NovaPrime18/CompressorController/Hardware/audit/board.png

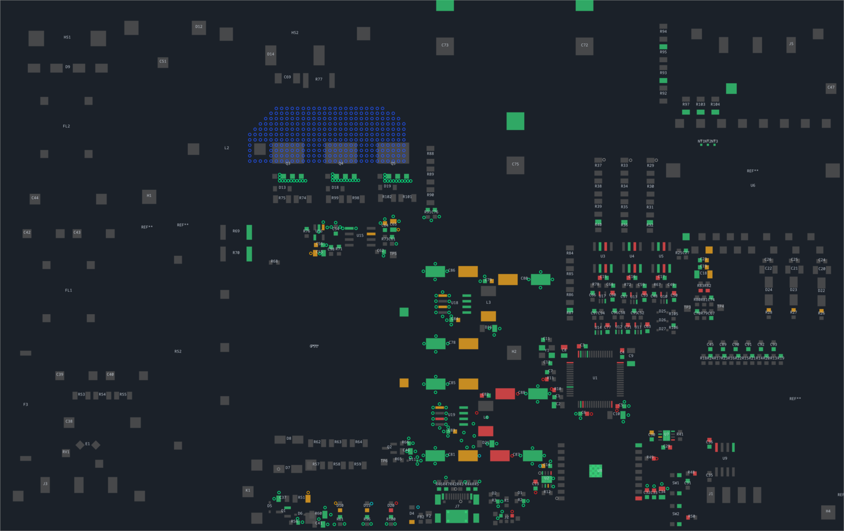
Hardware/audit/board.png
