NovaPrime18/CompressorController/Hardware/audit/can.png

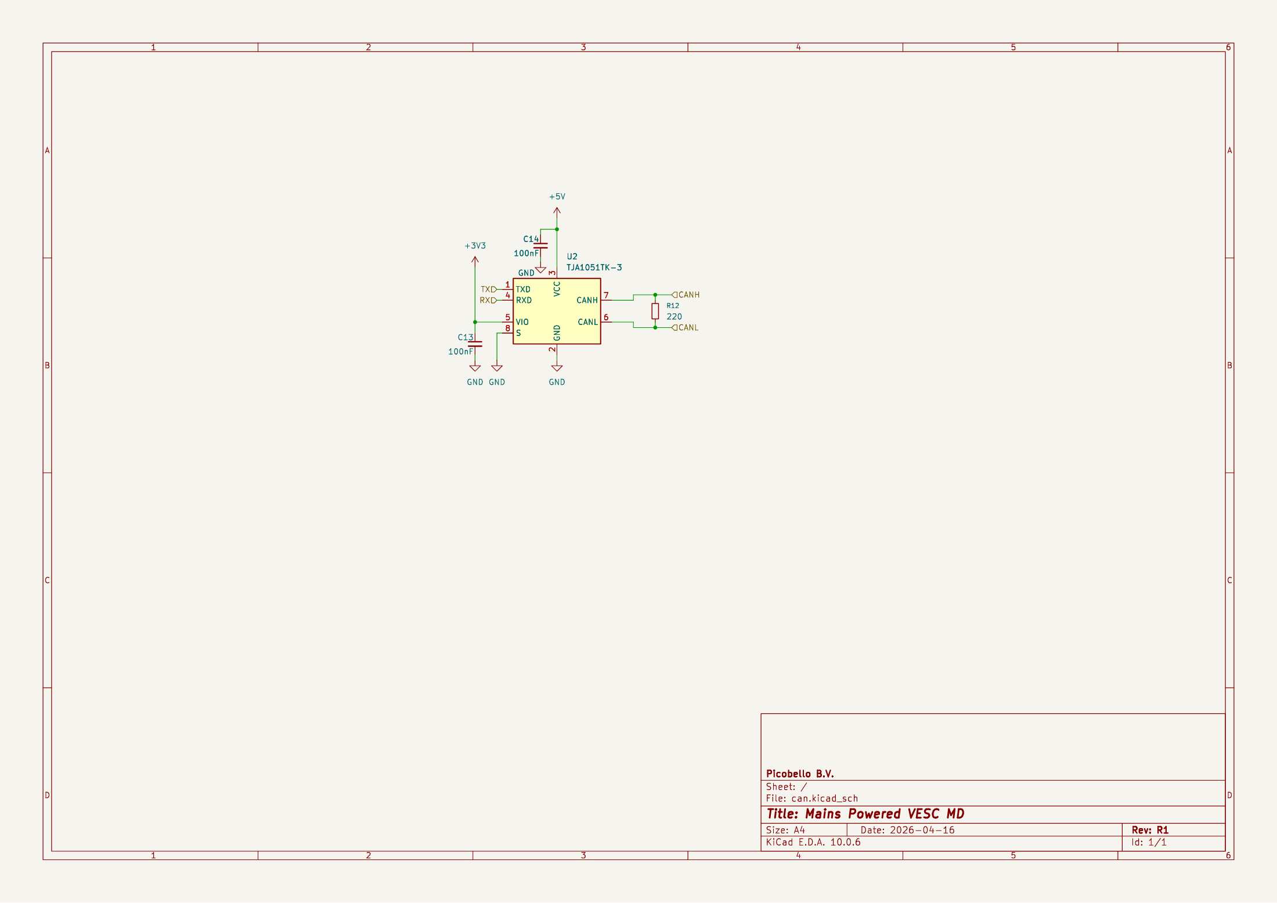
Hardware/audit/can.png
