NovaPrime18/CompressorController/Hardware/audit/crop_mask.png

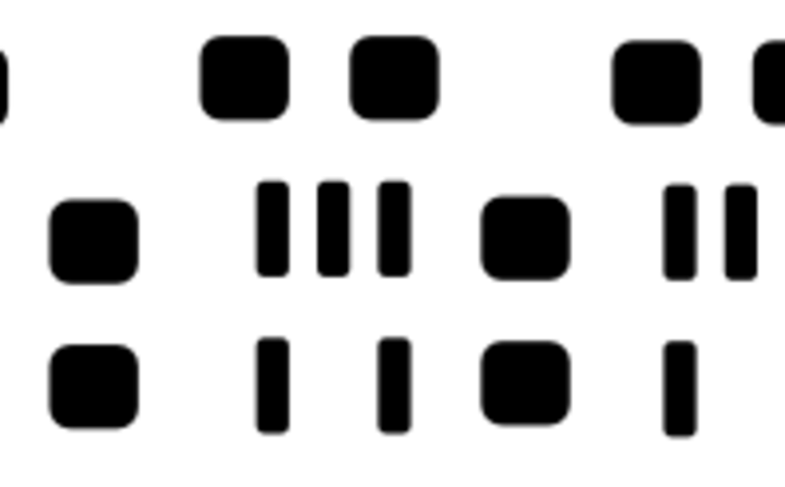
Hardware/audit/crop_mask.png
