NovaPrime18/CompressorController/Hardware/audit/crop_u12.png

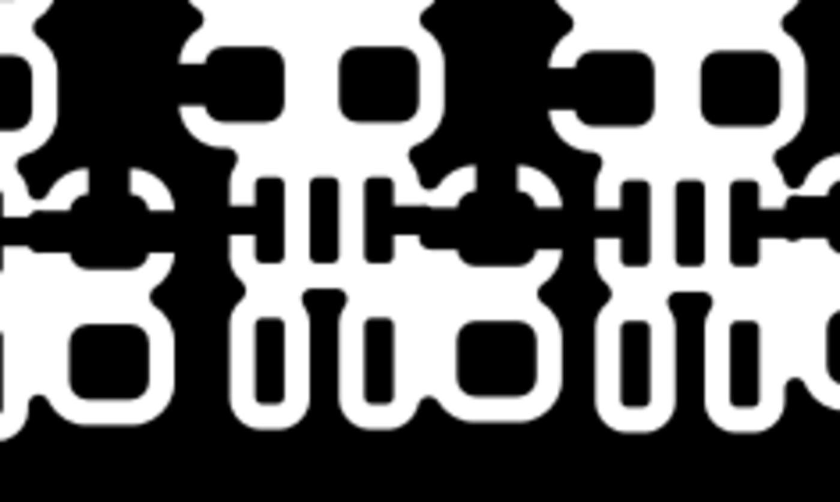
Hardware/audit/crop_u12.png
