NovaPrime18/CompressorController/Hardware/audit/express.png

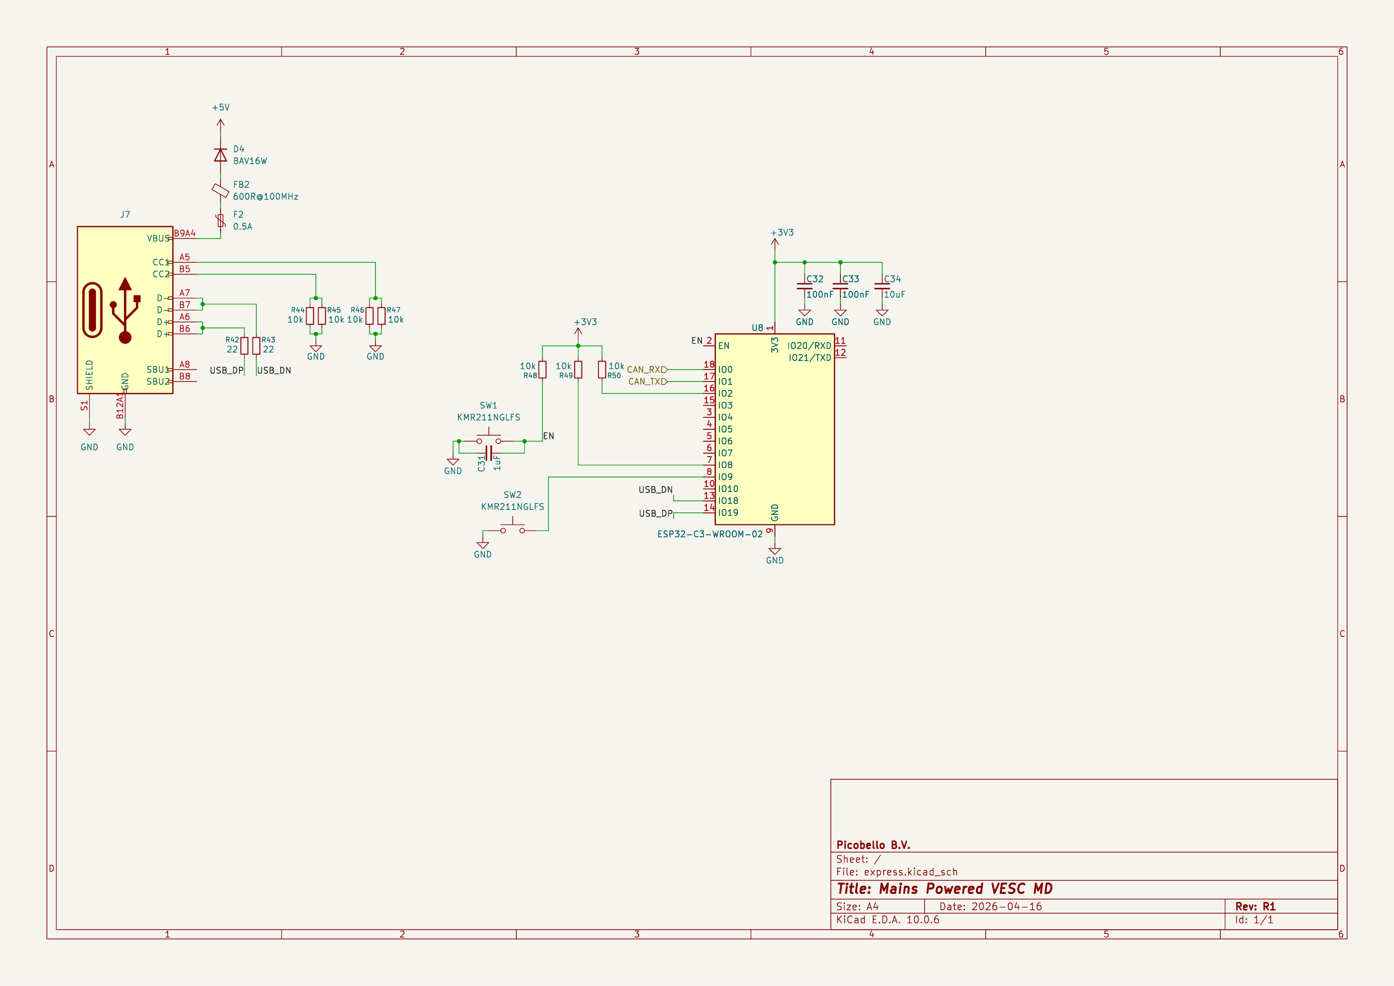
Hardware/audit/express.png
