NovaPrime18/CompressorController/Hardware/audit/f_all.png

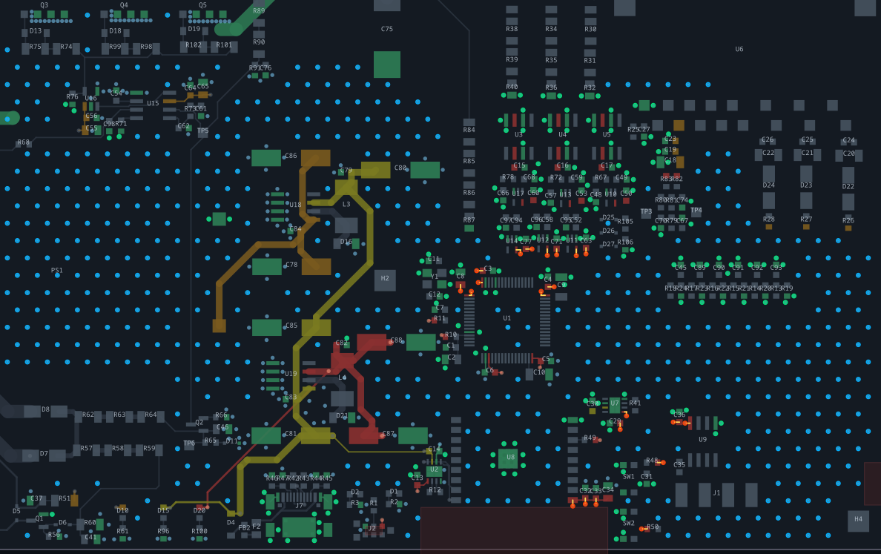
Hardware/audit/f_all.png
