NovaPrime18/CompressorController/Hardware/audit/f_lvc.png

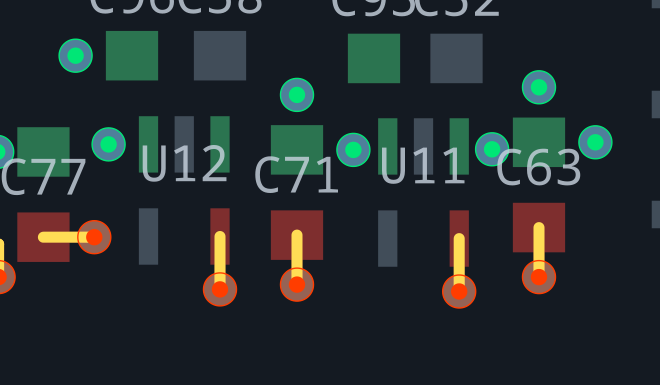
Hardware/audit/f_lvc.png
