NovaPrime18/CompressorController/Hardware/audit/f_u2.png

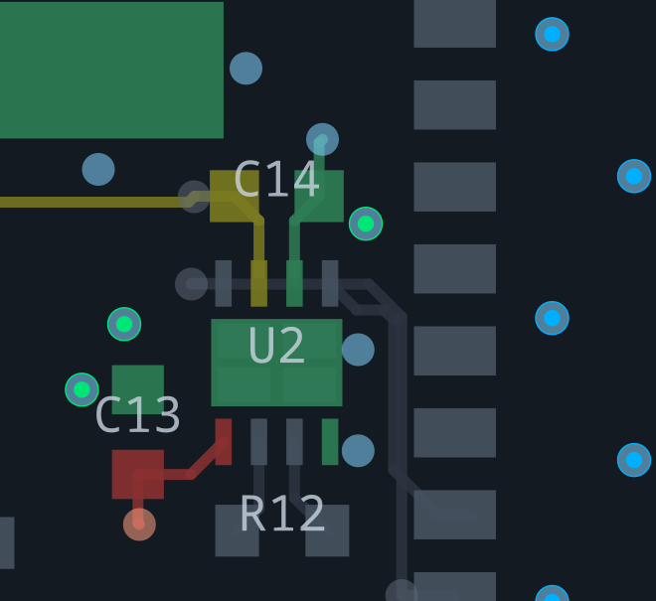
Hardware/audit/f_u2.png
