NovaPrime18/CompressorController/Hardware/audit/filters.png

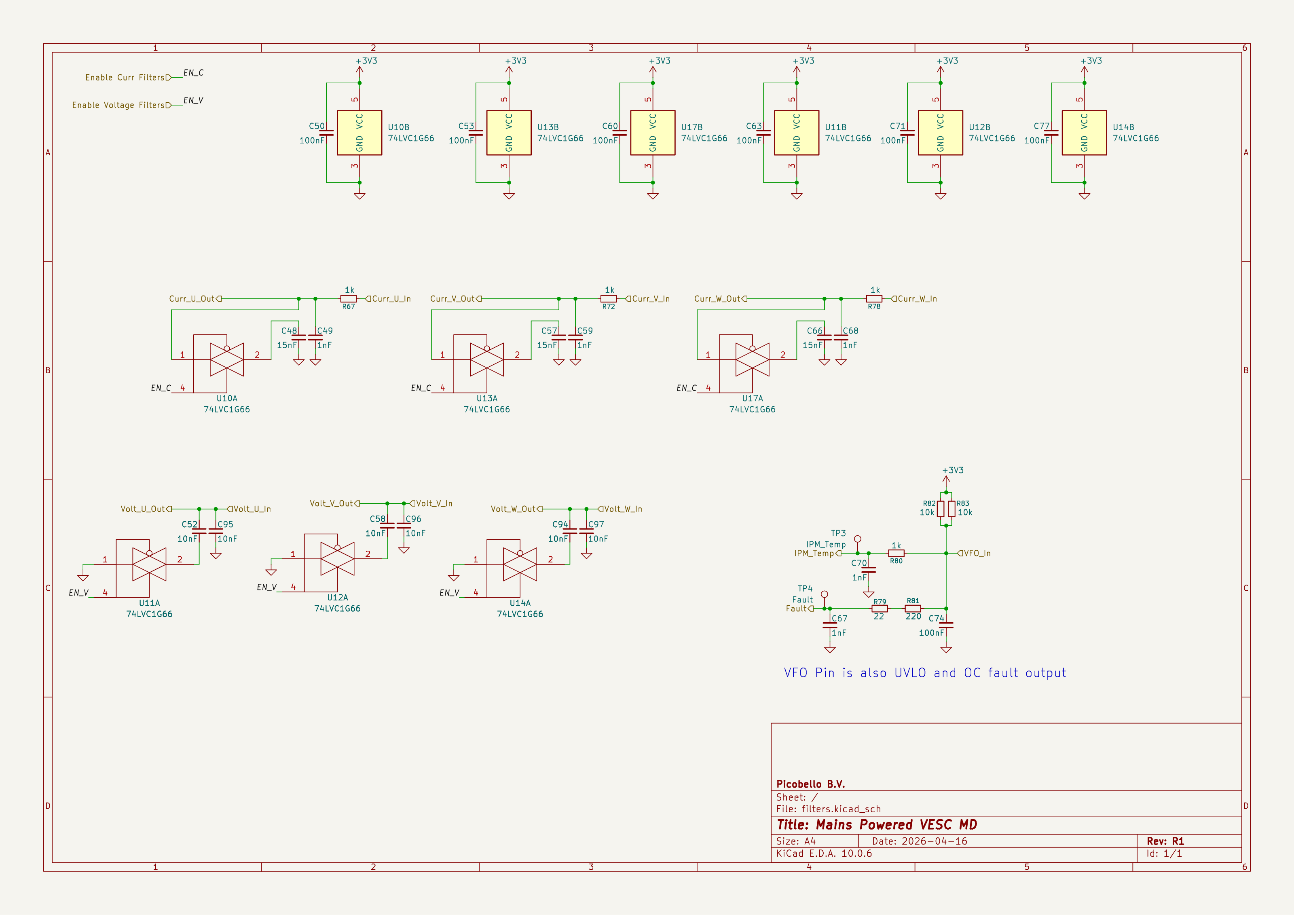
Hardware/audit/filters.png
