NovaPrime18/CompressorController/Hardware/audit/final_thin.png

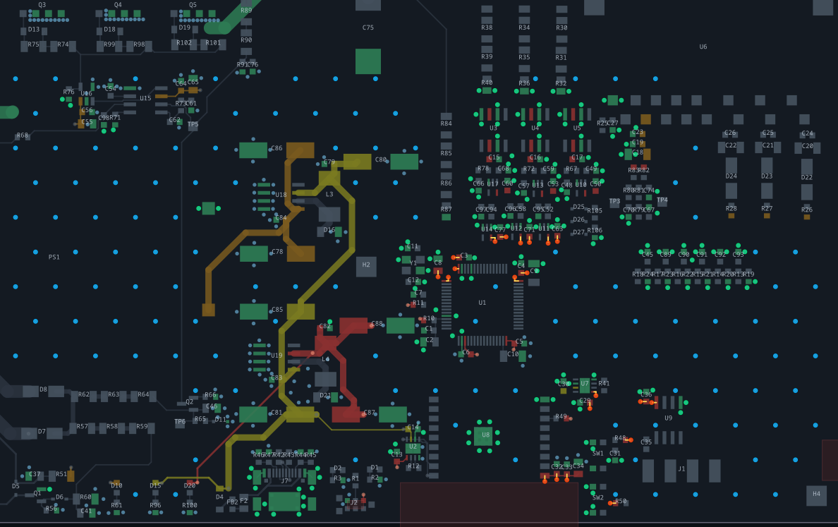
Hardware/audit/final_thin.png
