NovaPrime18/CompressorController/Hardware/audit/ikcm_crop.png

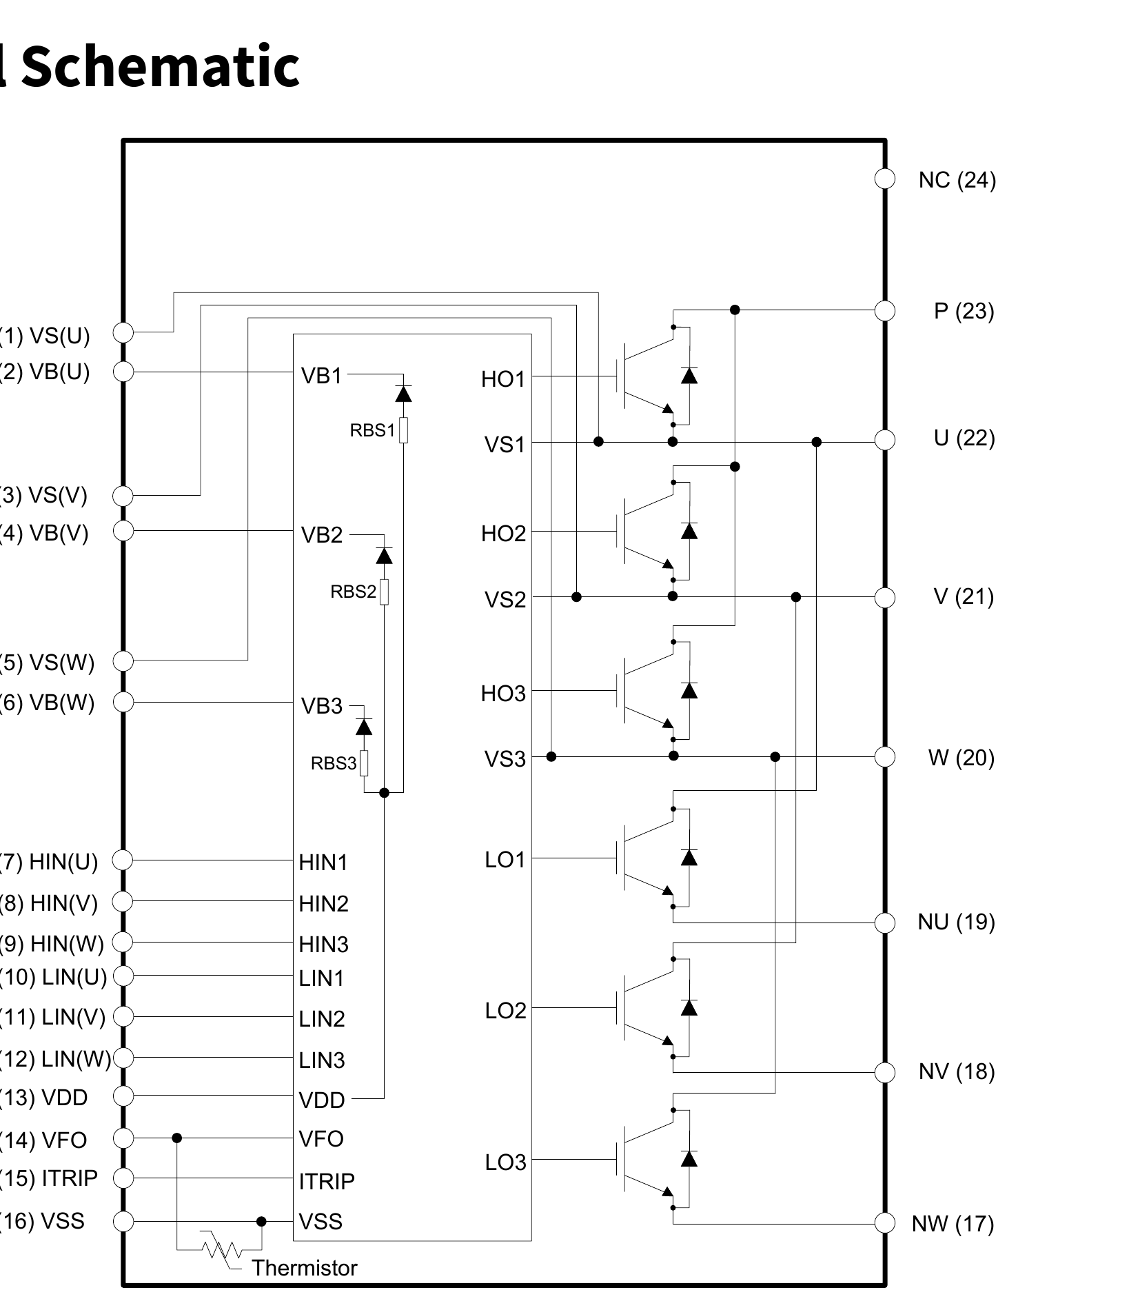
Hardware/audit/ikcm_crop.png
