NovaPrime18/CompressorController/Hardware/audit/isolator.png

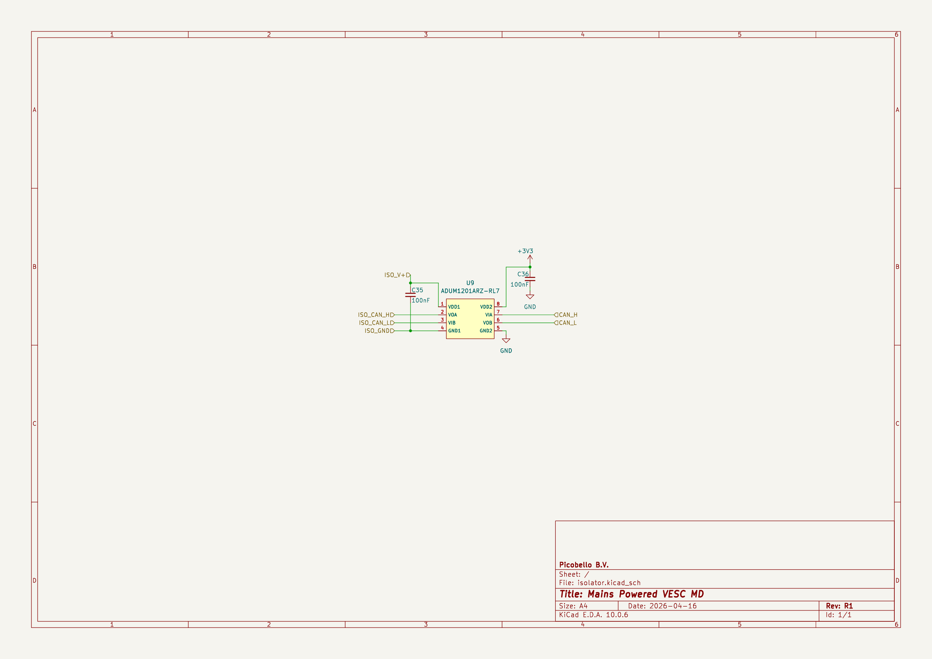
Hardware/audit/isolator.png
