NovaPrime18/CompressorController/Hardware/audit/itr_final_zoom.png

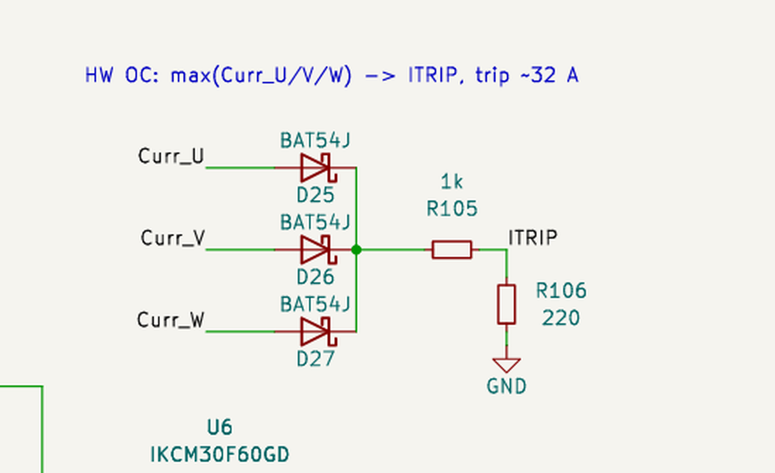
Hardware/audit/itr_final_zoom.png
