NovaPrime18/CompressorController/Hardware/audit/itr_zoom2.png

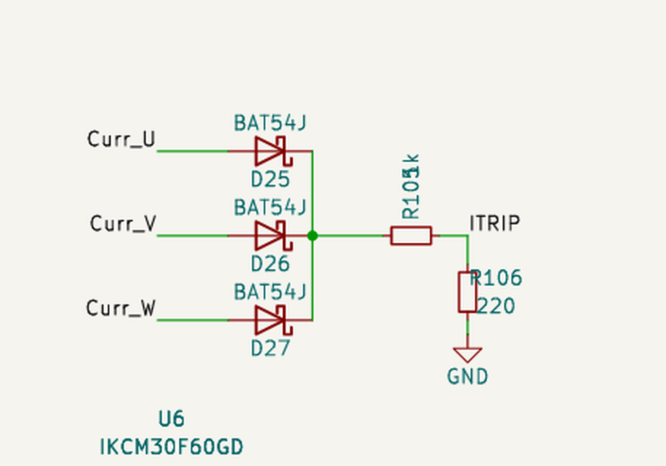
Hardware/audit/itr_zoom2.png
