NovaPrime18/CompressorController/Hardware/audit/itr_zoom4.png

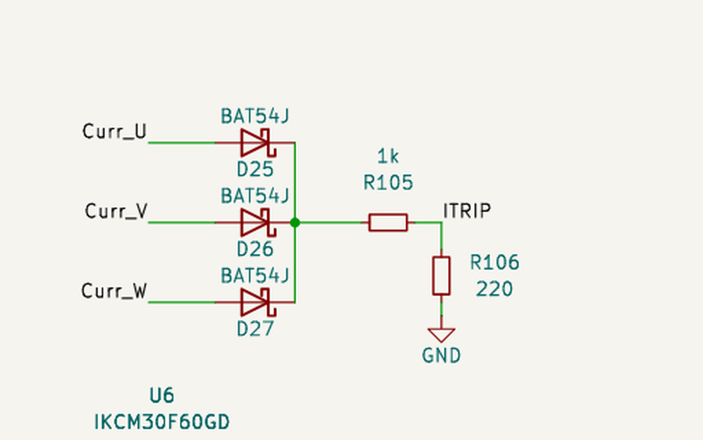
Hardware/audit/itr_zoom4.png
