NovaPrime18/CompressorController/Hardware/audit/itr_zoom.png

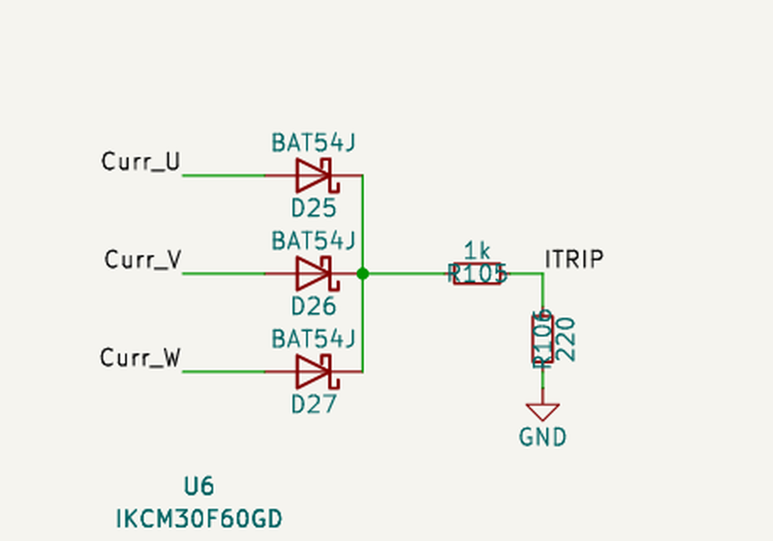
Hardware/audit/itr_zoom.png
