NovaPrime18/CompressorController/Hardware/audit/lvpower.png

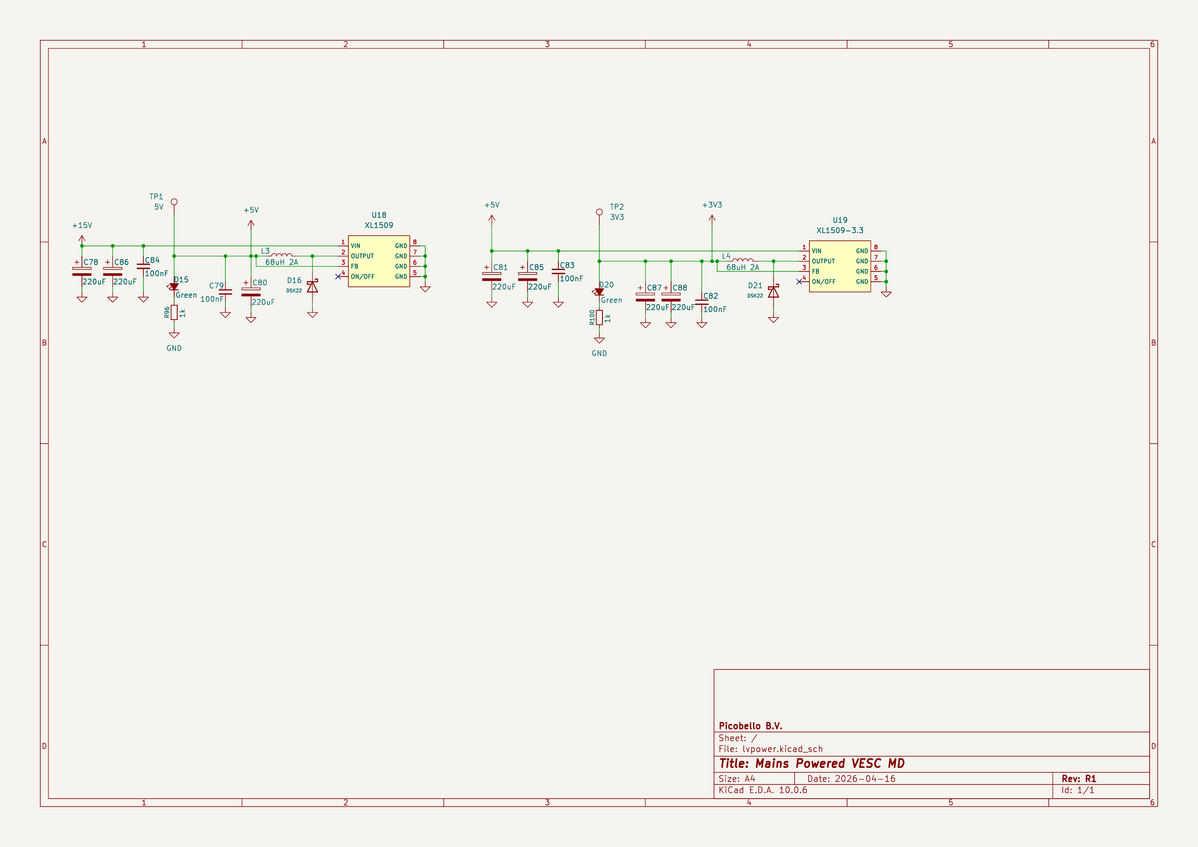
Hardware/audit/lvpower.png
