NovaPrime18/CompressorController/Hardware/audit/mcu.png

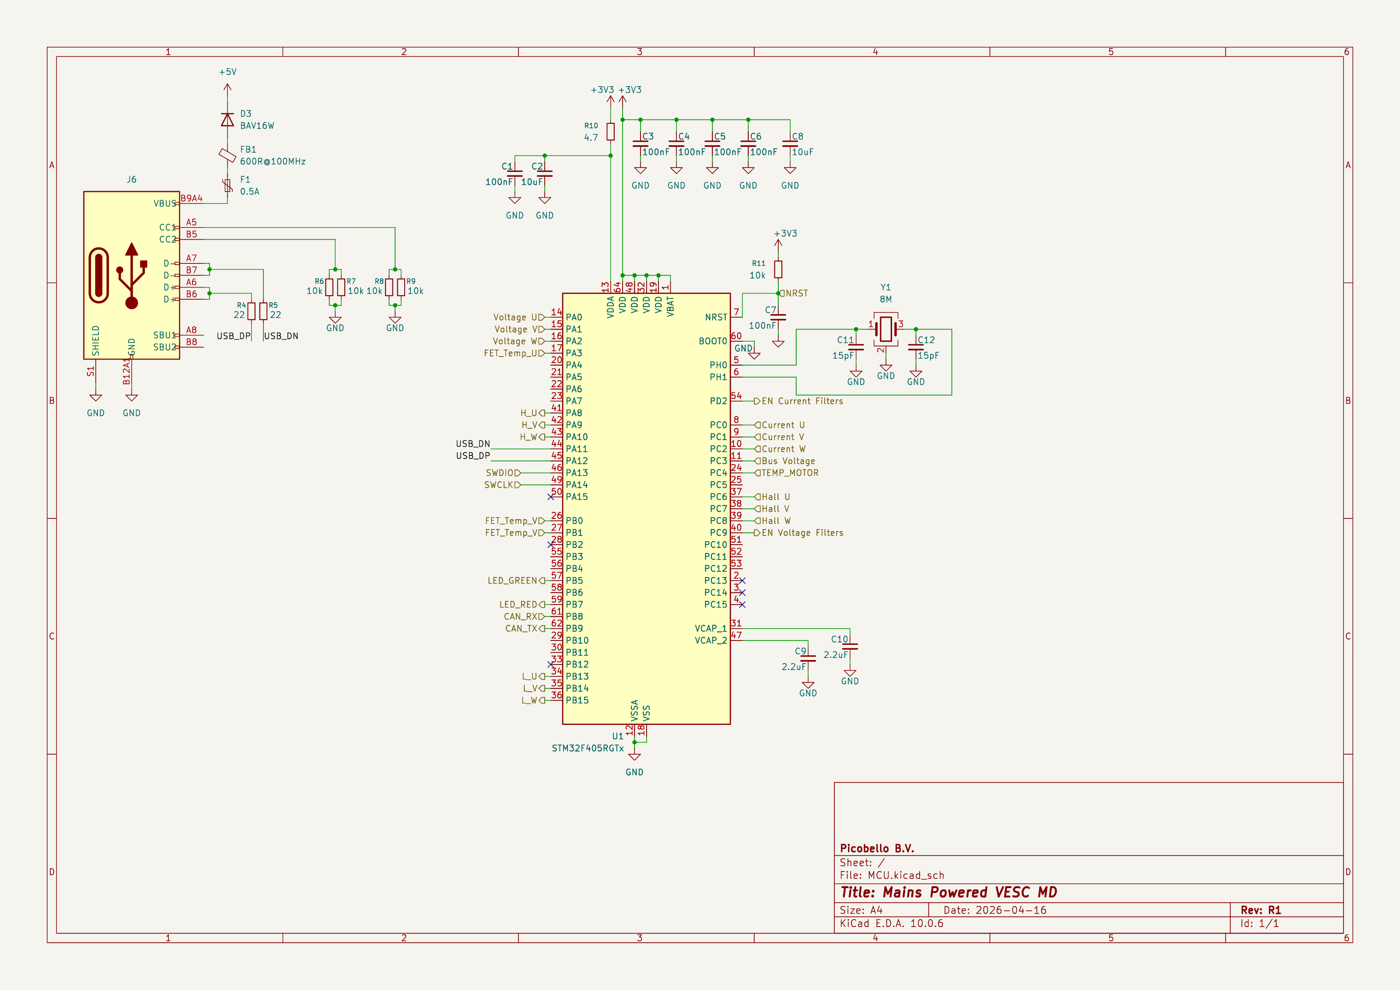
Hardware/audit/mcu.png
