NovaPrime18/CompressorController/Hardware/audit/p4-04.png

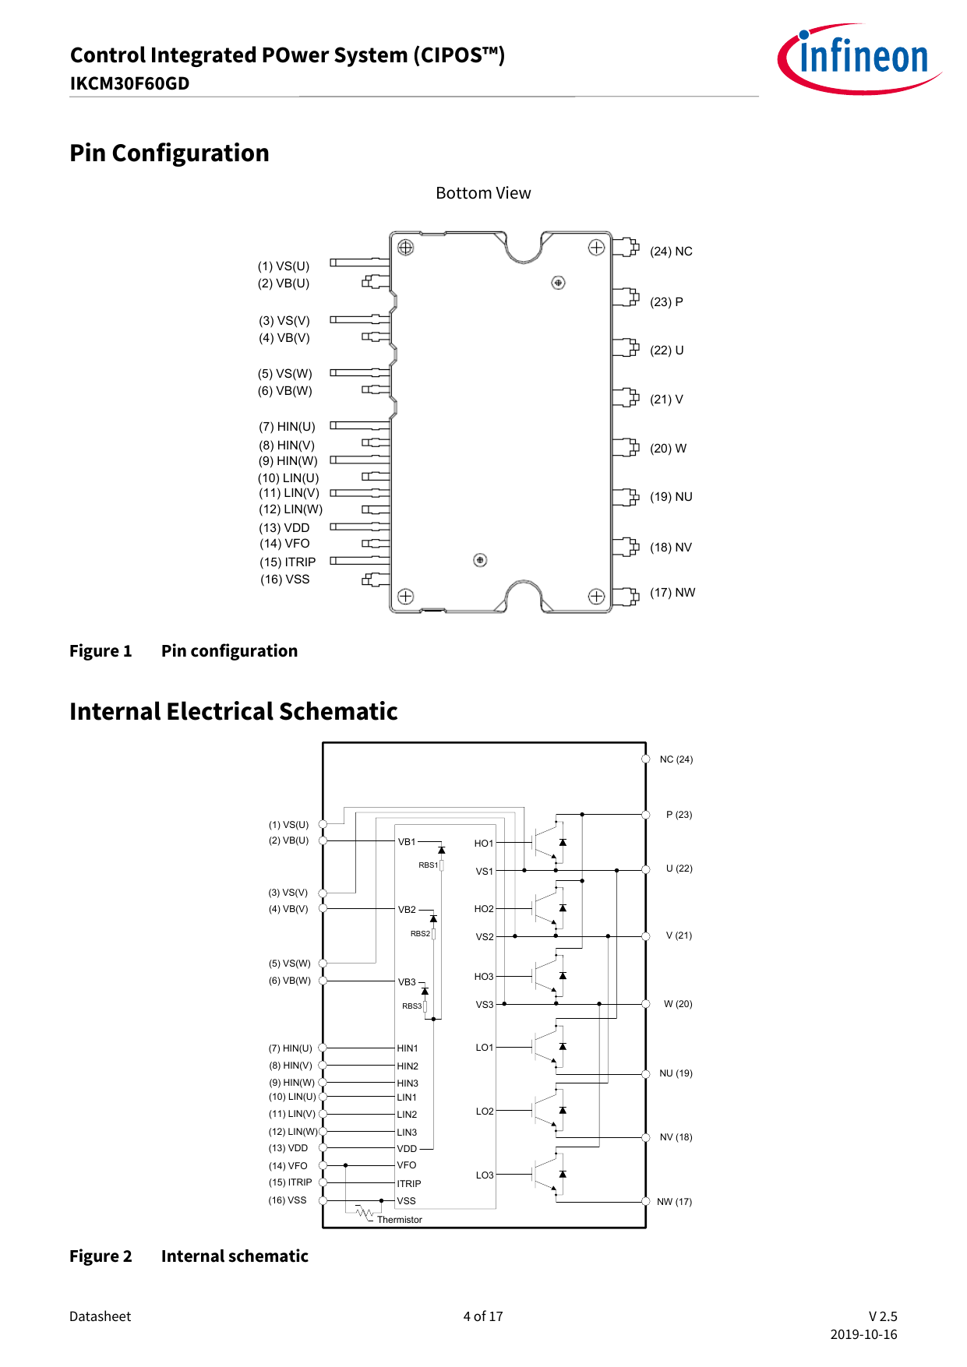
Hardware/audit/p4-04.png
