NovaPrime18/CompressorController/Hardware/audit/p4hi-04.png

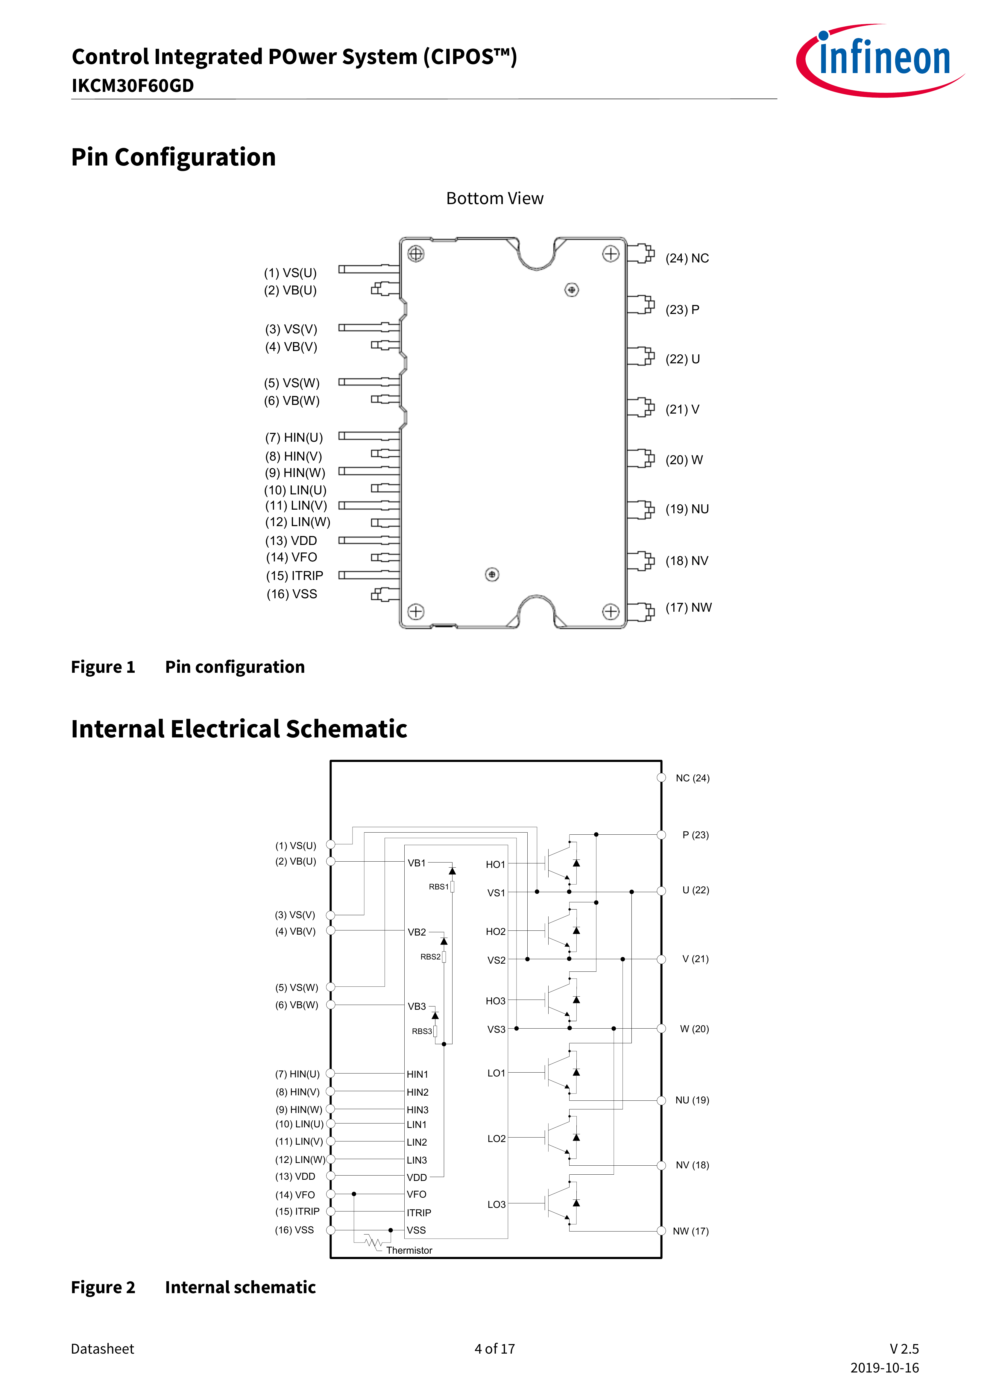
Hardware/audit/p4hi-04.png
