NovaPrime18/CompressorController/Hardware/audit/p12-12.png

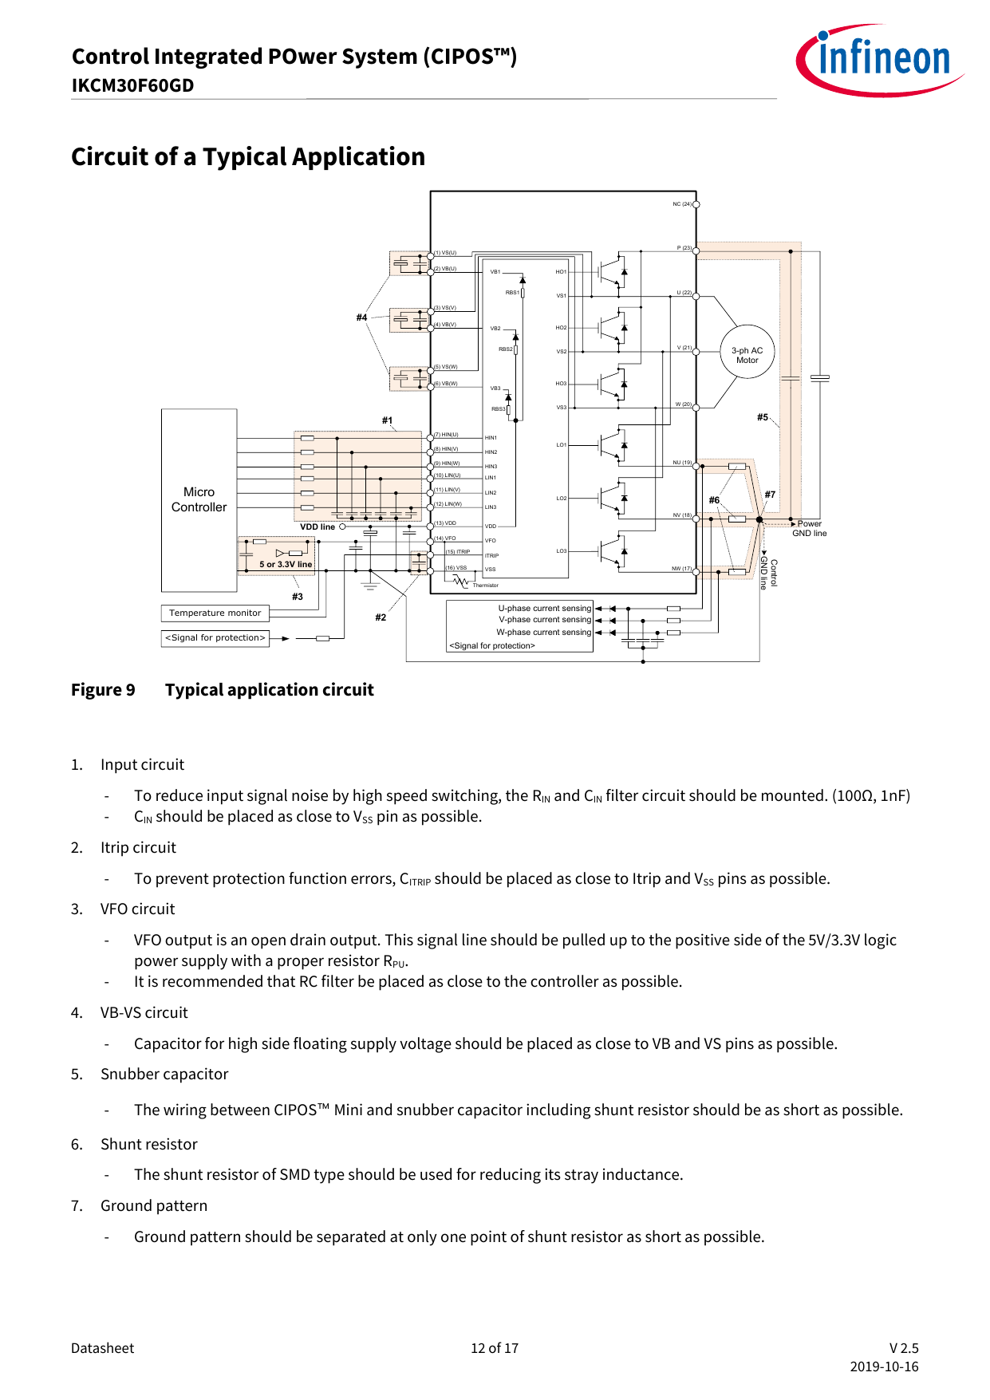
Hardware/audit/p12-12.png
