NovaPrime18/CompressorController/Hardware/audit/pfc.png

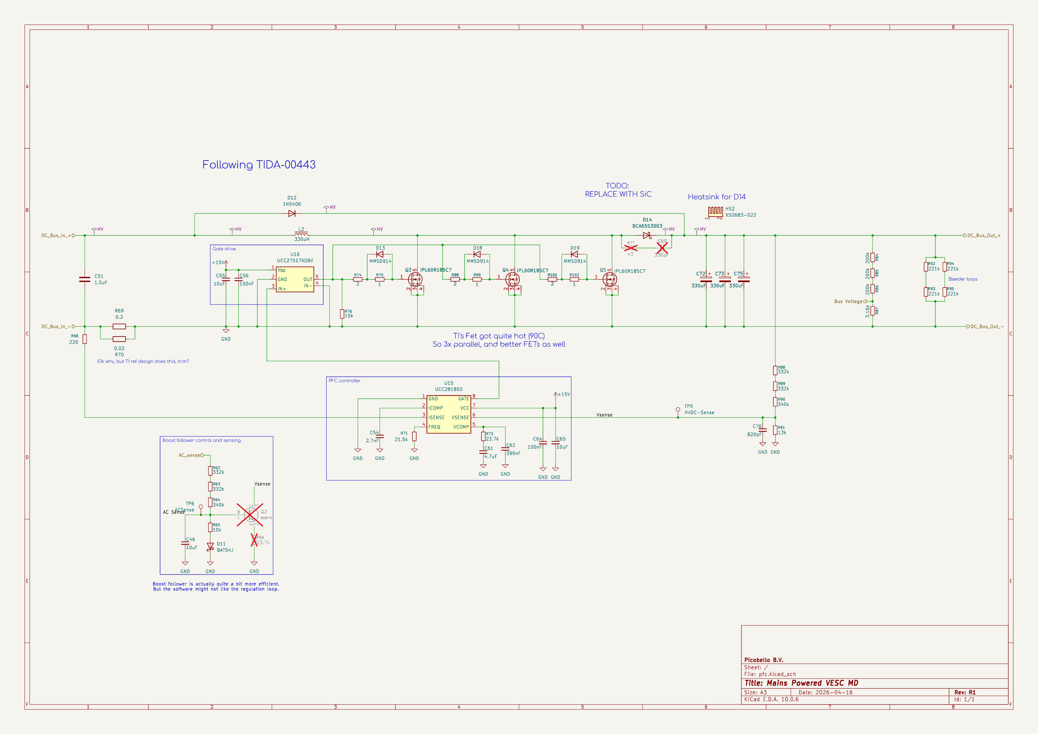
Hardware/audit/pfc.png
