NovaPrime18/CompressorController/Hardware/audit/phases2.png

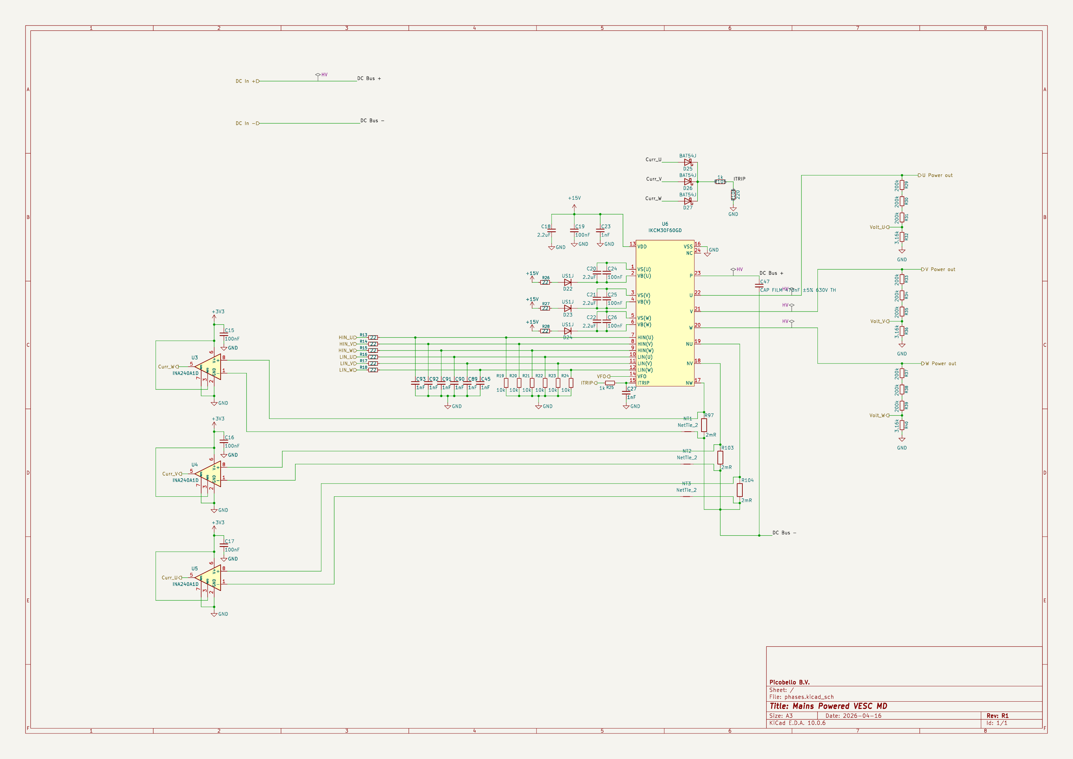
Hardware/audit/phases2.png
