NovaPrime18/CompressorController/Hardware/audit/powerin.png

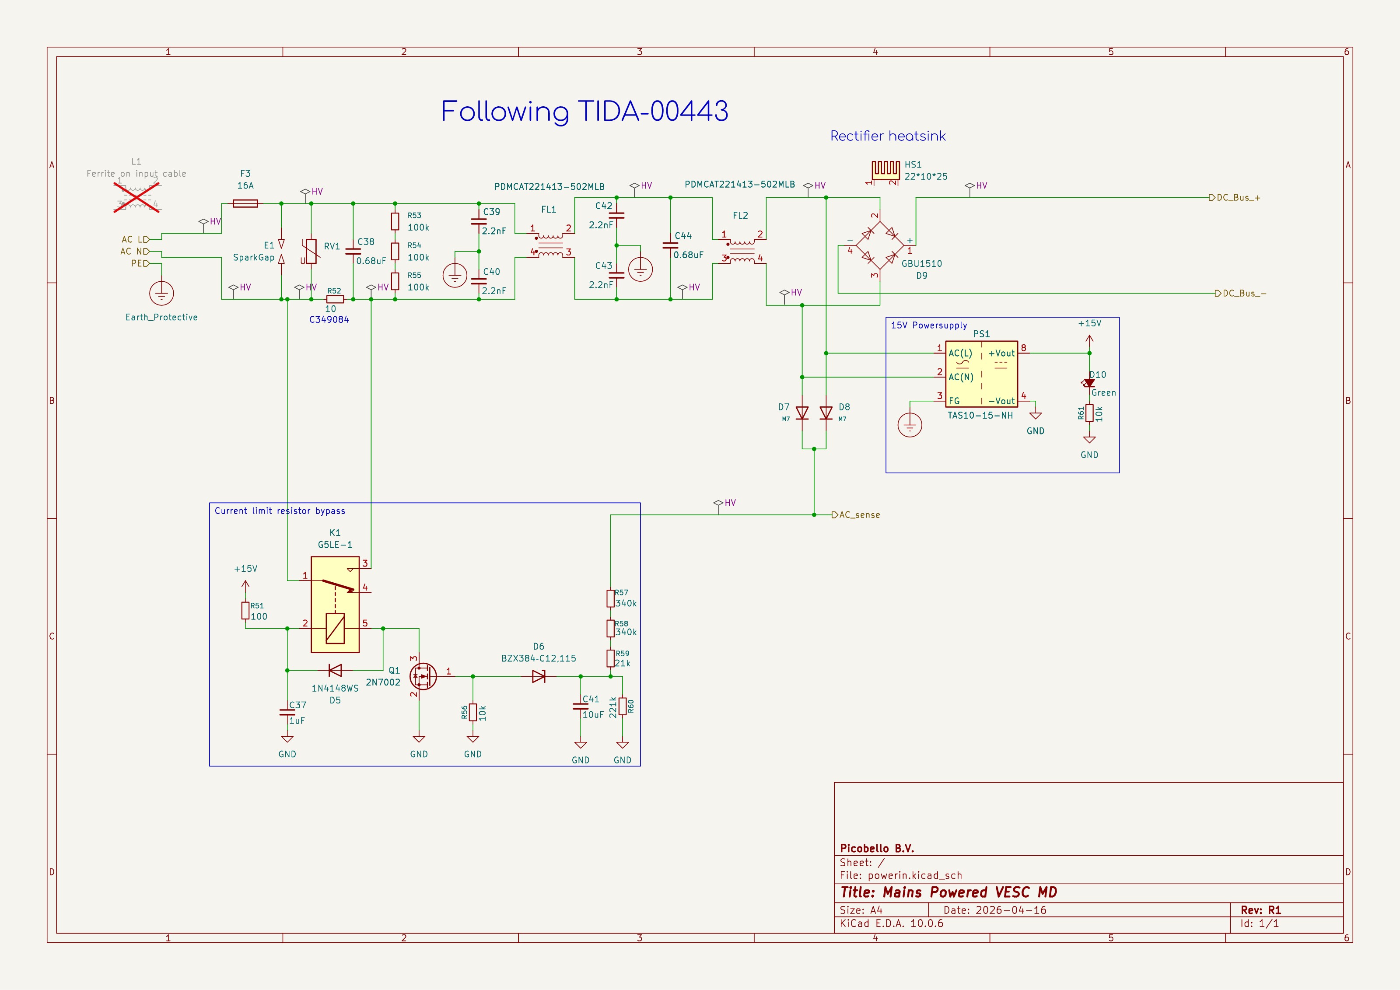
Hardware/audit/powerin.png
