NovaPrime18/CompressorController/Hardware/audit/root.png

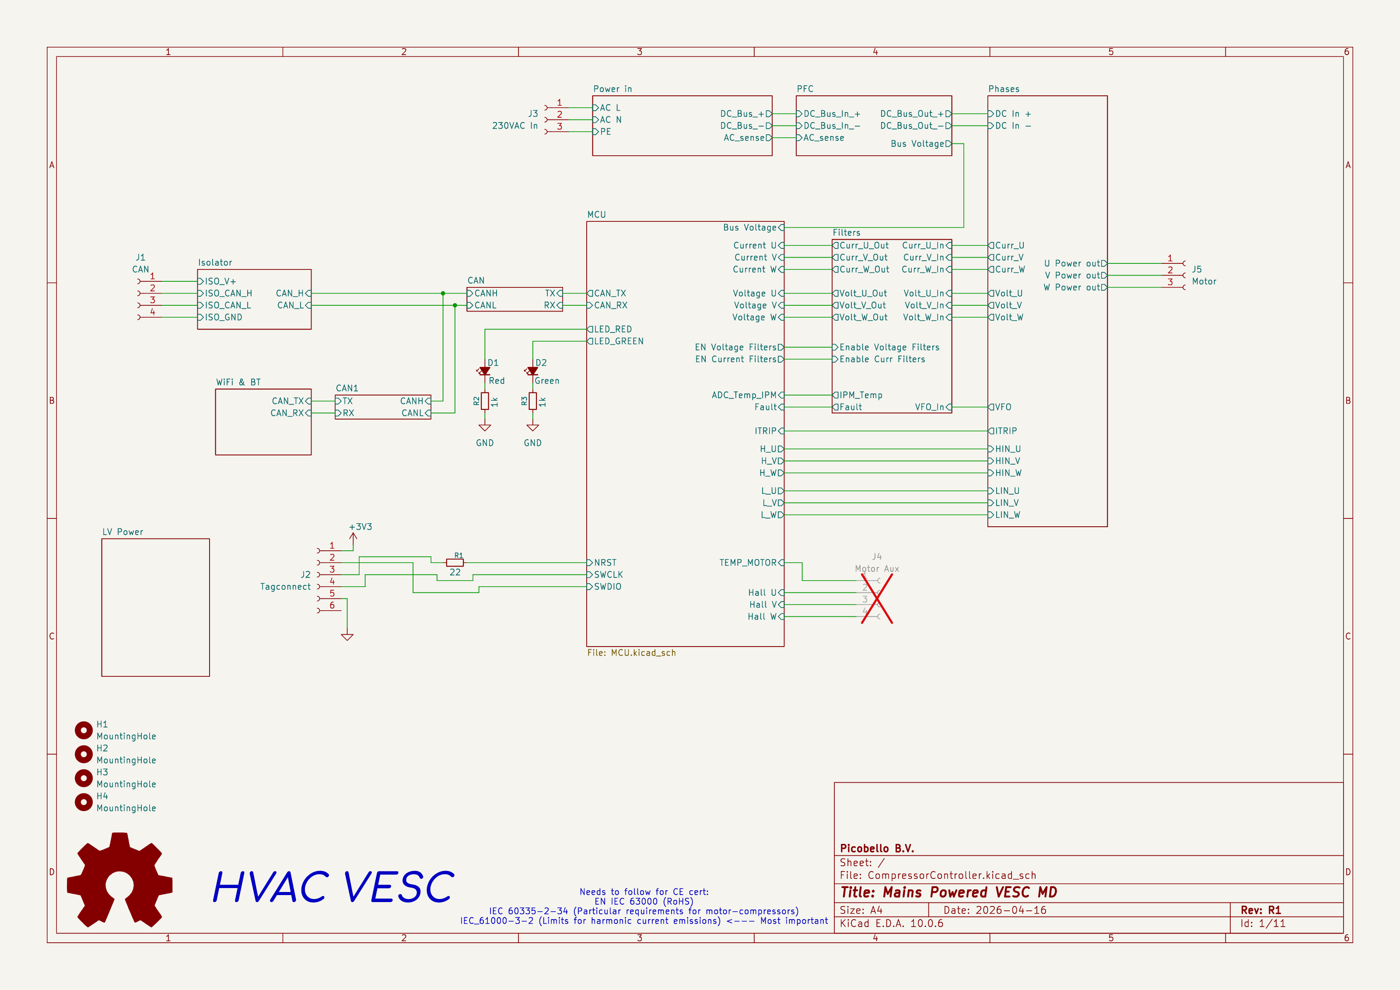
Hardware/audit/root.png
