NovaPrime18/CompressorController/Hardware/audit/svg/B.Cu.png

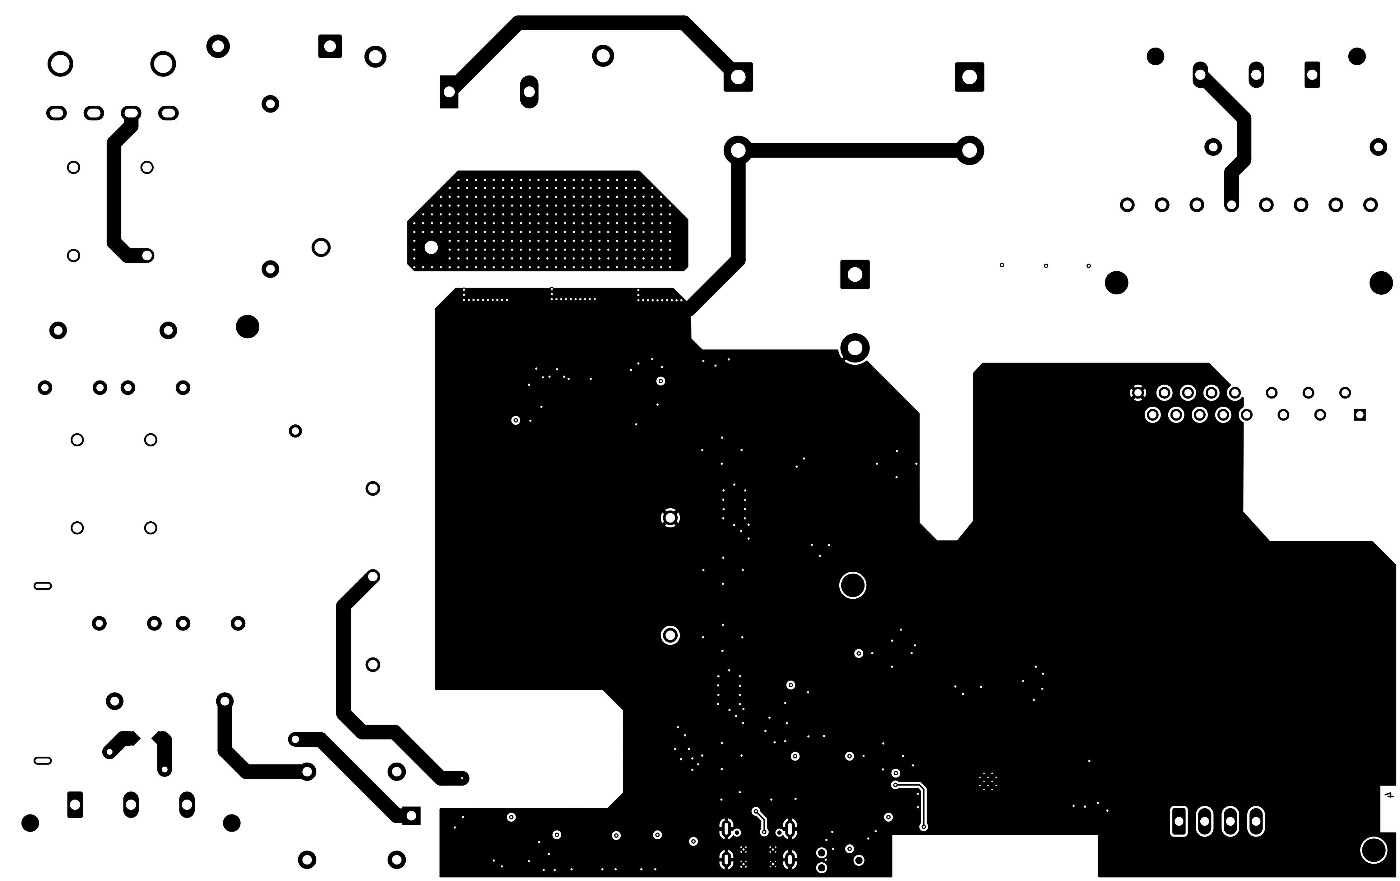
Hardware/audit/svg/B.Cu.png
