NovaPrime18/CompressorController/Hardware/audit/svg/copper.png

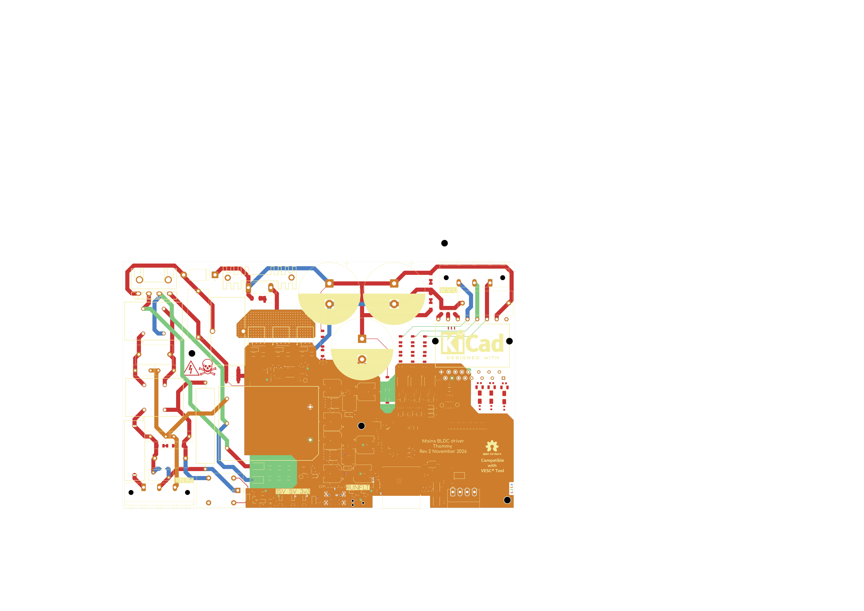
Hardware/audit/svg/copper.png
