NovaPrime18/CompressorController/Hardware/audit/svg/F.Cu.png

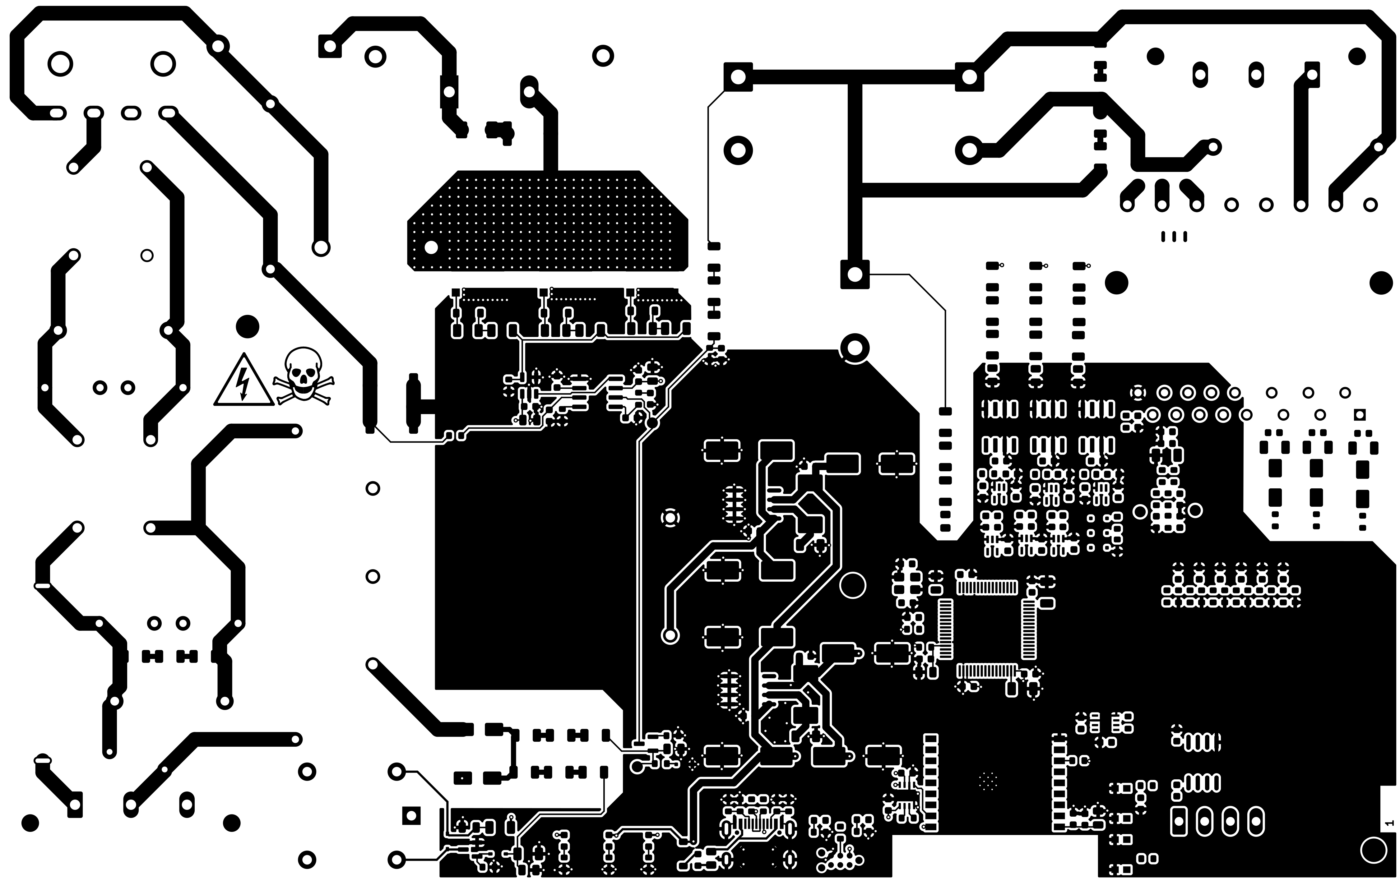
Hardware/audit/svg/F.Cu.png
