NovaPrime18/CompressorController/Hardware/audit/svg/F_power.png

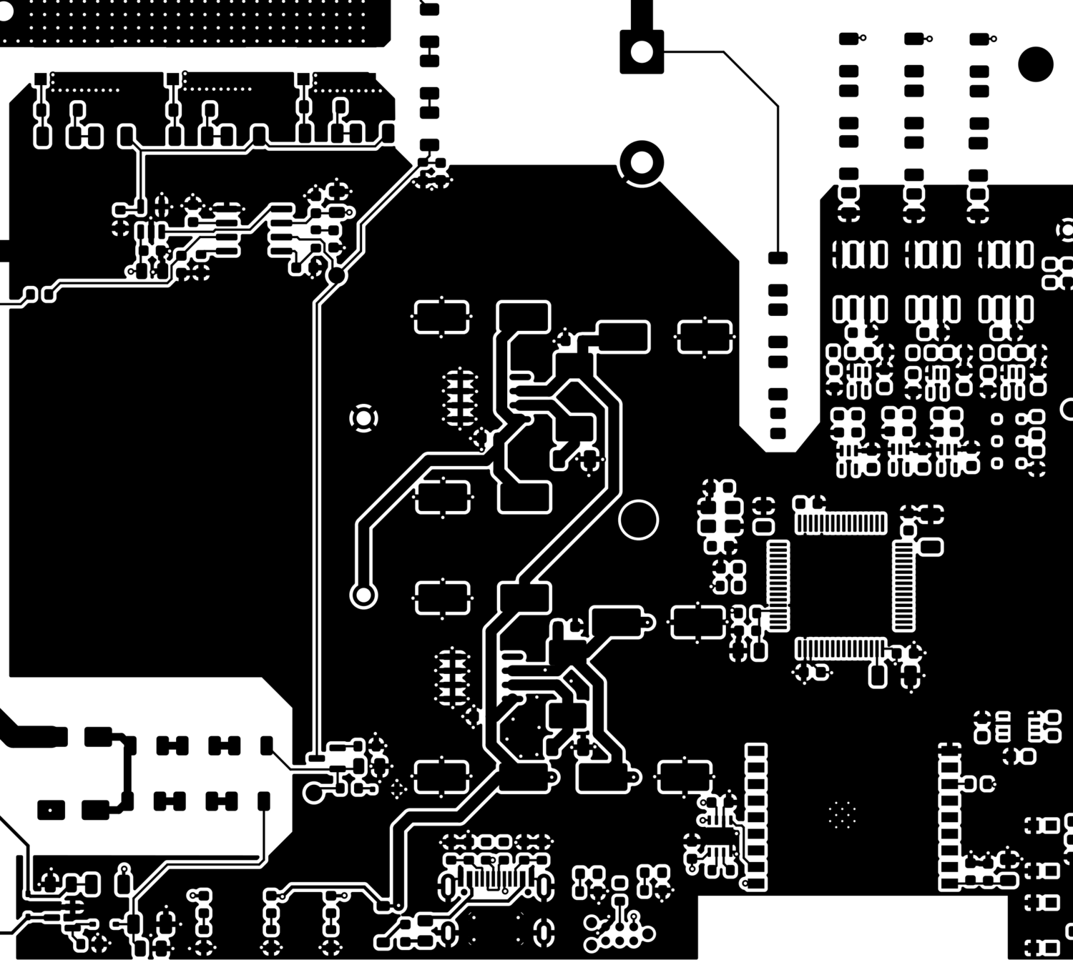
Hardware/audit/svg/F_power.png
