NovaPrime18/CompressorController/Hardware/audit/svg/FMask.png

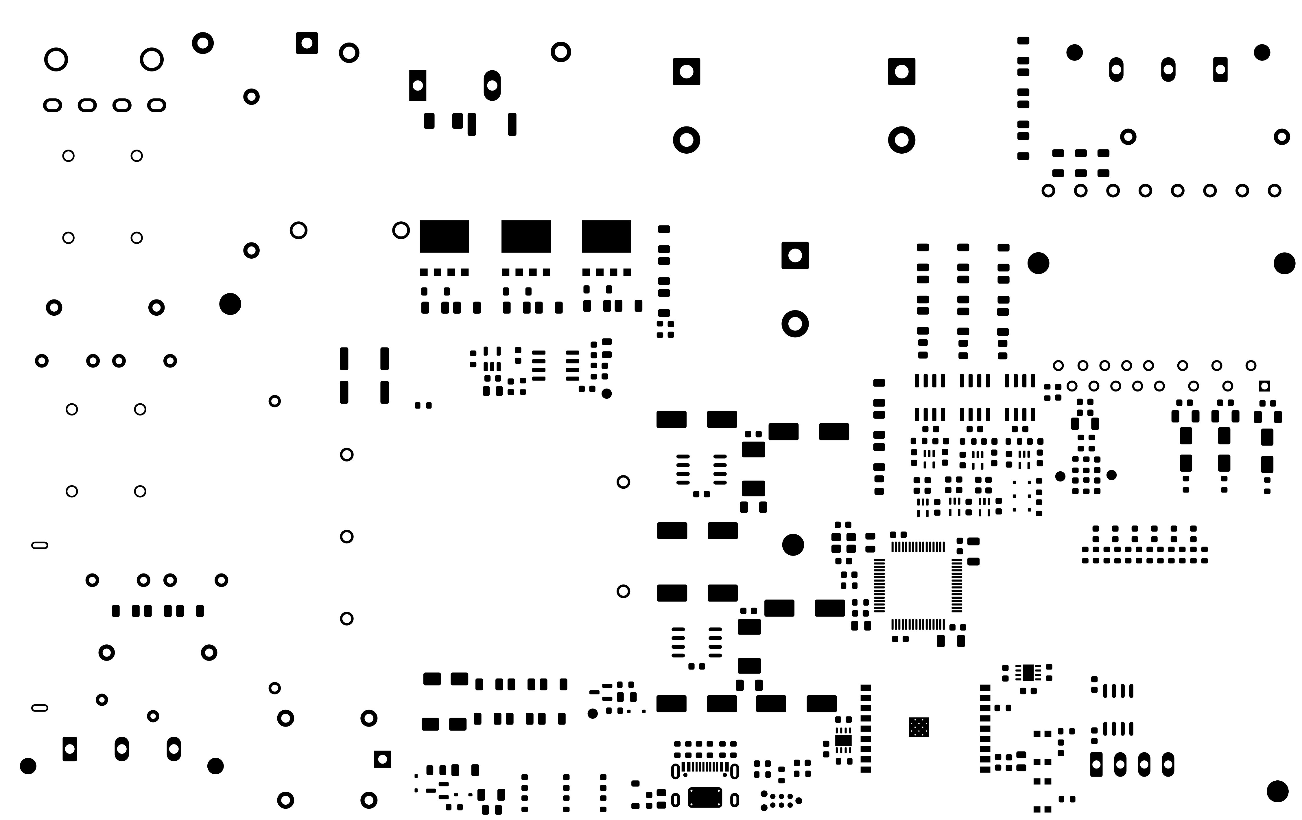
Hardware/audit/svg/FMask.png
