NovaPrime18/CompressorController/Hardware/audit/svg/In1.Cu.png

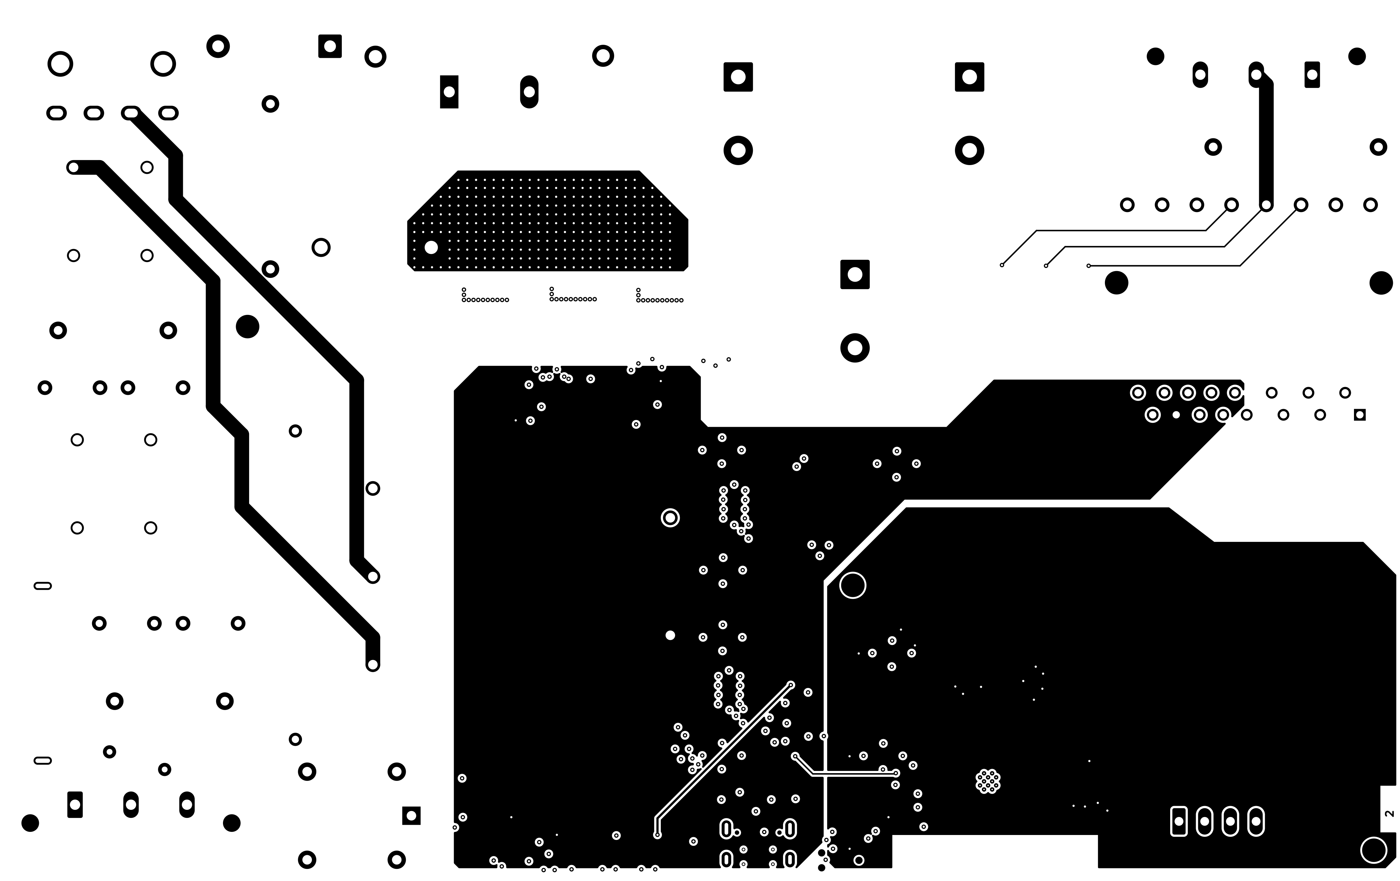
Hardware/audit/svg/In1.Cu.png
