NovaPrime18/CompressorController/Hardware/audit/svg/In2.Cu.png

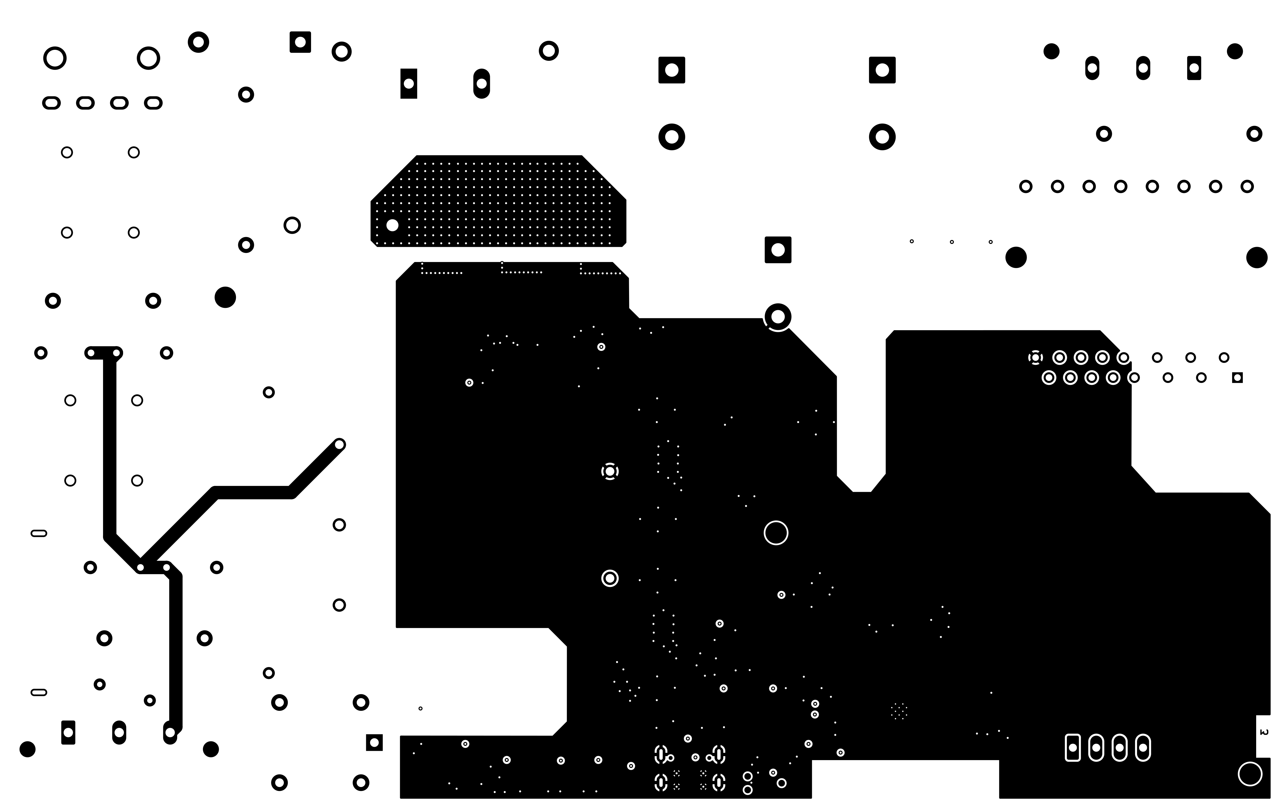
Hardware/audit/svg/In2.Cu.png
