NovaPrime18/CompressorController/Hardware/audit/z_can.png

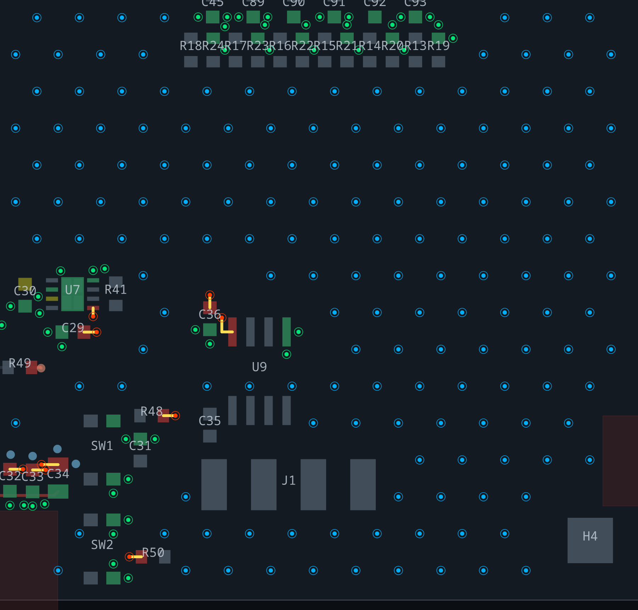
Hardware/audit/z_can.png
