NovaPrime18/CompressorController/Hardware/audit/z_mcu.png

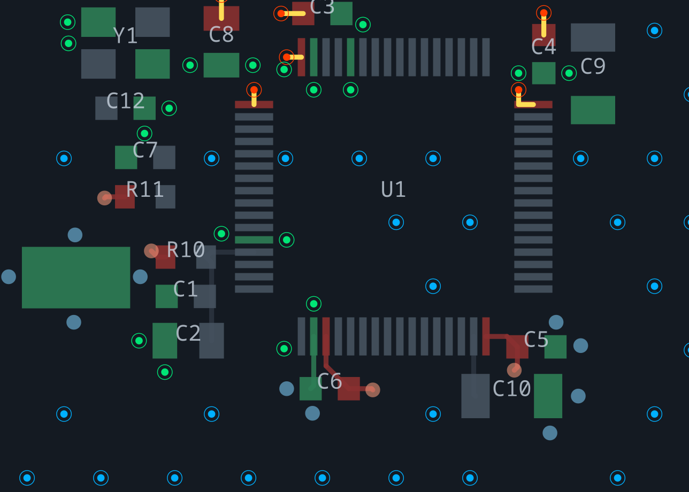
Hardware/audit/z_mcu.png
