NovaPrime18/CompressorController/Hardware/audit/z_pwr.png

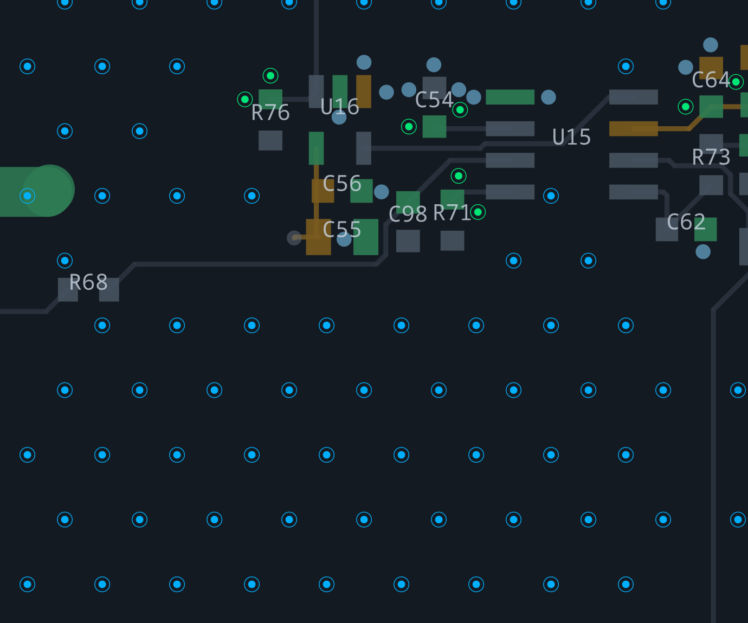
Hardware/audit/z_pwr.png
