NovaPrime18/CompressorController/Hardware/audit/z_u2.png

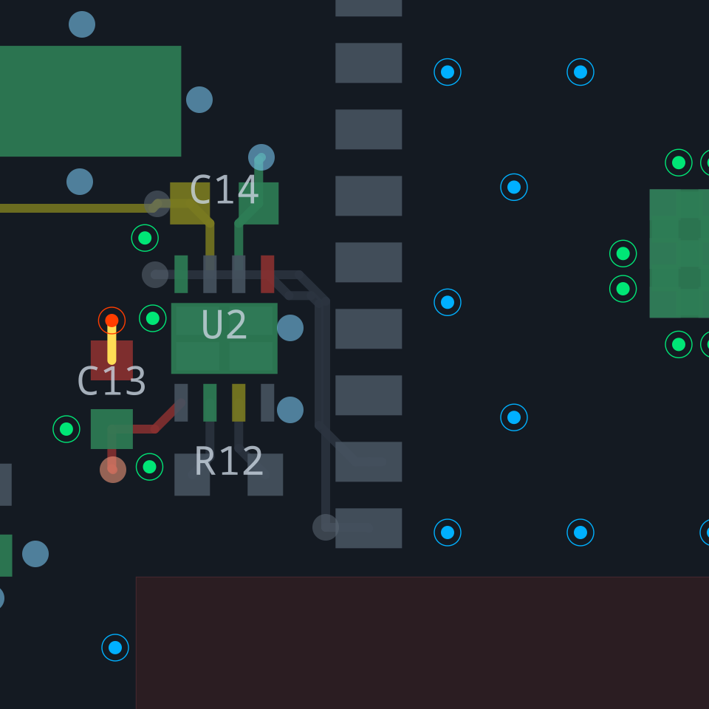
Hardware/audit/z_u2.png
