NovaPrime18/CompressorController/Hardware/audit/zoom_mcu.png

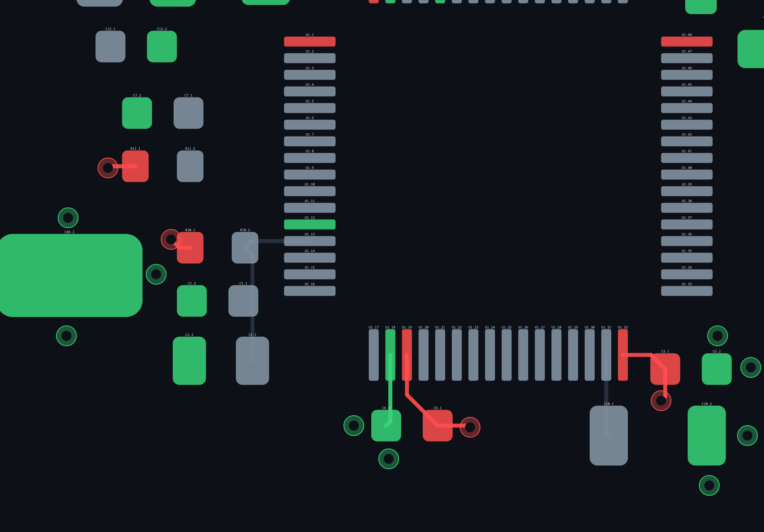
Hardware/audit/zoom_mcu.png
