NovaPrime18/CompressorController/Hardware/pdf/CompressorController.pdf

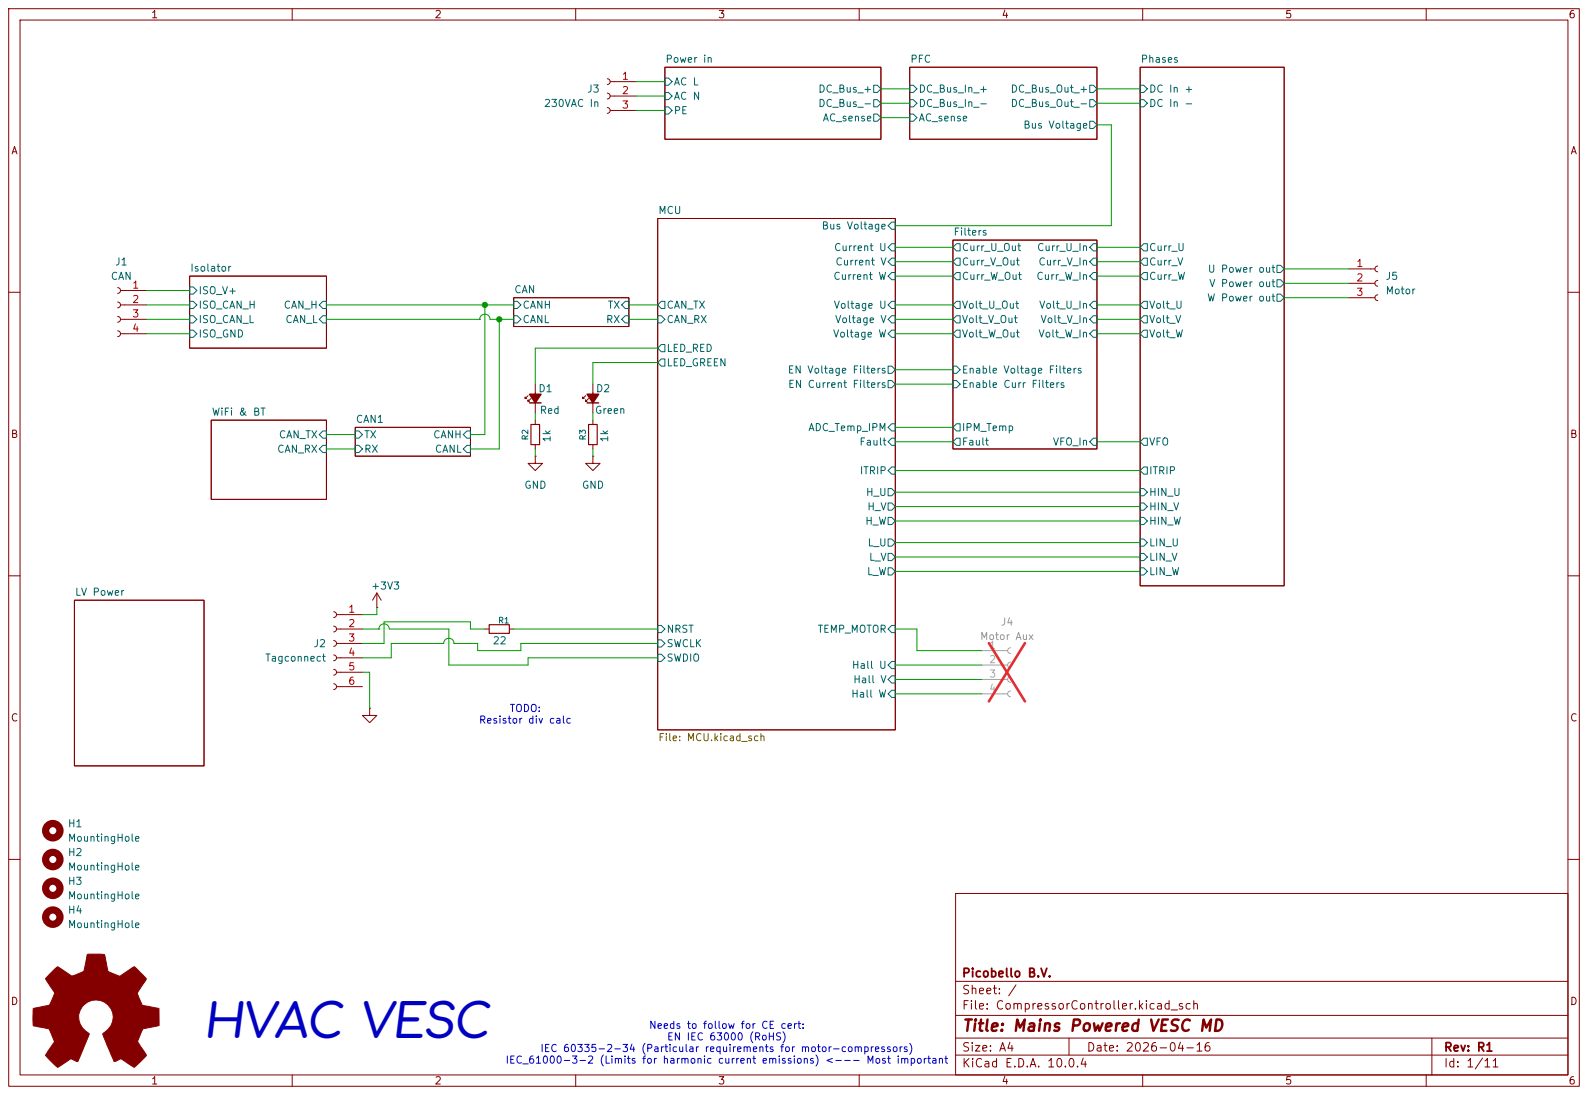
[picture p40: page 1]

Bus Voltage SWCLK NRST SWDIO

U Power out V Power out W Power out HIN_U
Curr_W

EN Voltage Filters EN Current Filters ADC_Temp_IPM

IEC_61000-3-2 (Limits for harmonic current emissions) <--- Most important TODO: Resistor div calc

Picobello B.V.
Sheet: /
File: CompressorController.kicad_sch
Title: Mains Powered VESC MD

IEC 60335-2-34 (Particular requirements for motor-compressors)

Size: A4 | Rev: R1
KiCad E.D.A. 10.0.4 | Id: 1/11

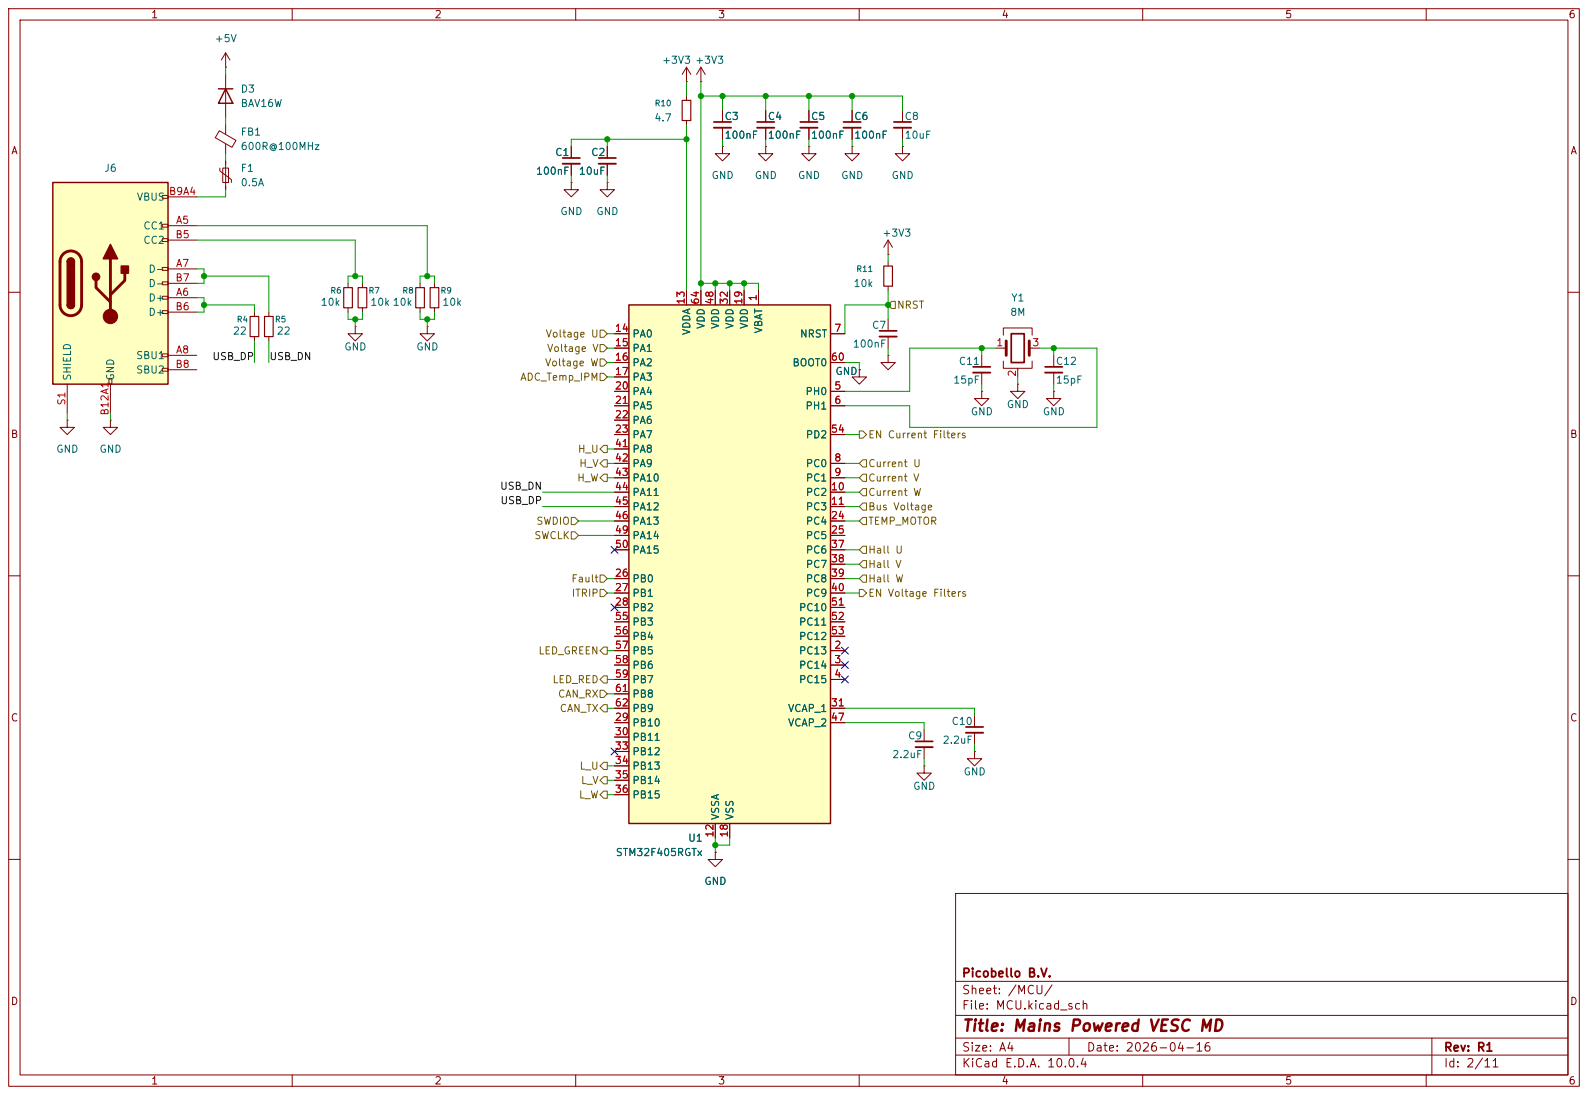
[picture p41: page 2]

Bus Voltage EN Voltage Filters Current U

Picobello B.V.
Sheet: /MCU/
File: MCU.kicad_sch
Title: Mains Powered VESC MD

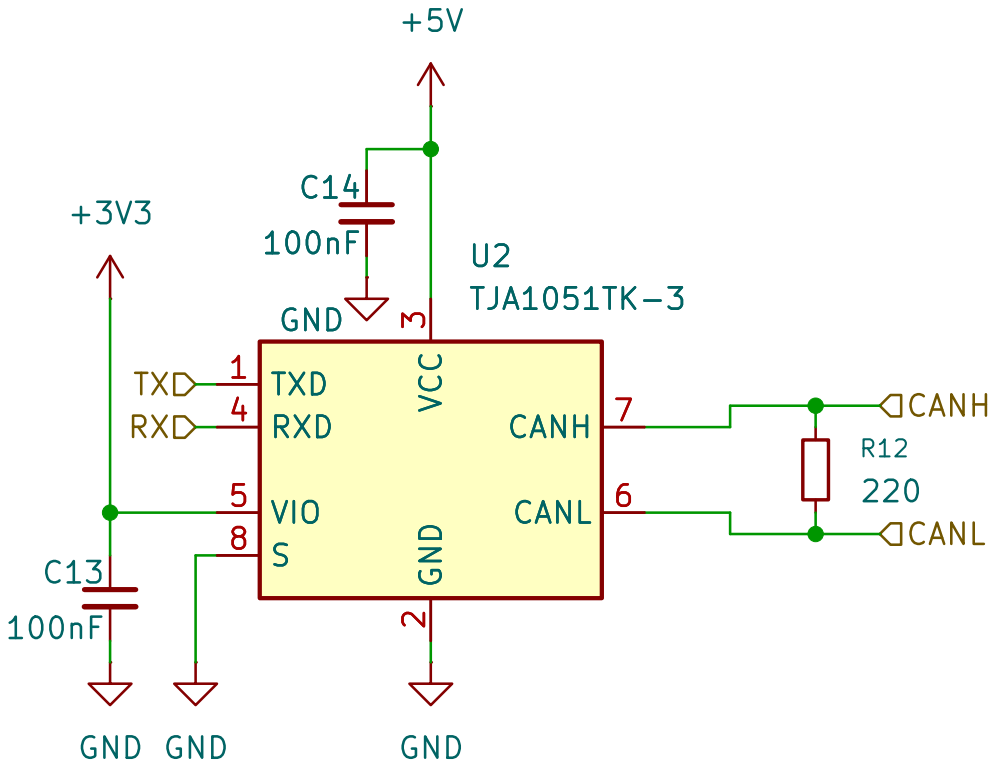
[picture p42: page 3]

Picobello B.V.
Sheet: /CAN1/
File: can.kicad_sch
Title: Mains Powered VESC MD

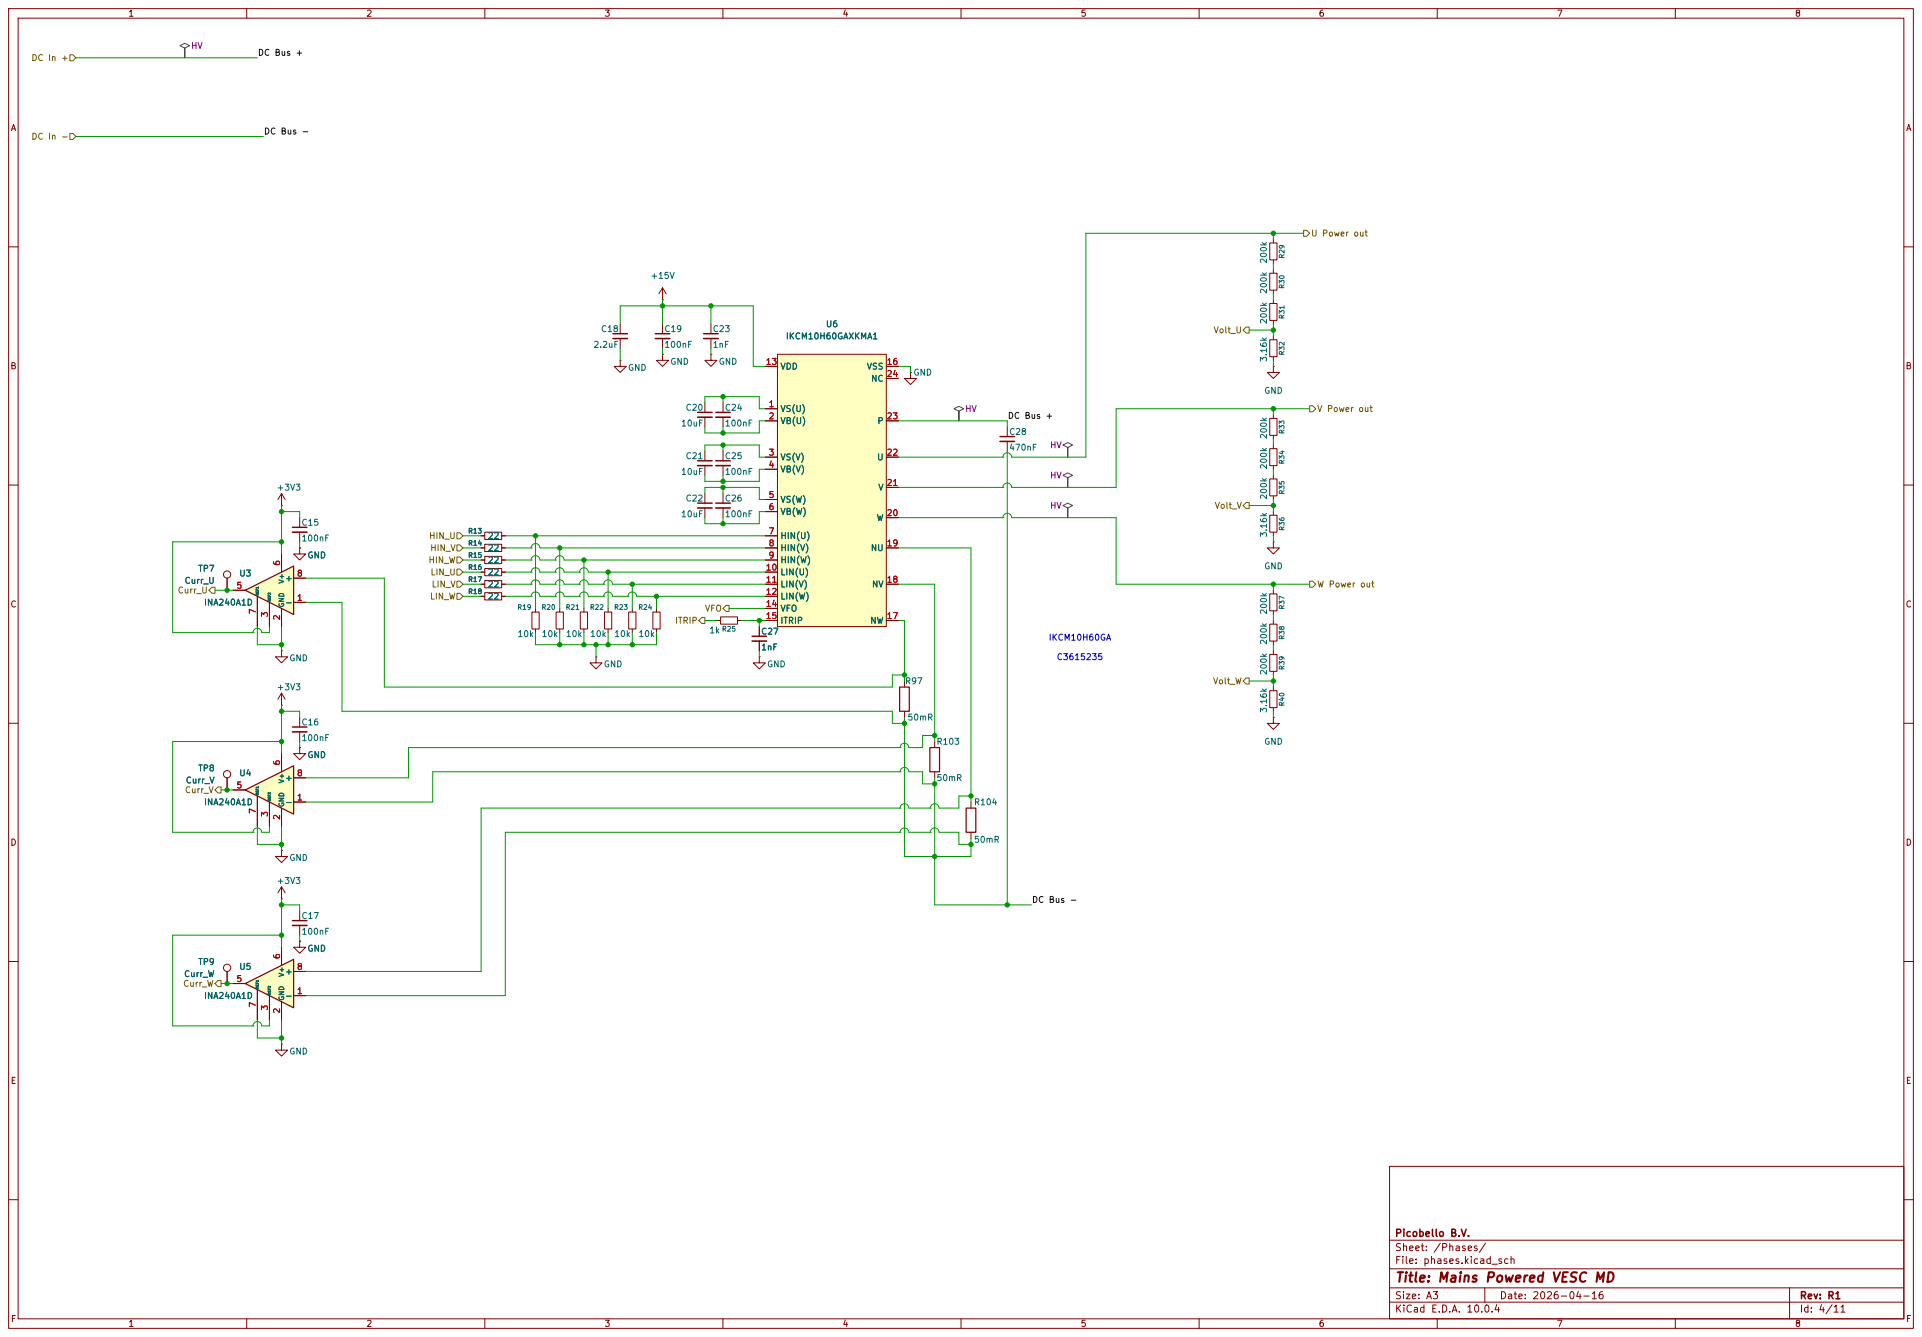
[picture p43: page 4]

DC Bus -
VSS 16 NW 17 NV 18 NU 19 W
10uF GND

LIN(U) 10

LIN(W) 12

Picobello B.V.
Sheet: /Phases/
File: phases.kicad_sch
Title: Mains Powered VESC MD

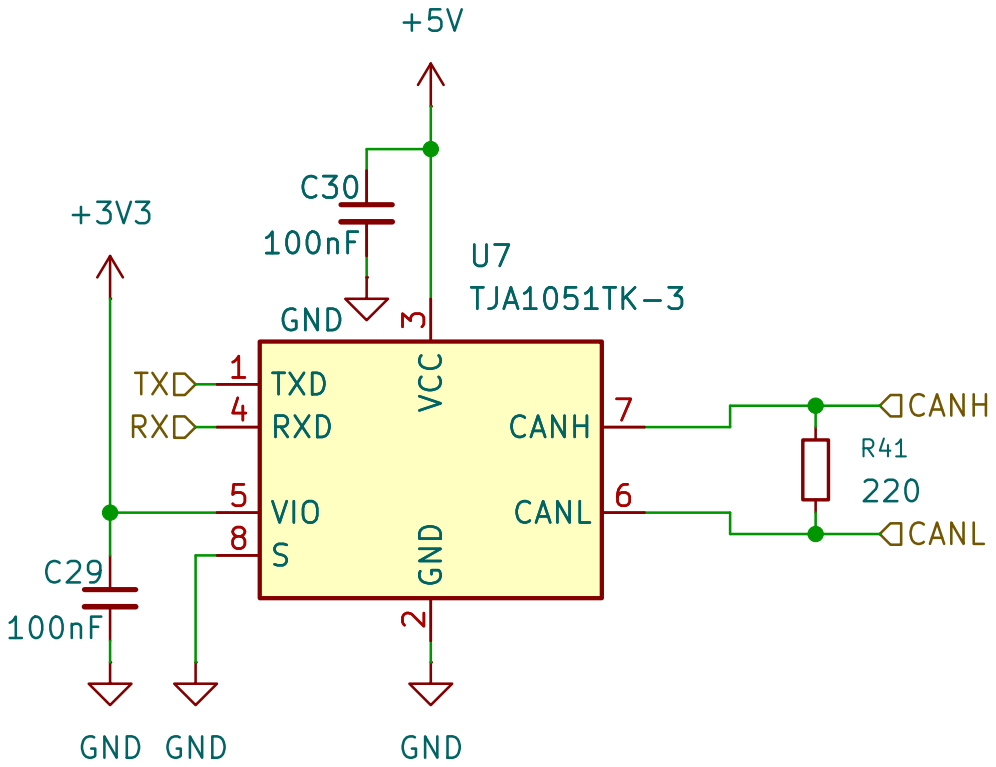
[picture p44: page 5]

Picobello B.V.
Sheet: /CAN/
File: can.kicad_sch
Title: Mains Powered VESC MD

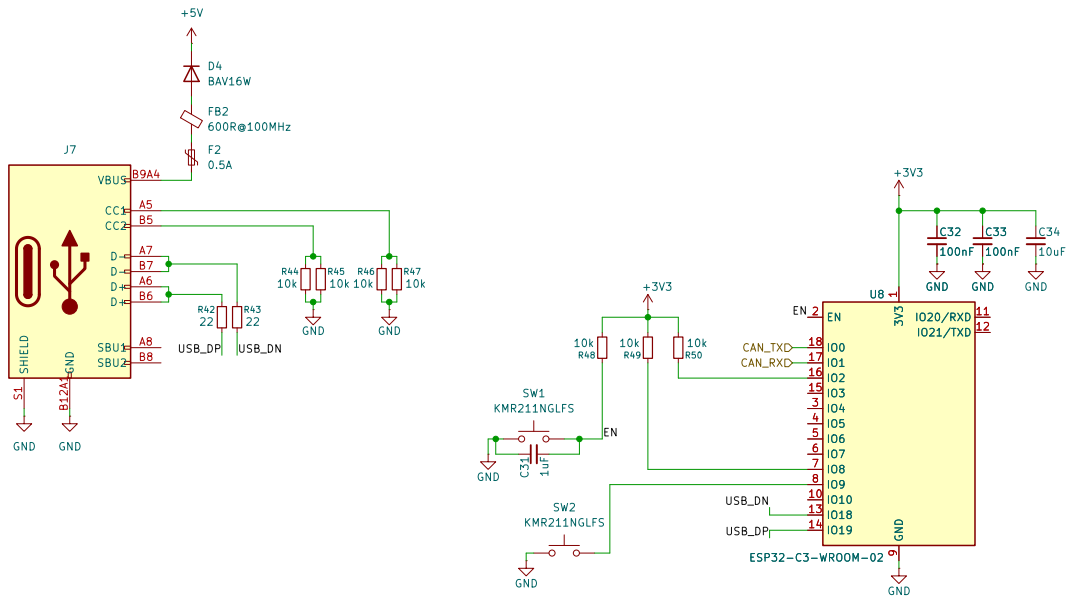
[picture p45: page 6]

Picobello B.V.
Sheet: /WiFi & BT/
File: express.kicad_sch
Title: Mains Powered VESC MD

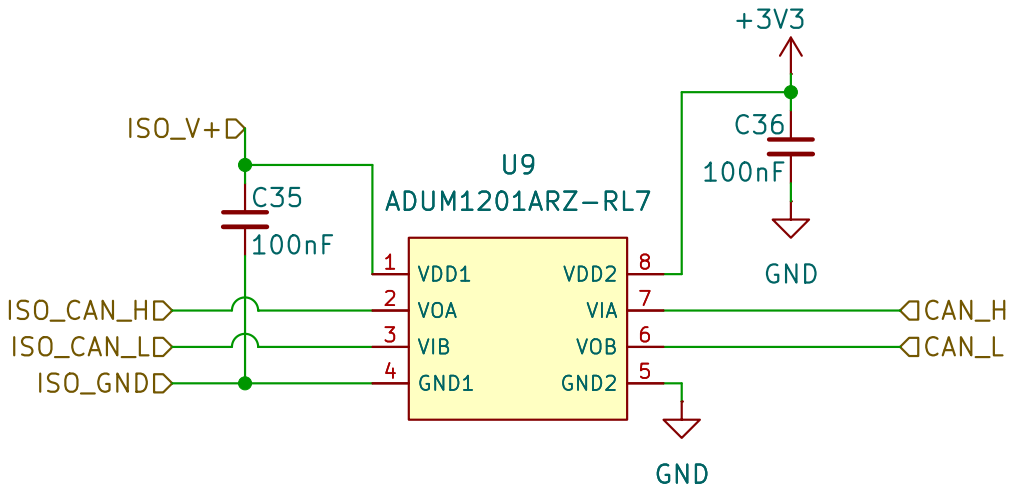
[picture p46: page 7]

Sheet: /Isolator/
File: isolator.kicad_sch
Title: Mains Powered VESC MD

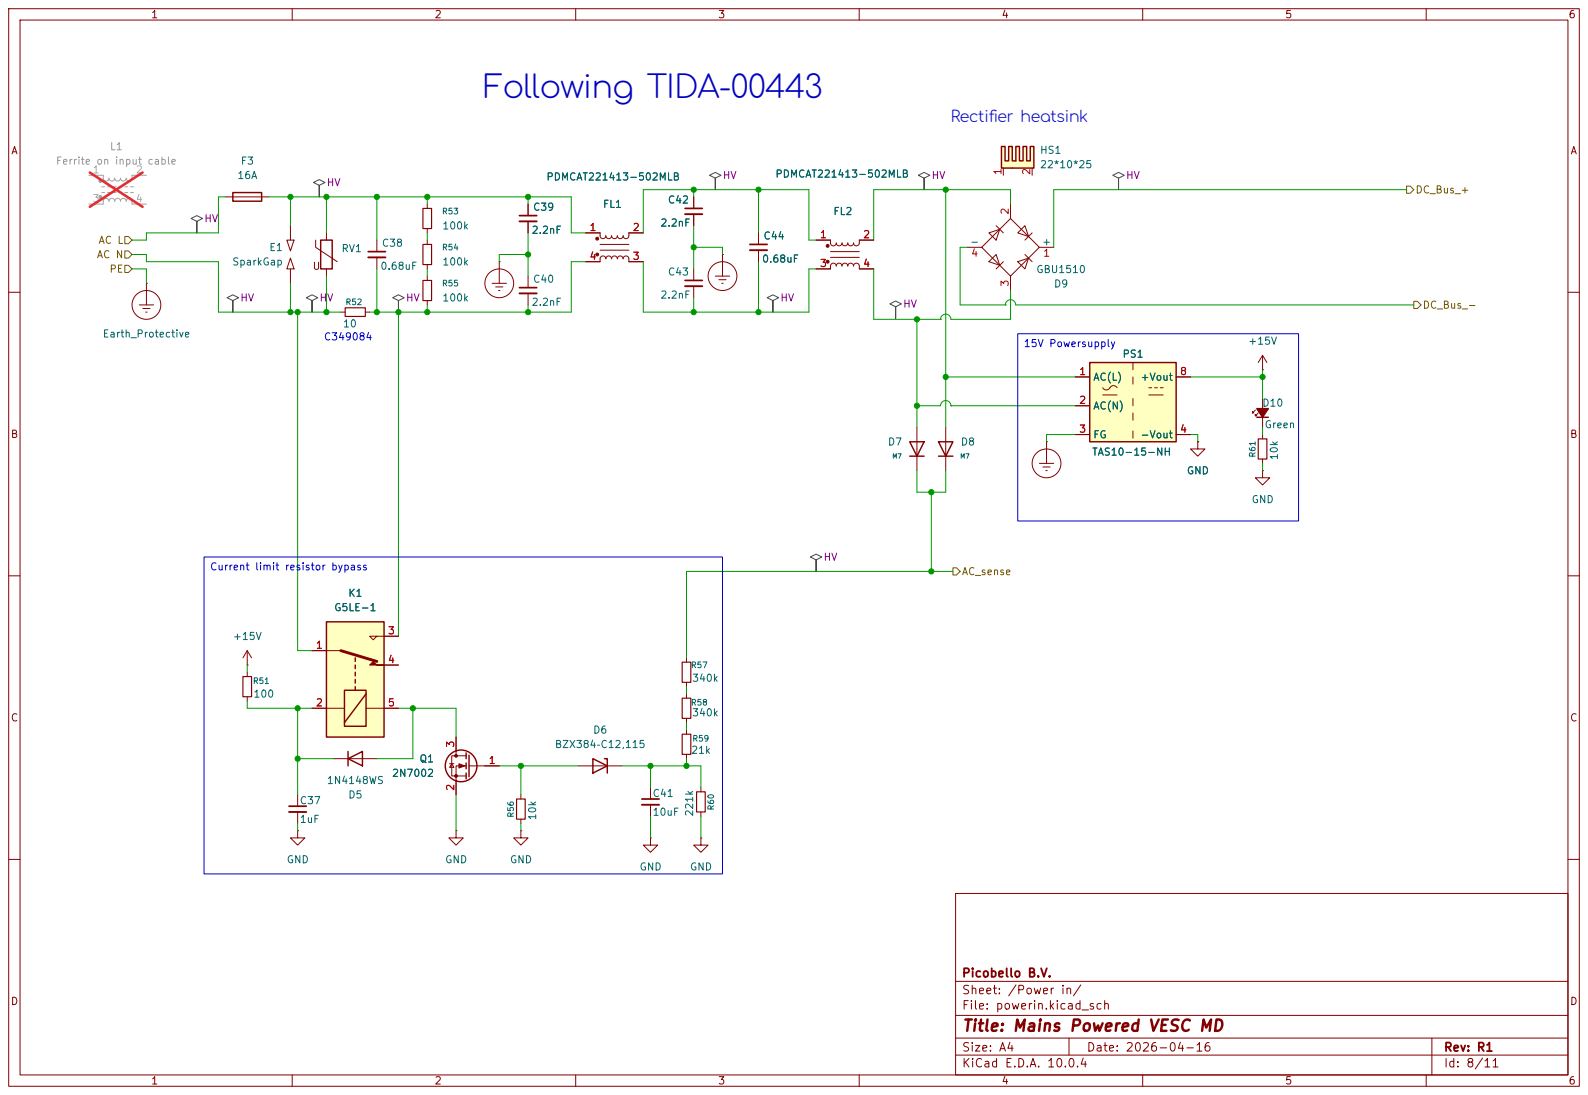
[picture p47: page 8]

Picobello B.V.
Sheet: /Power in/
File: powerin.kicad_sch
Title: Mains Powered VESC MD

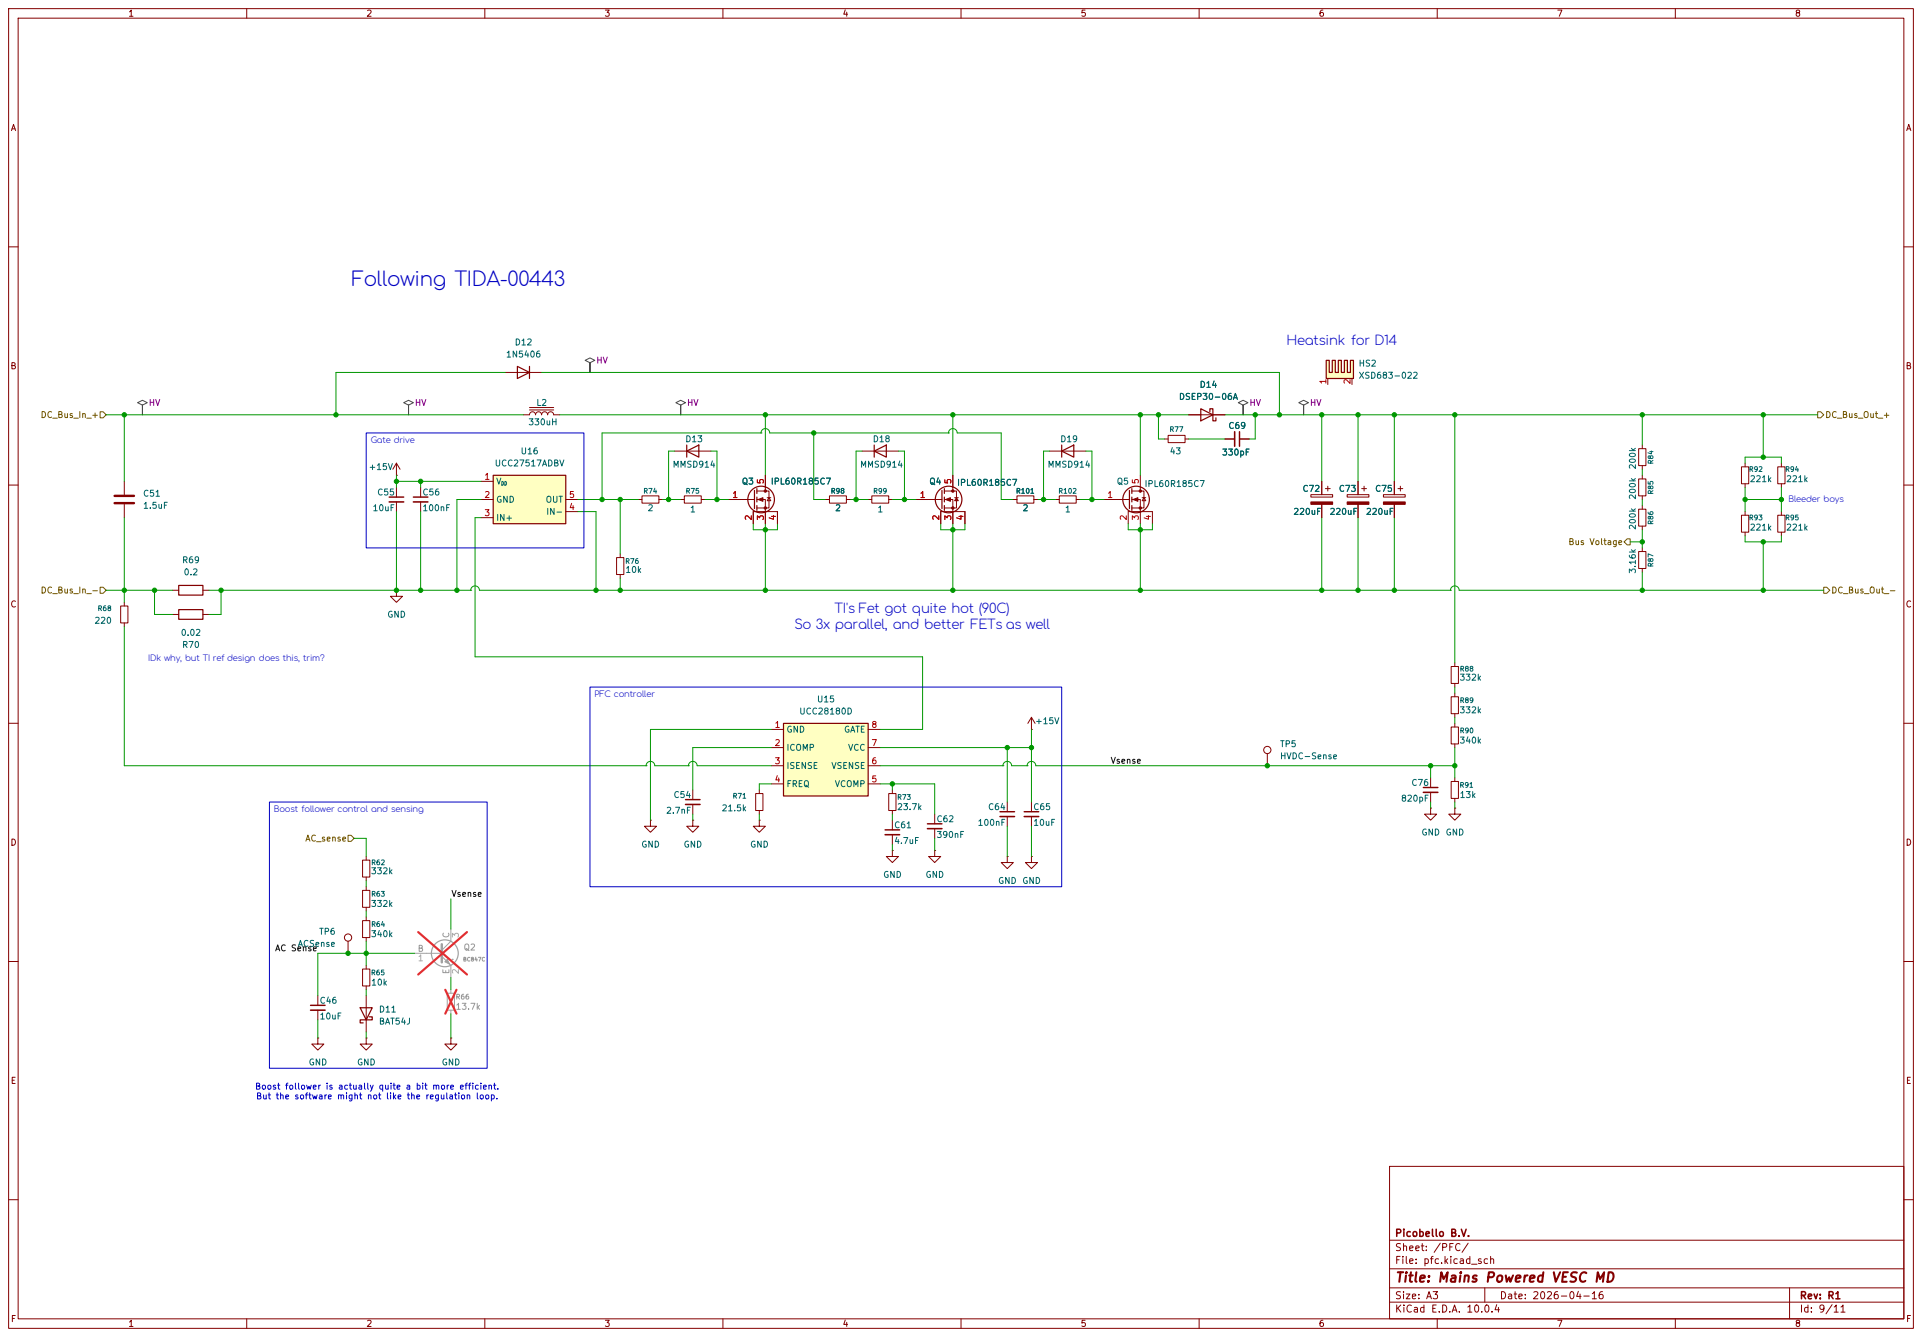
[picture p48: page 9]

Vsense Boost follower control and sensing Gate drive

4 Q5 5IPL60R185C7 R982 HV HV HV HV HV HV Bus Voltage DC_Bus_In_+

TI's Fet got quite hot (90C)

PFC controller Boost follower is actually quite a bit more efficient. But the software might not like the regulation loop.

Picobello B.V.
Sheet: /PFC/
File: pfc.kicad_sch
Title: Mains Powered VESC MD

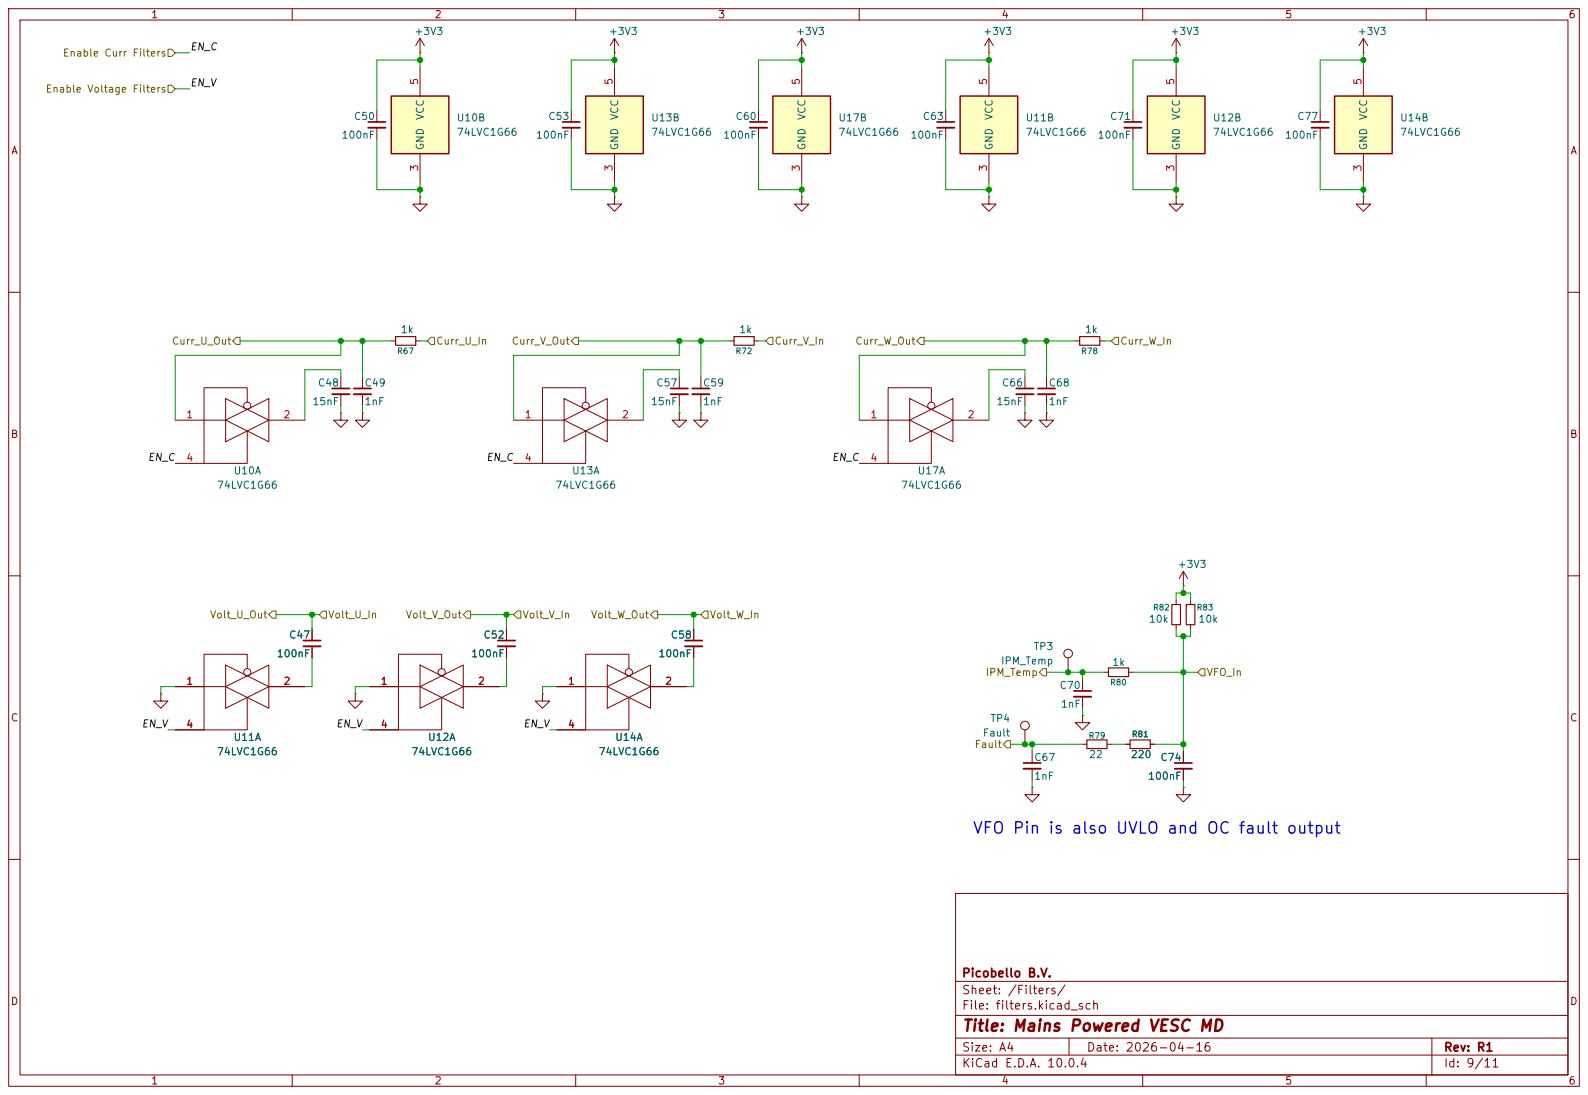
[picture p49: page 10]

Picobello B.V.
Sheet: /Filters/
File: filters.kicad_sch
Title: Mains Powered VESC MD

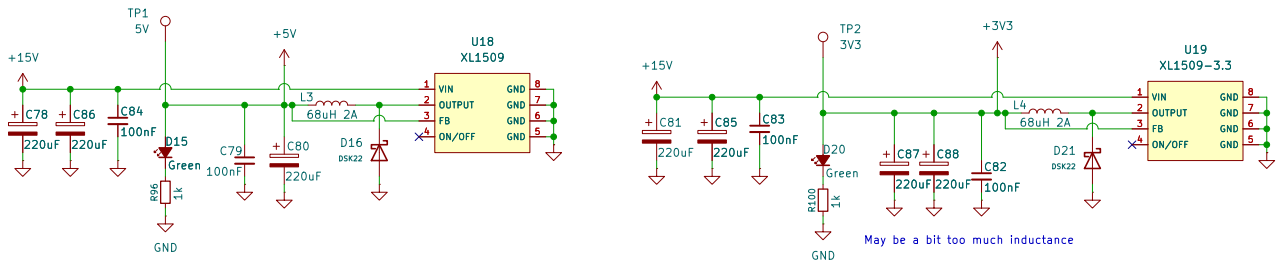
[picture p50: page 11]

Picobello B.V.
Sheet: /LV Power/
File: lvpower.kicad_sch
Title: Mains Powered VESC MD
