NovaPrime18/CompressorController/(list of files, drawings)

Other design files:
Hardware/audit/pcb_fps.json
