NovaPrime18/CompressorController/Hardware/CompressorController.kicad_pcb

## KiCad design Hardware/CompressorController.kicad_pcb (2026-11-12)

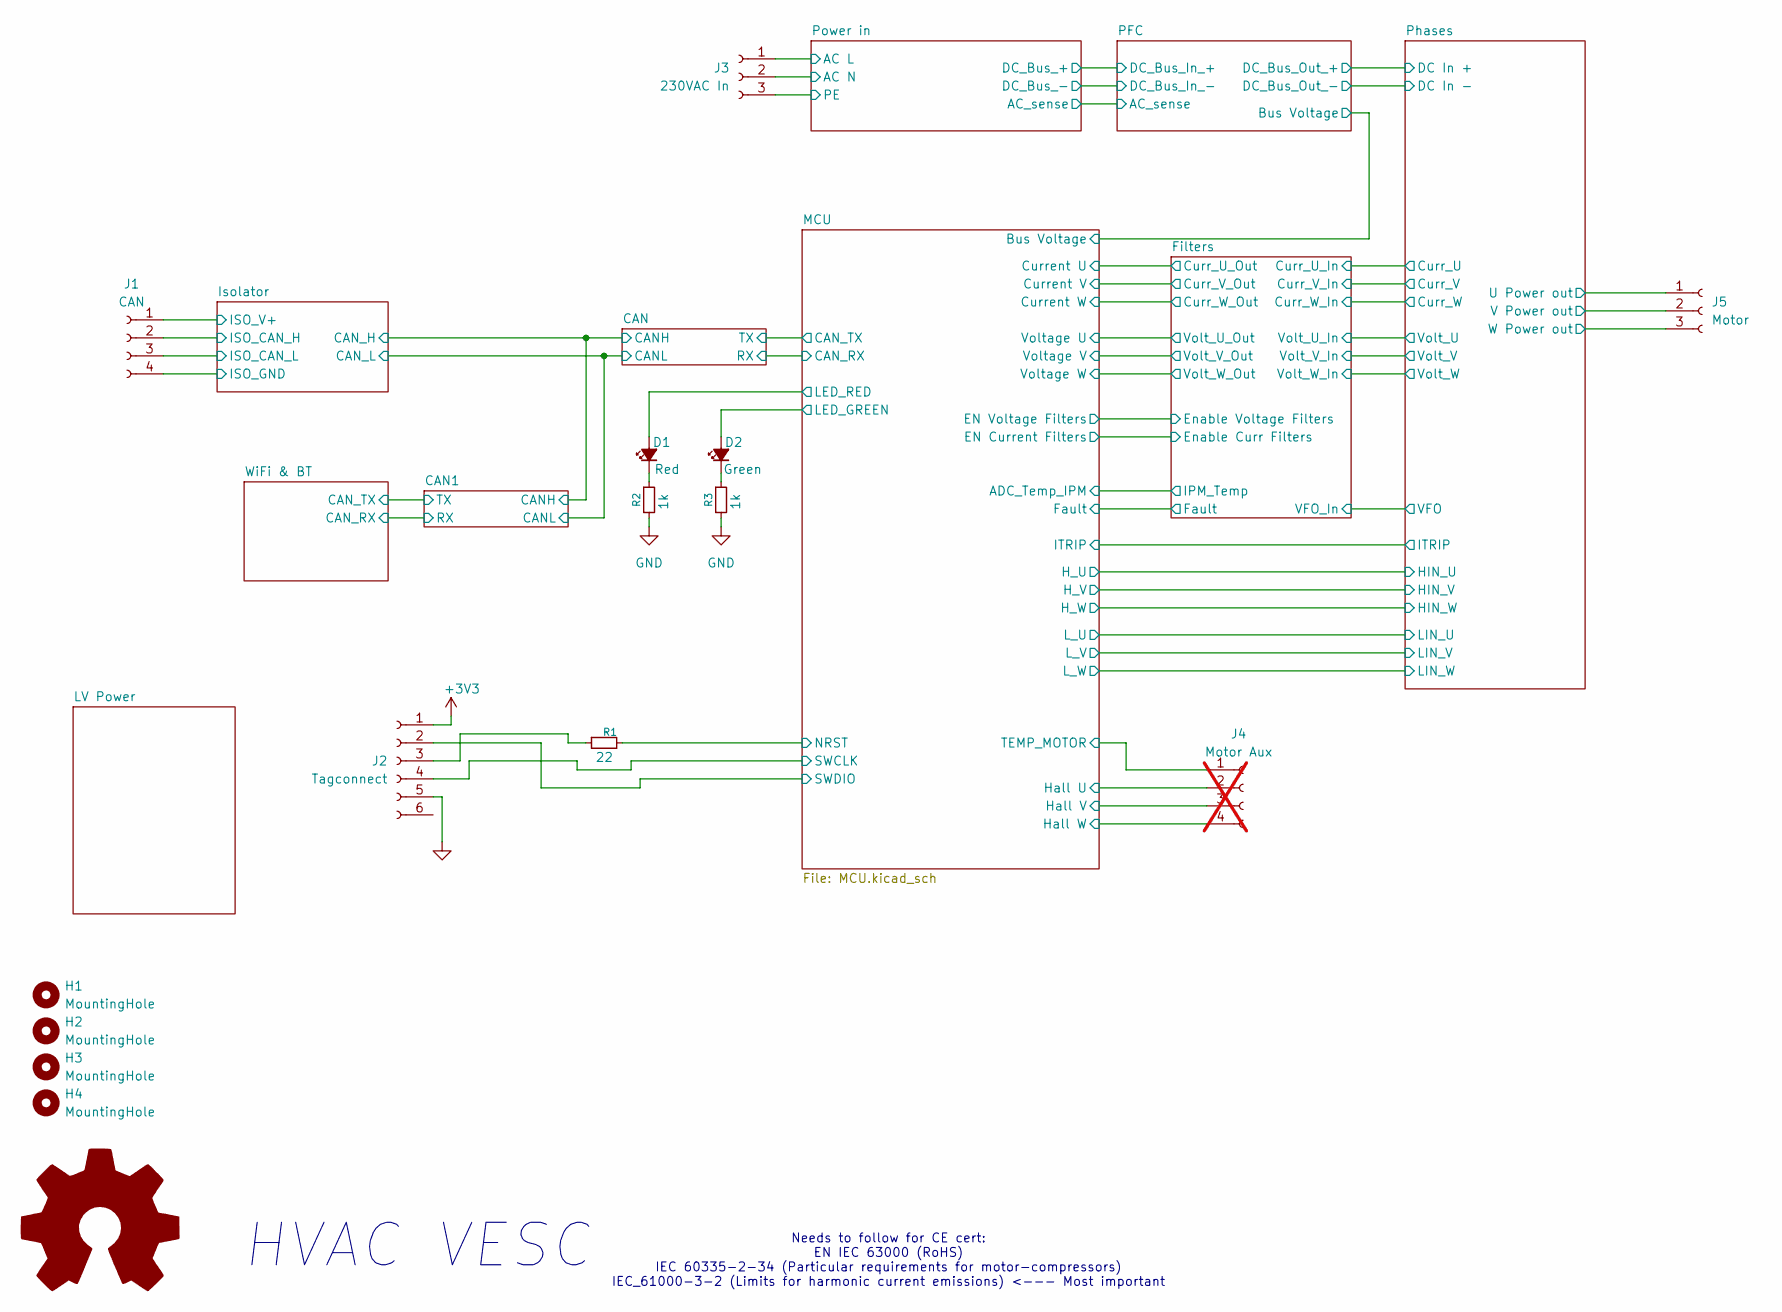
[picture p51: schematic CompressorController.kicad_sch, Mains Powered VESC MD]

Parts:
D1: Red; LED_0603_1608Metric; LCSC C2286
D2: Green; LED_0603_1608Metric; LCSC C84267
H1, H2, H3, H4: MountingHole; MountingHole_3.2mm_M3
J1: CAN; PhoenixContact_MC_1,5_4-G-3.5_1x04_P3.50mm_Horizontal; JLC C395831
J2: Tagconnect; Tag-Connect_TC2030-IDC-NL_2x03_P1.27mm_Vertical
J3: 230VAC In; PhoenixContact_GMSTB_2,5_3-GF-7,62_1x03_P7.62mm_Horizontal_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; JLC C5121957
J4: Motor Aux; PhoenixContact_MC_1,5_4-G-3.5_1x04_P3.50mm_Horizontal; JLC C395831; not fitted
J5: Motor; PhoenixContact_GMSTB_2,5_3-GF-7,62_1x03_P7.62mm_Horizontal_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; JLC C5121957
R1: 22; R_0603_1608Metric; LCSC C23345
R2, R3: 1k; R_0603_1608Metric; LCSC C21190

Connections:
+3V3: J2.1; also elsewhere on the board
/Isolator/ISO_CAN_H: J1.2; also elsewhere on the board
/Isolator/ISO_CAN_L: J1.3; also elsewhere on the board
/Isolator/ISO_GND: J1.4; also elsewhere on the board
/Isolator/ISO_V+: J1.1; also elsewhere on the board
/MCU/LED_GREEN: D2.2 (A); also elsewhere on the board
/MCU/LED_RED: D1.2 (A); also elsewhere on the board
/MCU/NRST: R1.2; also elsewhere on the board
/MCU/SWCLK: J2.4; also elsewhere on the board
/MCU/SWDIO: J2.2; also elsewhere on the board
/Phases/U Power out: J5.1; also elsewhere on the board
/Phases/V Power out: J5.2; also elsewhere on the board
/Phases/W Power out: J5.3; also elsewhere on the board
/Power in/AC L: J3.1; also elsewhere on the board
/Power in/AC N: J3.2; also elsewhere on the board
Earth_Protective: J3.3; also elsewhere on the board
GND: J2.5, R2.2, R3.2; also elsewhere on the board
unnamed: D1.1 (K), R2.1
unnamed: D2.1 (K), R3.1
unnamed: J2.3, R1.1

Notes on the sheet:
HVAC VESC
Needs to follow for CE cert: EN IEC 63000 (RoHS) IEC 60335-2-34 (Particular requirements for motor-compressors) IEC_61000-3-2 (Limits for harmonic current emissions) <--- Most important

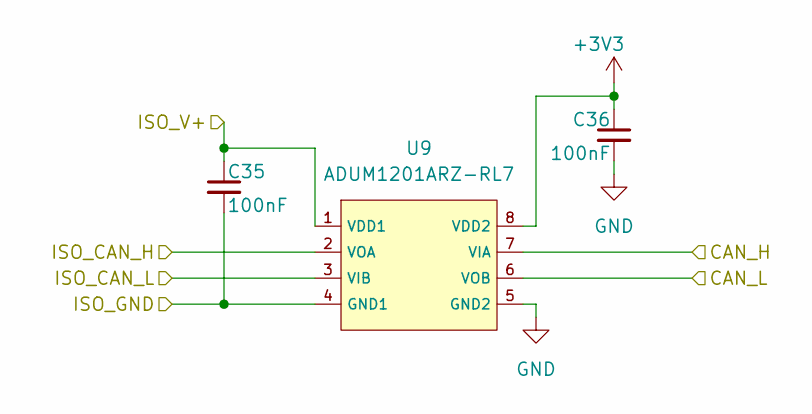
[picture p52: schematic isolator.kicad_sch, Mains Powered VESC MD]

Parts:
C35, C36: 100nF; C_0603_1608Metric; LCSC C14663
U9: ADUM1201ARZ-RL7; SOIC-8_L4.9-W3.9-P1.27-LS6.0-BL; Part ADUM1201ARZ-RL7; LCSC C9669

Connections:
+3V3: C36.1, U9.8 (VDD2); also elsewhere on the board
/CAN/CANH: U9.7 (VIA); also elsewhere on the board
/CAN/CANL: U9.6 (VOB); also elsewhere on the board
/Isolator/ISO_CAN_H: U9.2 (VOA); also elsewhere on the board
/Isolator/ISO_CAN_L: U9.3 (VIB); also elsewhere on the board
/Isolator/ISO_GND: C35.2, U9.4 (GND1); also elsewhere on the board
/Isolator/ISO_V+: C35.1, U9.1 (VDD1); also elsewhere on the board
GND: C36.2, U9.5 (GND2); also elsewhere on the board

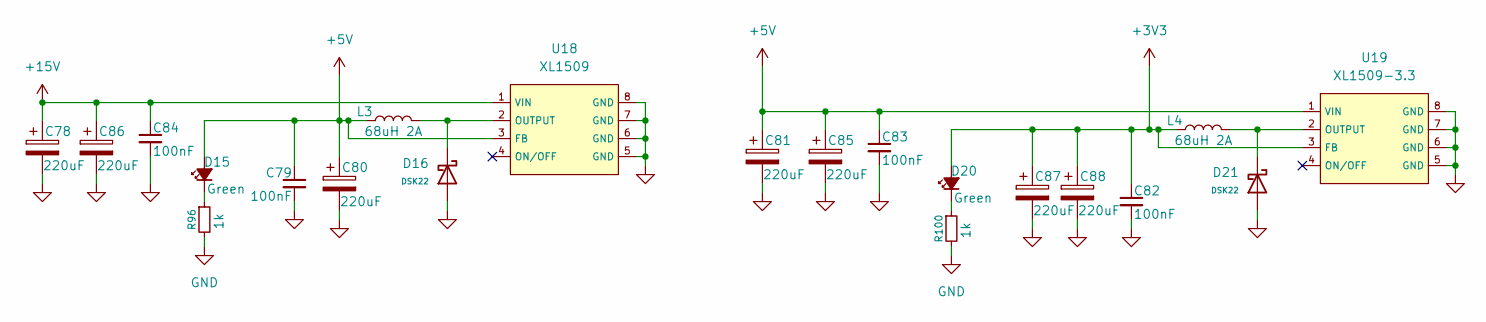
[picture p53: schematic lvpower.kicad_sch, Mains Powered VESC MD]

Parts:
C78, C80, C81, C85, C86, C87, C88: 220uF; CP_Elec_8x10.5; Voltage 50V; JLC C3340
C79, C82, C83, C84: 100nF; C_0603_1608Metric; LCSC C14663
D15, D20: Green; LED_0603_1608Metric; LCSC C84267
D16, D21: DSK22; D_SOD-123FL; Forward Voltage (Vf@If) 550mV@2A; Reverse Voltage (Vr) 20V; Part DSK22; LCSC C28646290
L3, L4: 68uH 2A; L_KOHERelec_MDA7030; JLC C2894721
R96, R100: 1k; R_0603_1608Metric; LCSC C21190
U18: XL1509; SOIC-8_L5.0-W4.0-P1.27-LS6.0-BL; Output Voltage 5V; Input Voltage 4.5V~40V; Part XL1509-5.0E1; LCSC C61063
U19: XL1509-3.3; SOIC-8_L5.0-W4.0-P1.27-LS6.0-BL; Output Voltage 3.3V; Input Voltage 4.5V~40V; Part XL1509-5.0E1; LCSC C2681226

Connections:
+3V3: C82.1, C87.1, C88.1, D20.2 (A), L4.1, U19.3 (FB); also elsewhere on the board
+5V: C79.1, C80.1, C81.1, C83.1, C85.1, D15.2 (A), L3.1, U18.3 (FB), U19.1 (VIN); also elsewhere on the board
+15V: C78.1, C84.1, C86.1, U18.1 (VIN); also elsewhere on the board
GND: C78.2, C79.2, C80.2, C81.2, C82.2, C83.2, C84.2, C85.2, C86.2, C87.2, C88.2, D16.2, D21.2, R96.2, R100.2, U18.5 (GND), U18.6 (GND), U18.7 (GND), U18.8 (GND), U19.5 (GND), U19.6 (GND), U19.7 (GND), U19.8 (GND); also elsewhere on the board
unnamed: D15.1 (K), R96.1
unnamed: D20.1 (K), R100.1
unnamed: D16.1, L3.2, U18.2 (OUTPUT)
unnamed: D21.1, L4.2, U19.2 (OUTPUT)

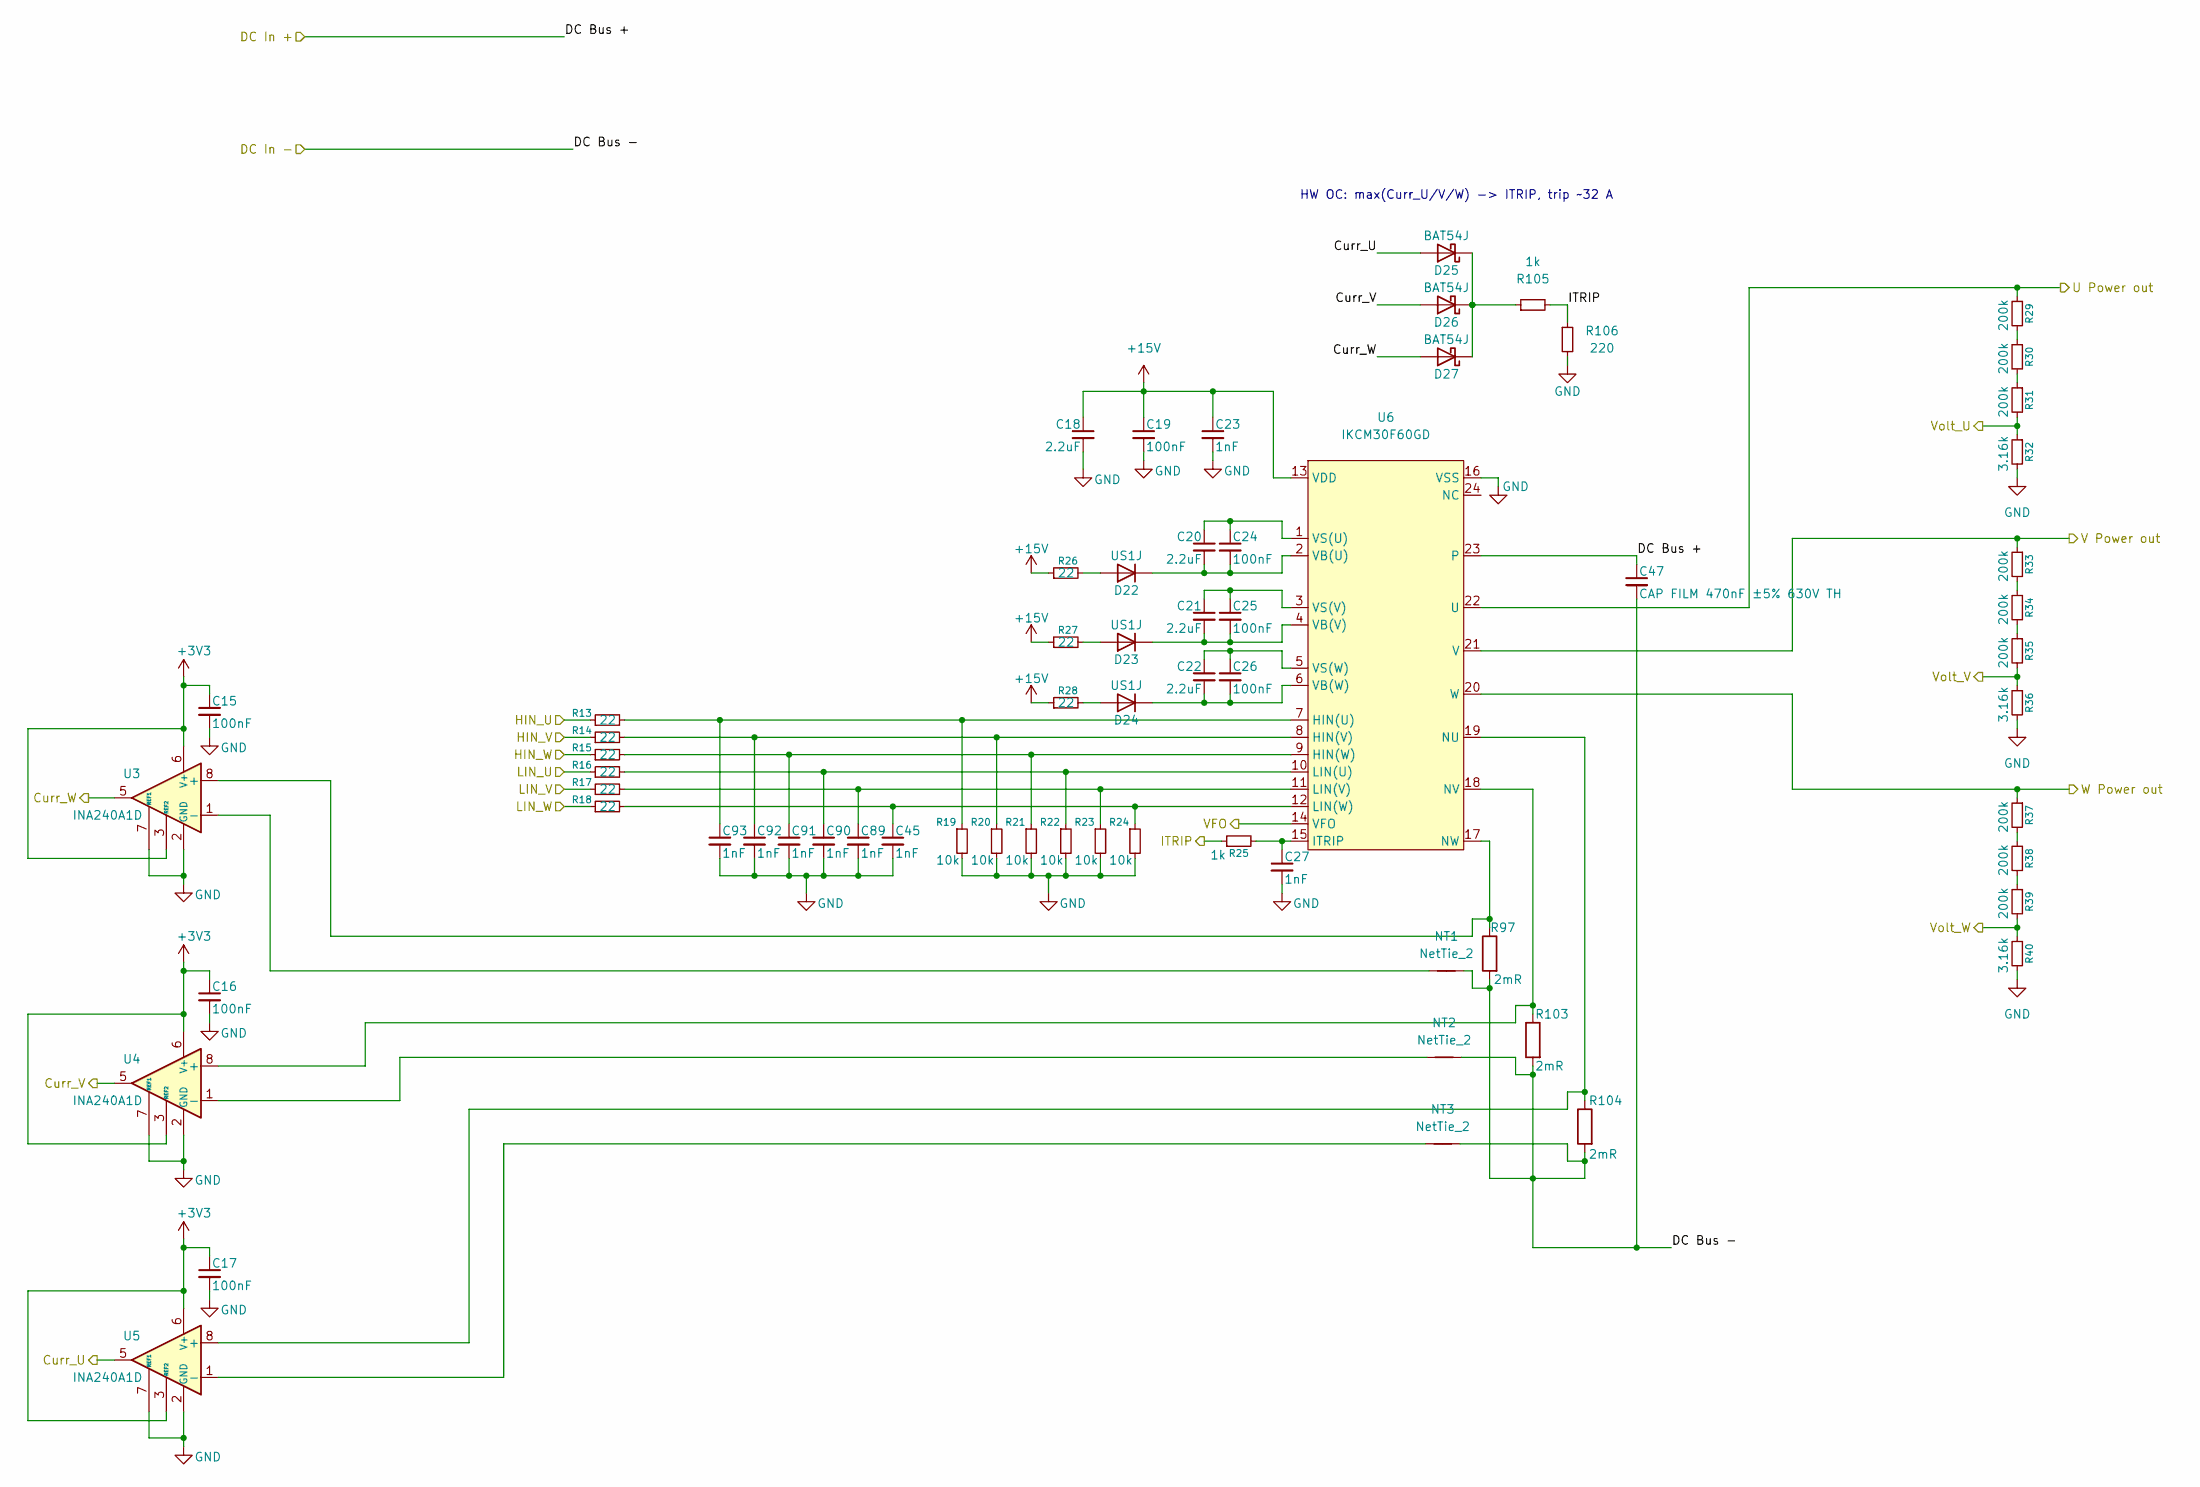
[picture p54: schematic phases.kicad_sch, Mains Powered VESC MD]

Parts:
C15, C16, C17, C19, C24, C25, C26: 100nF; C_0603_1608Metric; LCSC C14663
C18, C20, C21, C22: 2.2uF; C_1206_3216Metric; LCSC C50254
C23, C27, C45, C89, C90, C91, C92, C93: 1nF; C_0603_1608Metric; LCSC C1588
C47: CAP FILM 470nF ±5% 630V TH; C_Rect_L26.5mm_W11.5mm_P22.50mm_MKS4; Voltage 630V; LCSC C3796047
D22, D23, D24: US1J; D_SMA; LCSC C44763
D25, D26, D27: BAT54J; D_SOD-323F; LCSC C12744
NT1, NT2, NT3: NetTie_2; NetTie-2_SMD_Pad0.5mm
R13, R14, R15, R16, R17, R18, R26, R27, R28: 22; R_0603_1608Metric; LCSC C23345
R19, R20, R21, R22, R23, R24: 10k; R_0603_1608Metric; LCSC C25804
R25, R105: 1k; R_0603_1608Metric; LCSC C21190
R29, R30, R31, R33, R34, R35, R37, R38, R39: 200k; R_1206_3216Metric; LCSC C17954
R32, R36, R40: 3.16k; R_0805_2012Metric; LCSC C52603
R97, R103, R104: 2mR; R_1206_3216Metric; JLC C2904210
R106: 220; R_0603_1608Metric; LCSC C22962
U3, U4, U5: INA240A1D; SOIC-8_3.9x4.9mm_P1.27mm; LCSC C1346458
U6: IKCM30F60GD; DIP-24_L36.0-W21.0-P1.60-LS28.6-TL; LCSC Part C476130

Connections:
+3V3: C15.1, C16.1, C17.1, U3.3 (REF2), U3.6 (V+), U4.3 (REF2), U4.6 (V+), U5.3 (REF2), U5.6 (V+); also elsewhere on the board
+15V: C18.1, C19.1, C23.1, R26.1, R27.1, R28.1, U6.13 (VDD); also elsewhere on the board
/Filters/VFO_In: U6.14 (VFO); also elsewhere on the board
/Filters/Volt_U_In: R31.2, R32.1; also elsewhere on the board
/Filters/Volt_V_In: R35.2, R36.1; also elsewhere on the board
/Filters/Volt_W_In: R39.2, R40.1; also elsewhere on the board
/MCU/H_U: R13.1; also elsewhere on the board
/MCU/H_V: R14.1; also elsewhere on the board
/MCU/H_W: R15.1; also elsewhere on the board
/MCU/L_U: R16.1; also elsewhere on the board
/MCU/L_V: R17.1; also elsewhere on the board
/MCU/L_W: R18.1; also elsewhere on the board
/Phases/Curr_U: D25.2 (A), U5.5; also elsewhere on the board
/Phases/Curr_V: D26.2 (A), U4.5; also elsewhere on the board
/Phases/Curr_W: D27.2 (A), U3.5; also elsewhere on the board
/Phases/DC Bus +: C47.1, U6.23; also elsewhere on the board
/Phases/ITRIP: R25.1, R105.2, R106.1; also elsewhere on the board
/Phases/U Power out: R29.1, U6.22 (U); also elsewhere on the board
/Phases/V Power out: R33.1, U6.21 (V); also elsewhere on the board
/Phases/W Power out: R37.1, U6.20 (W); also elsewhere on the board
GND: C15.2, C16.2, C17.2, C18.2, C19.2, C23.2, C27.2, C45.2, C47.2, C89.2, C90.2, C91.2, C92.2, C93.2, NT1.2, NT2.2, NT3.2, R19.2, R20.2, R21.2, R22.2, R23.2, R24.2, R32.2, R36.2, R40.2, R97.2, R103.2, R104.2, R106.2, U3.2 (GND), U3.4 (GND), U3.7 (REF1), U4.2 (GND), U4.4 (GND), U4.7 (REF1), U5.2 (GND), U5.4 (GND), U5.7 (REF1), U6.16 (VSS); also elsewhere on the board
unnamed: D22.2 (A), R26.2
unnamed: C20.2, C24.2, D22.1 (K), U6.2 (VB(U))
unnamed: D23.2 (A), R27.2
unnamed: C21.2, C25.2, D23.1 (K), U6.4 (VB(V))
unnamed: D24.2 (A), R28.2
unnamed: C22.2, C26.2, D24.1 (K), U6.6 (VB(W))
unnamed: D25.1 (K), D26.1 (K), D27.1 (K), R105.1
unnamed: R29.2, R30.1
unnamed: R30.2, R31.1
unnamed: R33.2, R34.1
unnamed: R34.2, R35.1
unnamed: R37.2, R38.1
unnamed: R38.2, R39.1
unnamed: R97.1, U3.8 (+), U6.17 (NW)
unnamed: NT1.1, U3.1 (-)
unnamed: R103.1, U4.8 (+), U6.18 (NV)
unnamed: NT2.1, U4.1 (-)
unnamed: R104.1, U5.8 (+), U6.19 (NU)
unnamed: NT3.1, U5.1 (-)
unnamed: C93.1, R13.2, R19.1, U6.7 (HIN(U))
unnamed: C92.1, R14.2, R20.1, U6.8 (HIN(V))
unnamed: C91.1, R15.2, R21.1, U6.9 (HIN(W))
unnamed: C27.1, R25.2, U6.15 (ITRIP)
unnamed: C90.1, R16.2, R22.1, U6.10 (LIN(U))
unnamed: C89.1, R17.2, R23.1, U6.11 (LIN(V))
unnamed: C45.1, R18.2, R24.1, U6.12 (LIN(W))
unnamed: C20.1, C24.1, U6.1 (VS(U))
unnamed: C21.1, C25.1, U6.3 (VS(V))
unnamed: C22.1, C26.1, U6.5 (VS(W))

Notes on the sheet:
HW OC: max(Curr_U/V/W) -> ITRIP, trip ~32 A

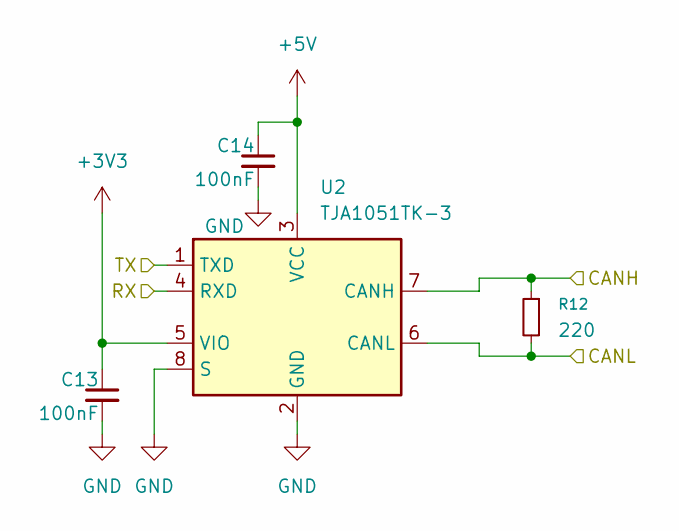
[picture p55: schematic can.kicad_sch, Mains Powered VESC MD]

Parts:
C13, C14: 100nF; C_0603_1608Metric; LCSC C14663
R12: 220; R_0603_1608Metric; LCSC C22962
U2: TJA1051TK-3; HVSON-8-1EP_3x3mm_P0.65mm_EP1.6x2.4mm; JLC C2875699

Connections:
+3V3: C13.1, U2.5 (VIO); also elsewhere on the board
+5V: C14.1, U2.3 (VCC); also elsewhere on the board
/CAN1/RX: U2.4 (RXD); also elsewhere on the board
/CAN1/TX: U2.1 (TXD); also elsewhere on the board
/CAN/CANH: R12.1, U2.7 (CANH); also elsewhere on the board
/CAN/CANL: R12.2, U2.6 (CANL); also elsewhere on the board
GND: C13.2, C14.2, U2.2 (GND), U2.8 (S), U2.9 (GND); also elsewhere on the board

Parts of its further copies:
C29, C30: 100nF; C_0603_1608Metric; LCSC C14663
R41: 220; R_0603_1608Metric; LCSC C22962
U7: TJA1051TK-3; HVSON-8-1EP_3x3mm_P0.65mm_EP1.6x2.4mm; JLC C2875699

Connections of its further copies:
+3V3: C29.1, U7.5 (VIO); also elsewhere on the board
+5V: C30.1, U7.3 (VCC); also elsewhere on the board
/CAN/CANH: R41.1, U7.7 (CANH); also elsewhere on the board
/CAN/CANL: R41.2, U7.6 (CANL); also elsewhere on the board
/CAN/RX: U7.4 (RXD); also elsewhere on the board
/CAN/TX: U7.1 (TXD); also elsewhere on the board
GND: C29.2, C30.2, U7.2 (GND), U7.8 (S), U7.9 (GND); also elsewhere on the board

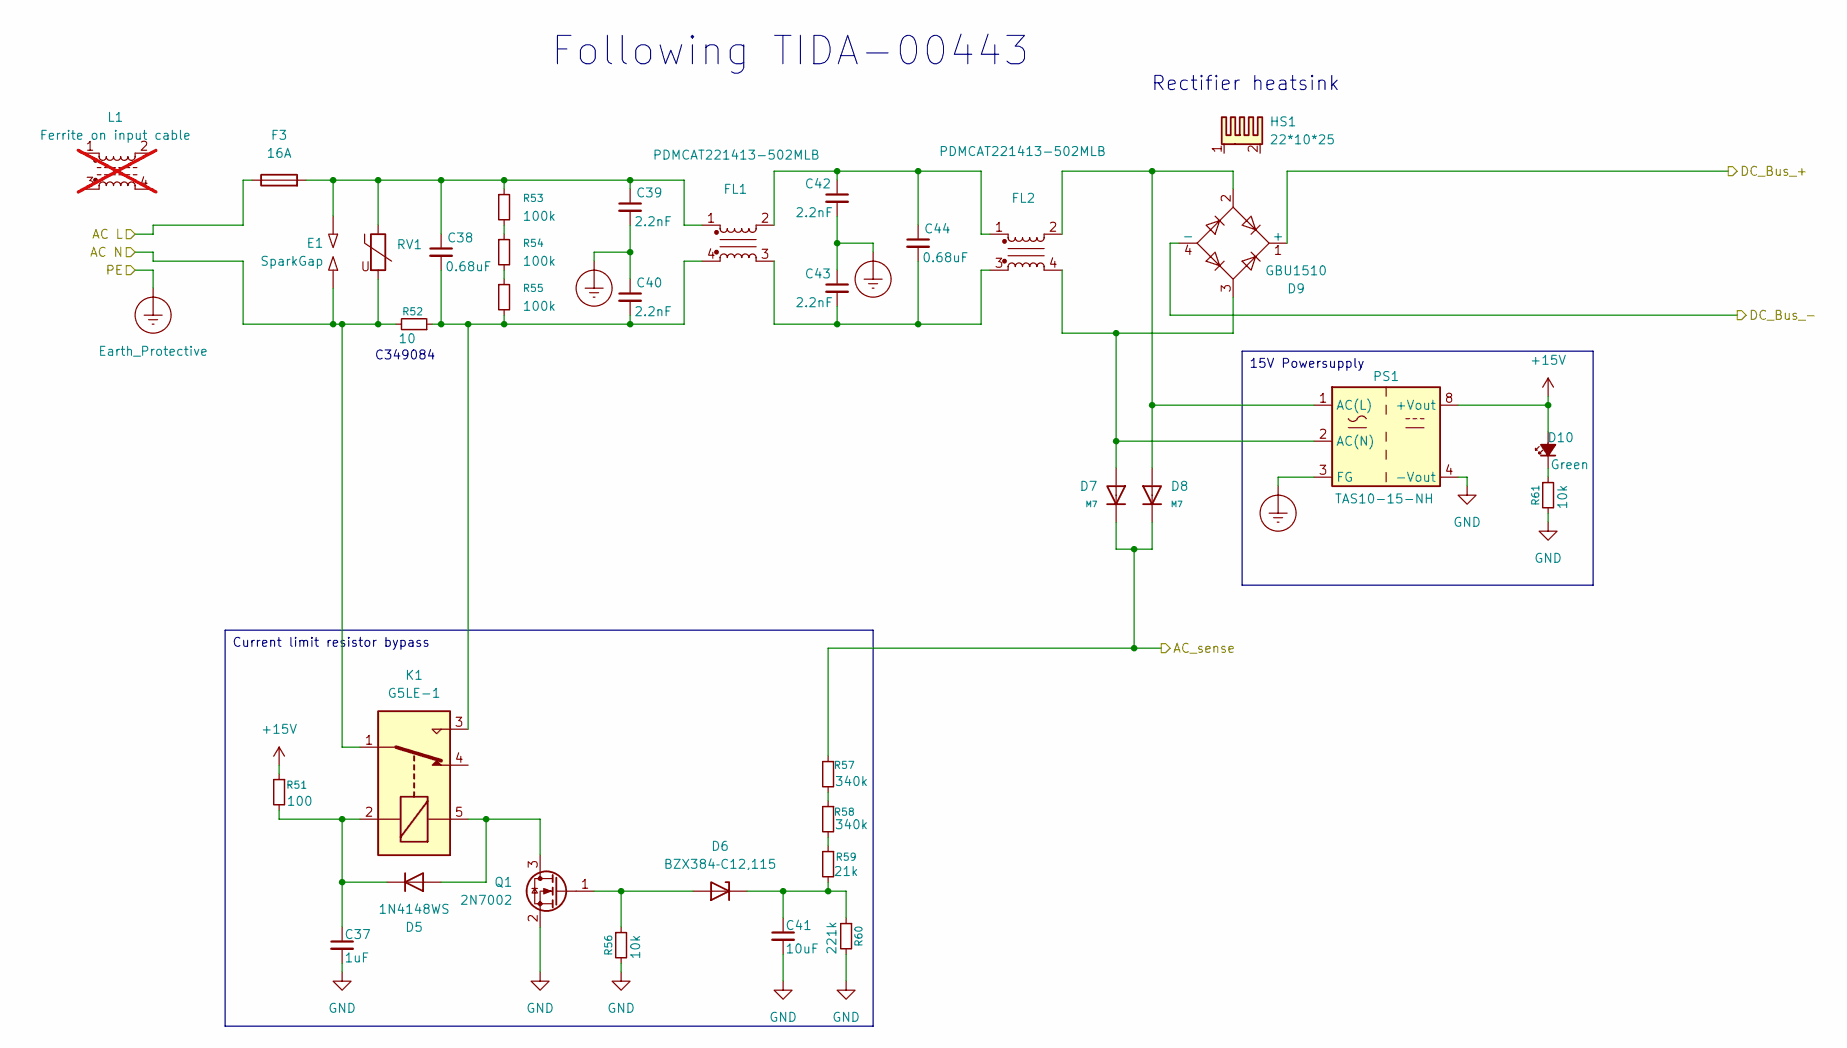
[picture p56: schematic powerin.kicad_sch, Mains Powered VESC MD]

Parts:
C37: 1uF; C_0805_2012Metric; LCSC C28323
C38, C44: 0.68uF; C_Rect_L18.0mm_W9.0mm_P15.00mm_FKS3_FKP3; JLC C489081
C39: 2.2nF; C_Disc_D10.5mm_W5.0mm_P7.50mm; JLC C340576
C40, C42, C43: 2.2nF; C_Disc_D10.5mm_W5.0mm_P7.50mm; JLC C2919125
C41: 10uF; C_0805_2012Metric; LCSC C440198
D5: 1N4148WS; D_SOD-323; LCSC C2128
D6: BZX384‐C12,115; D_SOD-323; LCSC C454968
D7, D8: M7; D_SMA; Forward Voltage (Vf@If) 1.1V@1A; Reverse Voltage (Vr) 1kV; Part M7; LCSC C95872
D9: GBU1510; GBU_4P-L22.0-W3.5-P5.08_GBU808; JLC C22447862
D10: Green; LED_0603_1608Metric; LCSC C84267
E1: SparkGap; sparkgap
F3: 16A; FUSE-TH_L29.0-W10.0_XF-103; JLC C41371865
FL1, FL2: PDMCAT221413-502MLB; IND-TH_4P-L28.0-W18.5_C2924777; JLC C2924779
HS1: 22*10*25; HEATSINK-TH_L22.0-W9.8-P14.00-D2.2; JLC C4656
K1: G5LE-1; Relay_SPDT_Omron-G5LE-1; LCSC C116964
L1: Ferrite on input cable; not fitted
PS1: TAS10-15-NH; PWRM-TH_TAS10-XX-NH; JLC C570974
Q1: 2N7002; SOT-23; LCSC C8545
R51: 100; R_1206_3216Metric; LCSC C17901
R52: 10; RES-TH_BD9.0-L36.5-P40.50-D0.8; LCSC C349084
R53, R54, R55: 100k; R_1206_3216Metric; LCSC C17900
R56, R61: 10k; R_0603_1608Metric; LCSC C25804
R57, R58: 340k; R_1206_3216Metric; LCSC C2999478
R59: 21k; R_1206_3216Metric; LCSC C2086273
R60: 221k; R_1206_3216Metric; LCSC C872617
RV1: B72214S2271K101; RV_Disc_D12mm_W5.4mm_P7.5mm; JLC C210689

Connections:
+15V: D10.2 (A), PS1.8 (+Vout), R51.1; also elsewhere on the board
/PFC/AC_sense: D7.1, D8.1, R57.1; also elsewhere on the board
/PFC/DC_Bus_In_+: D9.1 (+); also elsewhere on the board
/PFC/DC_Bus_In_-: D9.4 (-); also elsewhere on the board
/Power in/AC L: F3.1; also elsewhere on the board
/Power in/AC N: E1.2, K1.1, R52.2, RV1.2; also elsewhere on the board
Earth_Protective: C39.2, C40.1, C42.2, C43.1, PS1.3 (FG); also elsewhere on the board
GND: C37.2, C41.2, PS1.4 (-Vout), Q1.2 (S), R56.2, R60.2, R61.2; also elsewhere on the board
unnamed: C38.1, C39.1, E1.1, F3.2, FL1.1, R53.1, RV1.1
unnamed: C38.2, C40.2, FL1.4, K1.3, R52.1, R55.2
unnamed: C42.1, C44.1, FL1.2, FL2.1
unnamed: C43.2, C44.2, FL1.3, FL2.3
unnamed: D5.2 (A), K1.5, Q1.3 (D)
unnamed: C37.1, D5.1 (K), K1.2, R51.2
unnamed: D6.2 (A), Q1.1 (G), R56.1
unnamed: C41.1, D6.1 (K), R59.2, R60.1
unnamed: D10.1 (K), R61.1
unnamed: D8.2, D9.2, FL2.2, PS1.1 (AC(L))
unnamed: D7.2, D9.3, FL2.4, PS1.2 (AC(N))
unnamed: R53.2, R54.1
unnamed: R54.2, R55.1
unnamed: R57.2, R58.1
unnamed: R58.2, R59.1

Notes on the sheet:
Rectifier heatsink
C349084
Following TIDA-00443
15V Powersupply
Current limit resistor bypass

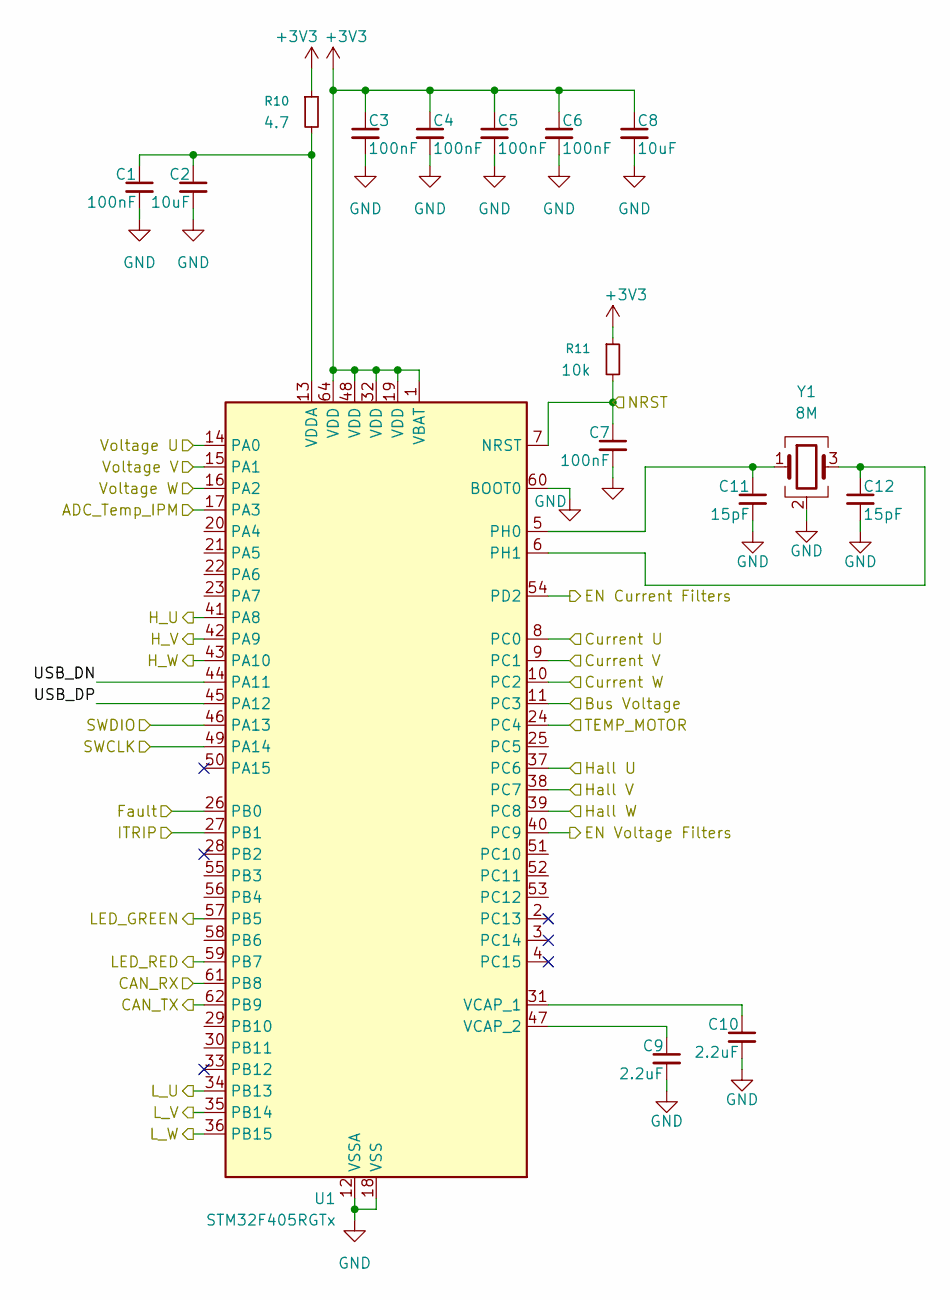
[picture p57: schematic MCU.kicad_sch, Mains Powered VESC MD]

Parts:
C1, C3, C4, C5, C6, C7: 100nF; C_0603_1608Metric; LCSC C14663
C2, C8: 10uF; C_0805_2012Metric; LCSC C440198
C9, C10: 2.2uF; C_1206_3216Metric; LCSC C50254
C11, C12: 15pF; C_0603_1608Metric; LCSC C1644
R10: 4.7; R_0603_1608Metric; LCSC C23164
R11: 10k; R_0603_1608Metric; LCSC C25804
U1: STM32F405RGTx; LQFP-64_10x10mm_P0.5mm; LCSC C15742
Y1: 8M; Crystal_SMD_3225-4Pin_3.2x2.5mm; JLC C2682775

Connections:
+3V3: C3.1, C4.1, C5.1, C6.1, C8.1, R10.1, R11.1, U1.1 (VBAT), U1.19 (VDD), U1.32 (VDD), U1.48 (VDD), U1.64 (VDD); also elsewhere on the board
/CAN/RX: U1.61 (PB8); also elsewhere on the board
/CAN/TX: U1.62 (PB9); also elsewhere on the board
/Filters/Curr_U_Out: U1.8 (PC0); also elsewhere on the board
/Filters/Curr_V_Out: U1.9 (PC1); also elsewhere on the board
/Filters/Curr_W_Out: U1.10 (PC2); also elsewhere on the board
/Filters/EN_C: U1.54 (PD2); also elsewhere on the board
/Filters/EN_V: U1.40 (PC9); also elsewhere on the board
/Filters/Fault: U1.26 (PB0); also elsewhere on the board
/Filters/IPM_Temp: U1.17 (PA3); also elsewhere on the board
/Filters/Volt_U_In: U1.14 (PA0); also elsewhere on the board
/Filters/Volt_V_In: U1.15 (PA1); also elsewhere on the board
/Filters/Volt_W_In: U1.16 (PA2); also elsewhere on the board
/MCU/Bus Voltage: U1.11 (PC3); also elsewhere on the board
/MCU/H_U: U1.41 (PA8); also elsewhere on the board
/MCU/H_V: U1.42 (PA9); also elsewhere on the board
/MCU/H_W: U1.43 (PA10); also elsewhere on the board
/MCU/Hall U: U1.37 (PC6)
/MCU/Hall V: U1.38 (PC7)
/MCU/Hall W: U1.39 (PC8)
/MCU/LED_GREEN: U1.57 (PB5); also elsewhere on the board
/MCU/LED_RED: U1.59 (PB7); also elsewhere on the board
/MCU/L_U: U1.34 (PB13); also elsewhere on the board
/MCU/L_V: U1.35 (PB14); also elsewhere on the board
/MCU/L_W: U1.36 (PB15); also elsewhere on the board
/MCU/NRST: C7.1, R11.2, U1.7 (NRST); also elsewhere on the board
/MCU/SWCLK: U1.49 (PA14); also elsewhere on the board
/MCU/SWDIO: U1.46 (PA13); also elsewhere on the board
/MCU/TEMP_MOTOR: U1.24 (PC4)
/MCU/USB_DN: U1.44 (PA11)
/MCU/USB_DP: U1.45 (PA12)
/Phases/ITRIP: U1.27 (PB1); also elsewhere on the board
GND: C1.2, C2.2, C3.2, C4.2, C5.2, C6.2, C7.2, C8.2, C9.2, C10.2, C11.2, C12.2, U1.12 (VSSA), U1.18 (VSS), U1.60 (BOOT0), U1.63 (VSS), Y1.2 (G), Y1.4 (G); also elsewhere on the board
unnamed: C11.1, U1.5 (PH0), Y1.1
unnamed: C12.1, U1.6 (PH1), Y1.3
unnamed: C10.1, U1.31 (VCAP_1)
unnamed: C9.1, U1.47 (VCAP_2)
unnamed: C1.1, C2.1, R10.2, U1.13 (VDDA)

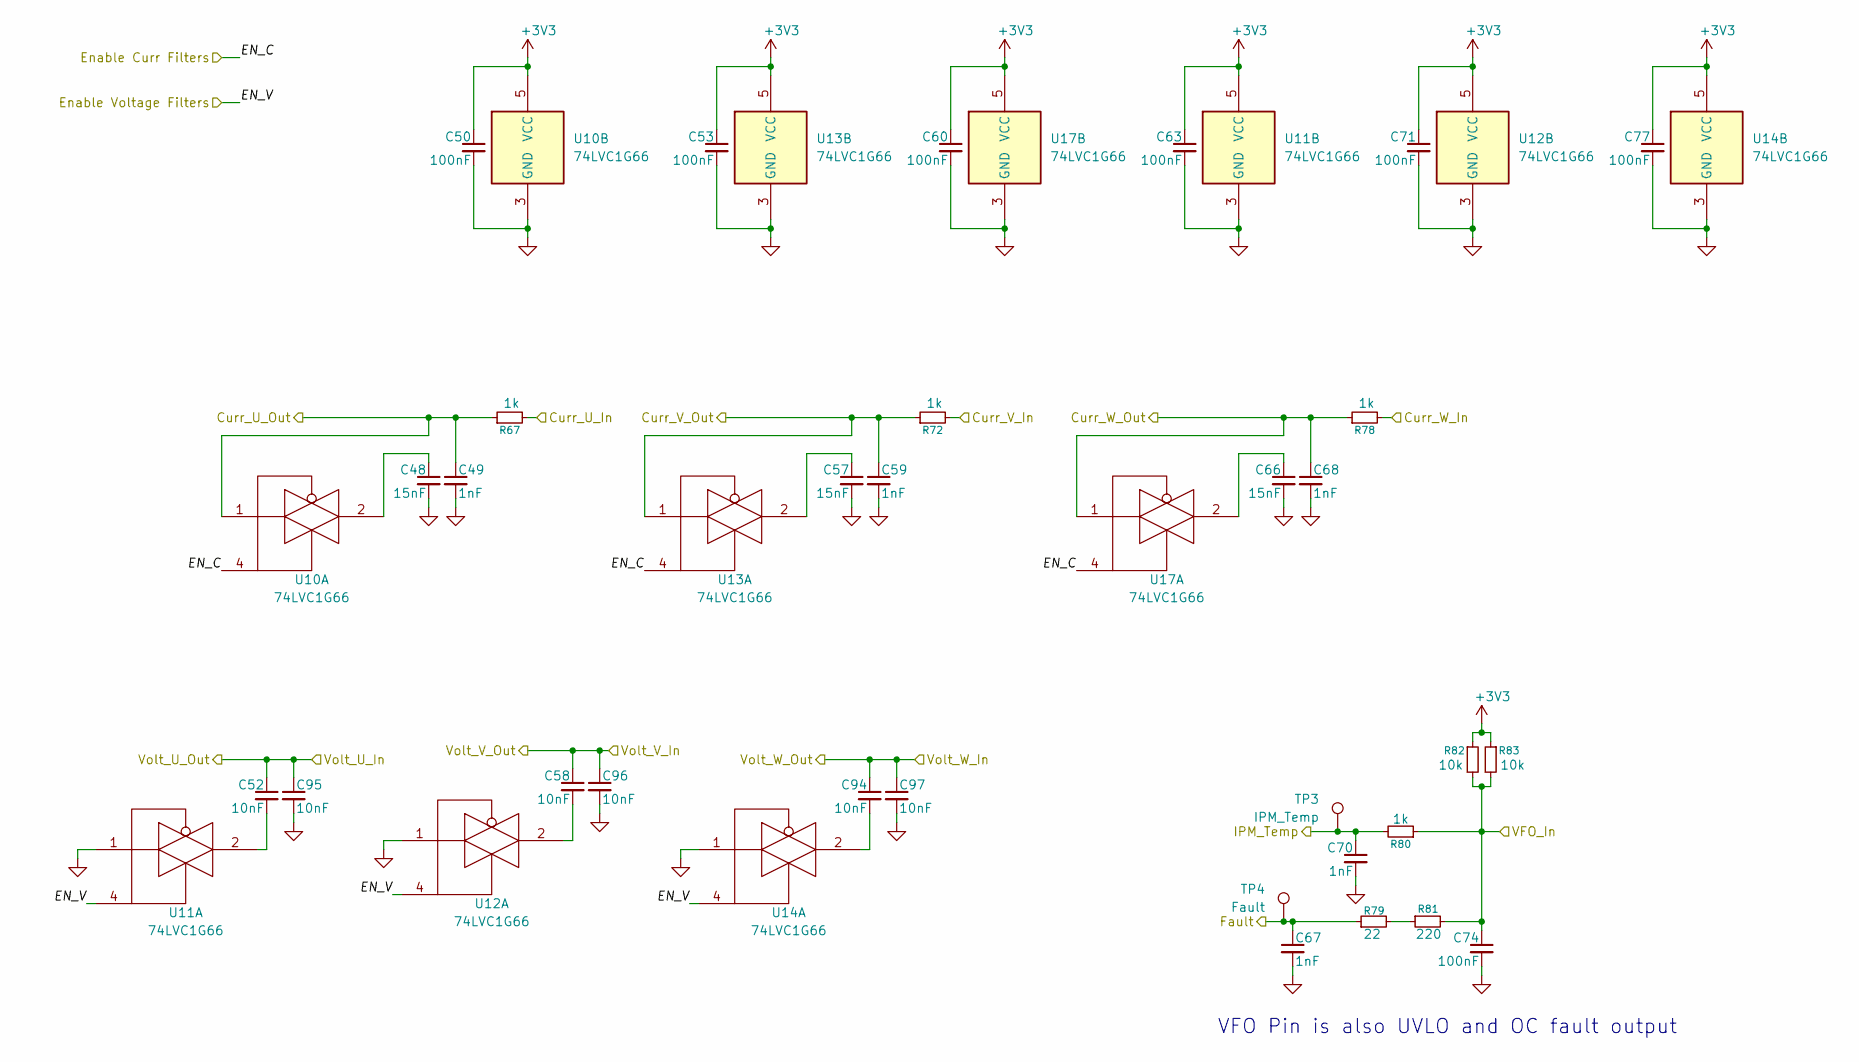
[picture p58: schematic filters.kicad_sch, Mains Powered VESC MD]

Parts:
C48, C57, C66: 15nF; C_0603_1608Metric; LCSC C1596
C49, C59, C67, C68, C70: 1nF; C_0603_1608Metric; LCSC C1588
C50, C53, C60, C63, C71, C74, C77: 100nF; C_0603_1608Metric; LCSC C14663
C52, C58, C94, C95, C96, C97: 10nF; C_0603_1608Metric; LCSC C1589
R67, R72, R78, R80: 1k; R_0603_1608Metric; LCSC C21190
R79: 22; R_0603_1608Metric; LCSC C23345
R81: 220; R_0603_1608Metric; LCSC C22962
R82, R83: 10k; R_0603_1608Metric; LCSC C25804
TP3: IPM_Temp; TestPoint_Pad_D1.5mm
TP4: Fault; TestPoint_Pad_D1.5mm
U10, U11, U12, U13, U14, U17: 74LVC1G66; SOT-353_SC-70-5; JLC C97489

Connections:
+3V3: C50.1, C53.1, C60.1, C63.1, C71.1, C77.1, R82.1, R83.1, U10.5 (VCC), U11.5 (VCC), U12.5 (VCC), U13.5 (VCC), U14.5 (VCC), U17.5 (VCC); also elsewhere on the board
/Filters/Curr_U_Out: C49.1, R67.1, U10.1; also elsewhere on the board
/Filters/Curr_V_Out: C59.1, R72.1, U13.1; also elsewhere on the board
/Filters/Curr_W_Out: C68.1, R78.1, U17.1; also elsewhere on the board
/Filters/EN_C: U10.4, U13.4, U17.4; also elsewhere on the board
/Filters/EN_V: U11.4, U12.4, U14.4; also elsewhere on the board
/Filters/Fault: C67.1, R79.1, TP4.1 (1_1); also elsewhere on the board
/Filters/IPM_Temp: C70.1, R80.2, TP3.1 (1_1); also elsewhere on the board
/Filters/VFO_In: C74.1, R80.1, R81.2, R82.2, R83.2; also elsewhere on the board
/Filters/Volt_U_In: C52.1, C95.1; also elsewhere on the board
/Filters/Volt_V_In: C58.1, C96.1; also elsewhere on the board
/Filters/Volt_W_In: C94.1, C97.1; also elsewhere on the board
/Phases/Curr_U: R67.2; also elsewhere on the board
/Phases/Curr_V: R72.2; also elsewhere on the board
/Phases/Curr_W: R78.2; also elsewhere on the board
GND: C48.2, C49.2, C50.2, C53.2, C57.2, C59.2, C60.2, C63.2, C66.2, C67.2, C68.2, C70.2, C71.2, C74.2, C77.2, C95.2, C96.2, C97.2, U10.3 (GND), U11.1, U11.3 (GND), U12.1, U12.3 (GND), U13.3 (GND), U14.1, U14.3 (GND), U17.3 (GND); also elsewhere on the board
unnamed: C48.1, U10.2
unnamed: C52.2, U11.2
unnamed: C57.1, U13.2
unnamed: C58.2, U12.2
unnamed: C66.1, U17.2
unnamed: C94.2, U14.2
unnamed: R79.2, R81.1

Notes on the sheet:
VFO Pin is also UVLO and OC fault output
