NovaPrime18/CompressorController/Hardware/CompressorController.kicad_pcb

## KiCad design Hardware/CompressorController.kicad_pcb (continued)

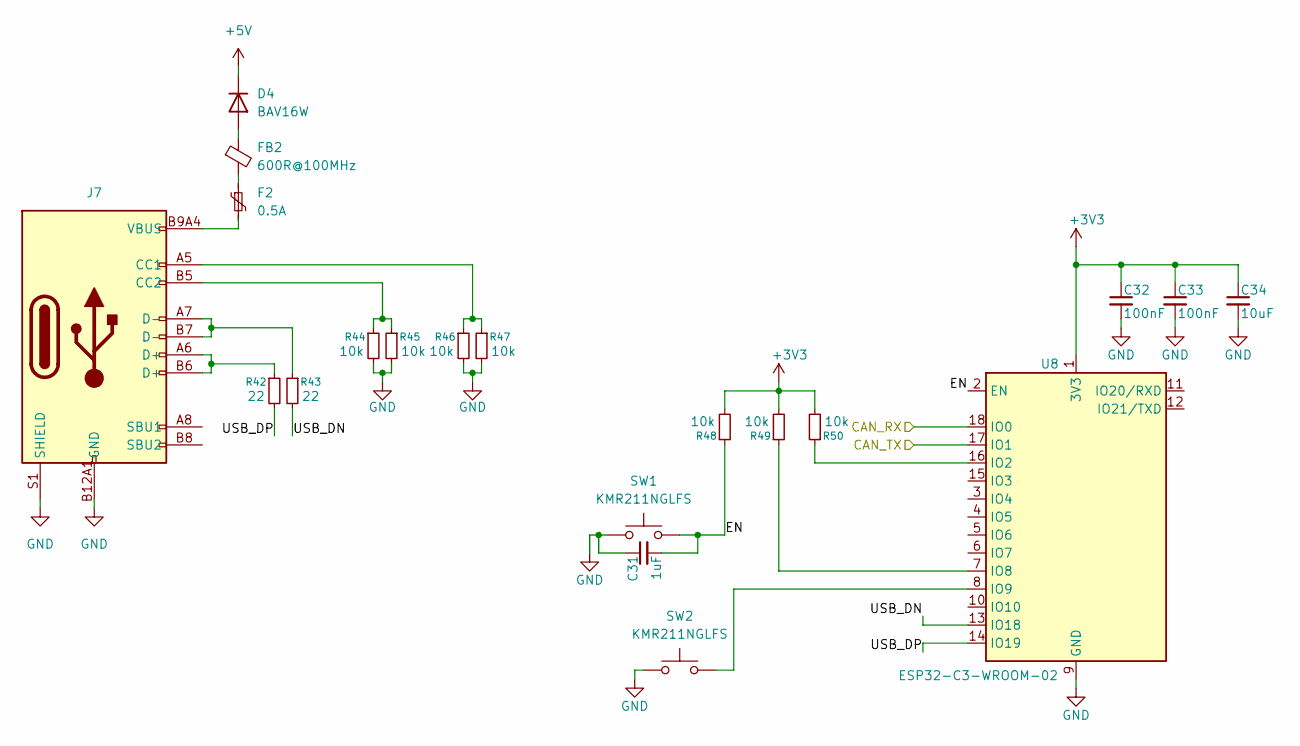
[picture p59: schematic express.kicad_sch, Mains Powered VESC MD]

Parts:
C31: 1uF; C_0603_1608Metric; LCSC C15849
C32, C33: 100nF; C_0603_1608Metric; LCSC C14663
C34: 10uF; C_0805_2012Metric; LCSC C440198
D4: BAV16W; D_SOD-123; JLC C459527
F2: 0.5A; R_0805_2012Metric; JLC C2833485
FB2: 600R@100MHz; L_0603_1608Metric; LCSC C1002
J7: Connector, USB-TYPE-C-16P; TYPE-C-SMD_HX-TYPE-C-16PIN; LCSC C2927039
R42, R43: 22; R_0603_1608Metric; LCSC C23345
R44, R45, R46, R47, R48, R49, R50: 10k; R_0603_1608Metric; LCSC C25804
SW1, SW2: KMR211NGLFS; SW_Push_1P1T_NO_CK_KMR2; JLC C221676
U8: ESP32-C3-WROOM-02; JLC C2934560

Connections:
+3V3: C32.1, C33.1, C34.1, R48.2, R49.2, R50.2, U8.1 (3V3); also elsewhere on the board
+5V: D4.1 (K); also elsewhere on the board
/CAN1/RX: U8.18 (IO0); also elsewhere on the board
/CAN1/TX: U8.17 (IO1); also elsewhere on the board
/WiFi & BT/EN: C31.2, R48.1, SW1.2, U8.2 (EN)
/WiFi & BT/USB_DN: R43.2, U8.13 (IO18)
/WiFi & BT/USB_DP: R42.2, U8.14 (IO19)
GND: C31.1, C32.2, C33.2, C34.2, J7.A12B1 (GND), J7.B12A1 (GND), J7.S1 (SHIELD), R44.2, R45.2, R46.2, R47.2, SW1.1, SW2.1, U8.9 (GND), U8.19 (GND); also elsewhere on the board
unnamed: D4.2 (A), FB2.1
unnamed: F2.1, FB2.2
unnamed: F2.2, J7.A9B4 (VBUS), J7.B9A4 (VBUS)
unnamed: J7.A5 (CC1), R46.1, R47.1
unnamed: J7.B5 (CC2), R44.1, R45.1
unnamed: J7.A6 (D+), J7.B6 (D+), R42.1
unnamed: J7.A7 (D-), J7.B7 (D-), R43.1
unnamed: R50.1, U8.16 (IO2)
unnamed: R49.1, U8.7 (IO8)
unnamed: SW2.2, U8.8 (IO9)

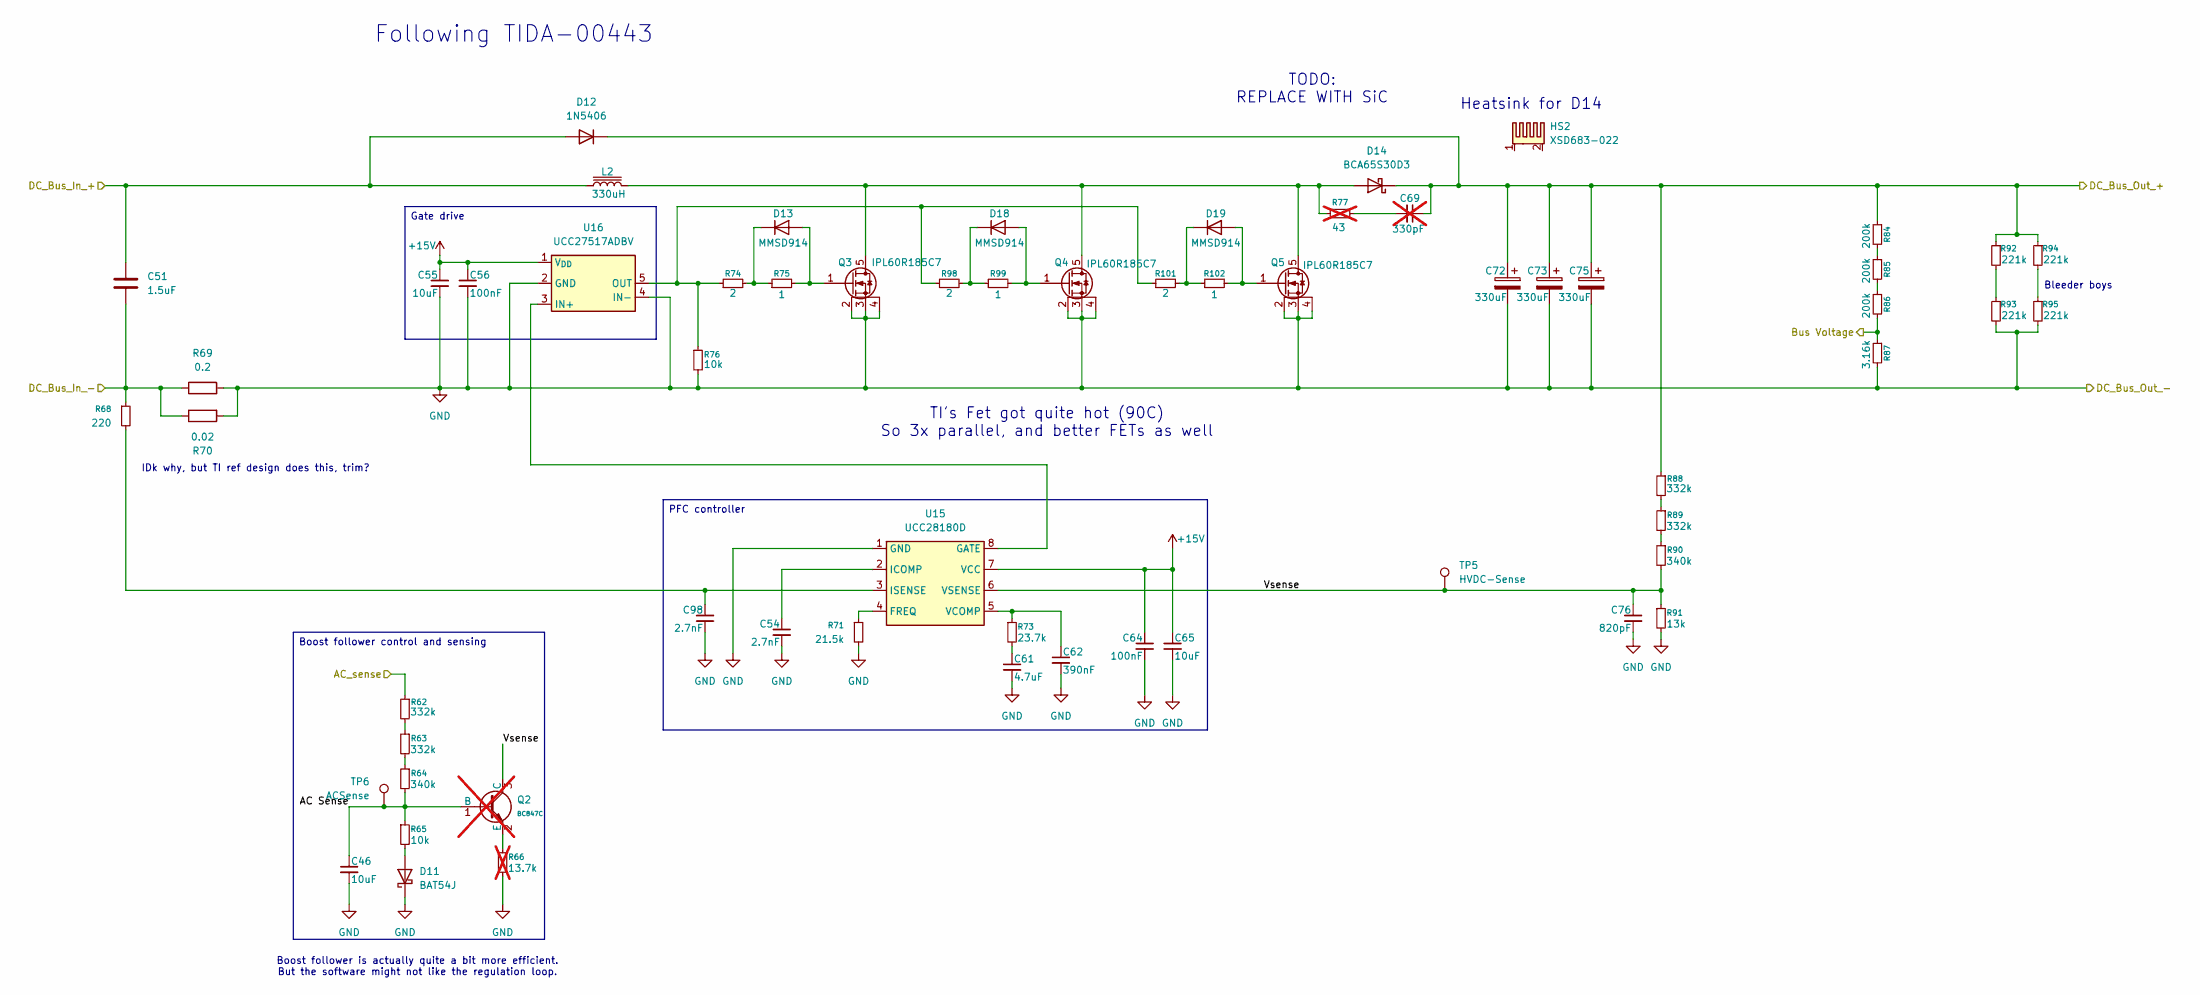
[picture p60: schematic pfc.kicad_sch, Mains Powered VESC MD]

Parts:
C46, C55, C65: 10uF; C_0805_2012Metric; LCSC C440198
C51: 1.5uF; C_Rect_L24.0mm_W10.1mm_P22.50mm_MKT; partnm B32923C3155M; JLC C47279087
C54, C98: 2.7nF; C_0603_1608Metric; LCSC C1609
C56, C64: 100nF; C_0603_1608Metric; LCSC C14663
C61: 4.7uF; C_0603_1608Metric; LCSC C19666
C62: 390nF; C_0603_1608Metric; LCSC C376833
C69: 330pF; C_1808_4520Metric; not fitted
C72, C73, C75: 330uF; CP_Radial_D30.0mm_P10.00mm_SnapIn; LCSC C7211174
C76: 820pF; C_0603_1608Metric; LCSC C1632
D11: BAT54J; D_SOD-323F; LCSC C12744
D12: 1N5406; D_DO-201AD_P15.24mm_Horizontal; LCSC C38409
D13, D18, D19: MMSD914; D_SOD-123; LCSC C27975268
D14: BCA65S30D3; TO-247-2_Vertical; JLC C42401690
HS2: XSD683-022; HEATSINK-TH_L35.5-W11.0-XSD683-022; JLC C286231
L2: 330uH; IND-TH_L33.0-W15.6-P15.00-D1.5; LCSC C52766608
Q2: BC847C; Q_SOT-23; Part BC847C; LCSC C7420337; not fitted
Q3, Q4, Q5: IPL60R185C7; VSON-4_L8.1-W8.1-P2.00-BL; JLC C537028
R62, R63, R88, R89: 332k; R_1206_3216Metric; LCSC C49010117
R64, R90: 340k; R_1206_3216Metric; LCSC C2999478
R65, R76: 10k; R_0603_1608Metric; LCSC C25804
R66: 13.7k; R_0603_1608Metric; LCSC C22793; not fitted
R68: 220; R_0603_1608Metric; LCSC C22962
R69: 0.2; R_2512_6332Metric; LCSC C5375488
R70: 0.02; R_2512_6332Metric; LCSC C5375467
R71: 21.5k; R_0603_1608Metric; LCSC C22911
R73: 23.7k; R_0603_1608Metric; LCSC C22912
R74, R98, R101: 2; R_1206_3216Metric; LCSC C2907468
R75, R99, R102: 1; R_1206_3216Metric; LCSC C17928
R77: 43; R_2512_6332Metric; LCSC C2930460; not fitted
R84, R85, R86: 200k; R_1206_3216Metric; LCSC C17954
R87: 3.16k; R_0805_2012Metric; LCSC C52603
R91: 13k; R_0603_1608Metric; LCSC C22797
R92, R93, R94, R95: 221k; R_1206_3216Metric; LCSC C872617
TP5: HVDC-Sense; TestPoint_Pad_D1.5mm
TP6: ACSense; TestPoint_Pad_D1.5mm
U15: UCC28180D; SOIC-8_3.9x4.9mm_P1.27mm; JLC C88567
U16: UCC27517ADBV; SOT-23-5; JLC C2653784

Connections:
+15V: C55.1, C56.1, C64.1, C65.1, U15.7 (VCC), U16.1 (V_{DD}); also elsewhere on the board
/MCU/Bus Voltage: R86.2, R87.1; also elsewhere on the board
/PFC/AC Sense: C46.1, Q2.1 (B), R64.2, R65.1, TP6.1 (1_1)
/PFC/AC_sense: R62.1; also elsewhere on the board
/PFC/DC_Bus_In_+: C51.1, D12.2 (A), L2.1; also elsewhere on the board
/PFC/DC_Bus_In_-: C51.2, R68.1, R69.1, R70.1; also elsewhere on the board
/PFC/Vsense: C76.1, Q2.3 (C), R90.2, R91.1, TP5.1 (1_1), U15.6 (VSENSE)
/Phases/DC Bus +: C69.1, C72.1, C73.1, C75.1, D12.1 (K), D14.1 (K), R84.1, R88.1, R92.1, R94.1; also elsewhere on the board
GND: C46.2, C54.2, C55.2, C56.2, C61.2, C62.2, C64.2, C65.2, C72.2, C73.2, C75.2, C76.2, C98.2, D11.1 (K), Q3.2 (S), Q3.3 (S), Q3.4 (S), Q4.2 (S), Q4.3 (S), Q4.4 (S), Q5.2 (S), Q5.3 (S), Q5.4 (S), R66.2, R69.2, R70.2, R71.2, R76.2, R87.2, R91.2, R93.2, R95.2, U15.1 (GND), U16.2 (GND), U16.4 (IN-); also elsewhere on the board
unnamed: C61.1, R73.2
unnamed: C69.2, R77.2
unnamed: D11.2 (A), R65.2
unnamed: D13.2 (A), Q3.1 (G), R75.2
unnamed: D13.1 (K), R74.2, R75.1
unnamed: D14.2 (A), L2.2, Q3.5 (D), Q4.5 (D), Q5.5 (D), R77.1
unnamed: D18.2 (A), Q4.1 (G), R99.2
unnamed: D18.1 (K), R98.2, R99.1
unnamed: D19.2 (A), Q5.1 (G), R102.2
unnamed: D19.1 (K), R101.2, R102.1
unnamed: Q2.2 (E), R66.1
unnamed: R62.2, R63.1
unnamed: R63.2, R64.1
unnamed: R84.2, R85.1
unnamed: R85.2, R86.1
unnamed: R88.2, R89.1
unnamed: R89.2, R90.1
unnamed: R92.2, R93.1
unnamed: R94.2, R95.1
unnamed: R71.1, U15.4 (FREQ)
unnamed: U15.8 (GATE), U16.3 (IN+)
unnamed: C54.1, U15.2 (ICOMP)
unnamed: C98.1, R68.2, U15.3 (ISENSE)
unnamed: C62.1, R73.1, U15.5 (VCOMP)
unnamed: R74.1, R76.1, R98.1, R101.1, U16.5 (OUT)

Notes on the sheet:
Heatsink for D14
Following TIDA-00443
TI's Fet got quite hot (90C) So 3x parallel, and better FETs as well
IDk why, but TI ref design does this, trim?
Boost follower is actually quite a bit more efficient. But the software might not like the regulation loop.
Bleeder boys
TODO: REPLACE WITH SiC
Gate drive
PFC controller
Boost follower control and sensing

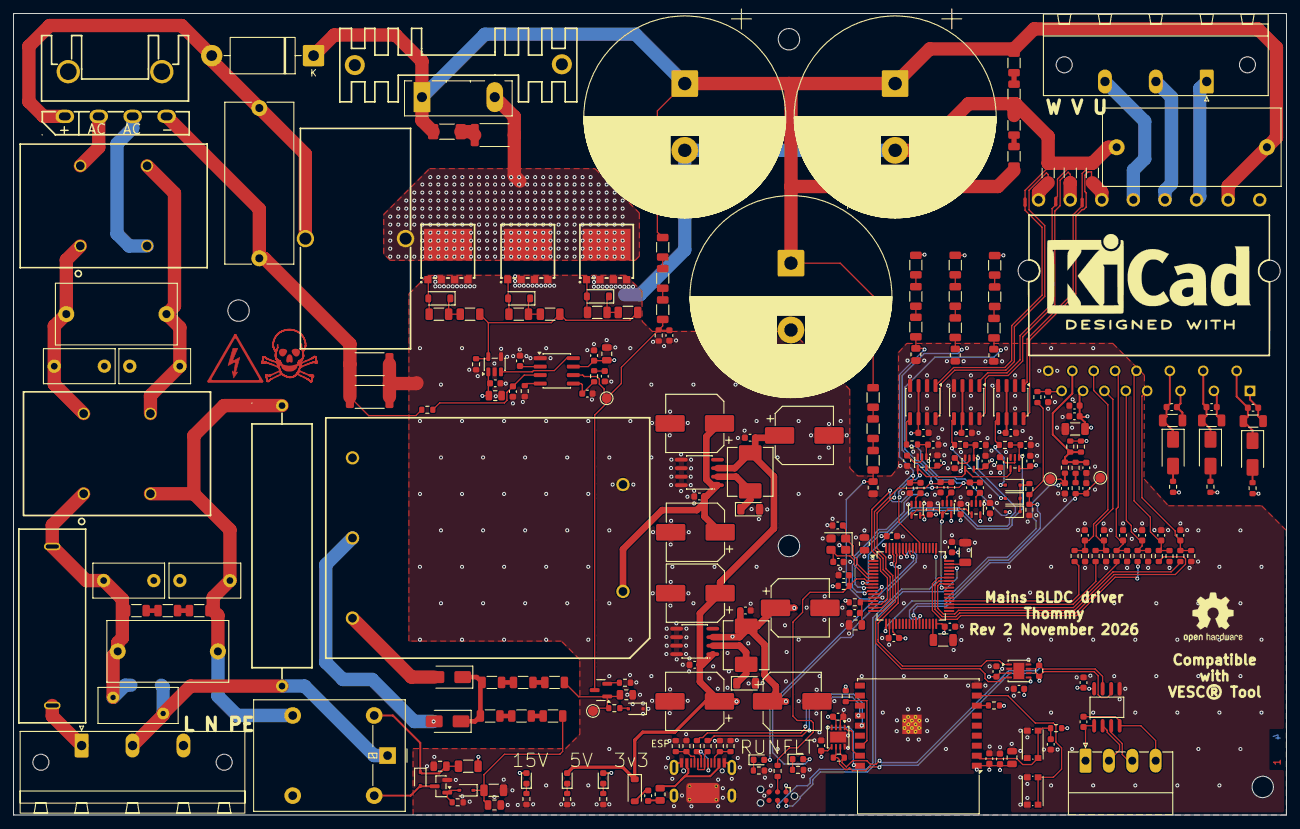
[picture p61: board CompressorController.kicad_pcb from above]

Board: 4 copper layers, 190.6 x 120.0 mm, 279 parts (1 on the bottom side), 154 nets.
