NovaPrime18/CompressorController/(commit log)

2026-04-03 Added JLC part Nmrs, added a lot of footprints
    [CompressorController.kicad_pcb, CompressorController.kicad_sch, MCU.kicad_sch, can.kicad_sch, express.kicad_sch, filters.kicad_sch, isolator.kicad_sch, lvpower.kicad_sch]
2026-04-17 Added full PFC schematic
    [CompressorController.kicad_pcb, CompressorController.kicad_sch, MCU.kicad_sch, can.kicad_sch, express.kicad_sch, filters.kicad_sch, isolator.kicad_sch, lvpower.kicad_sch]
2026-04-17 Added the last components, and LCSC IDs.
    [CompressorController.kicad_pcb, CompressorController.kicad_sch, MCU.kicad_sch, can.kicad_sch, express.kicad_sch, filters.kicad_sch, isolator.kicad_sch, lvpower.kicad_sch]
2026-04-17 3v3 Buck, Heatsink for Bridge, 3x PFC FET
    [CompressorController.kicad_pcb, CompressorController.kicad_sch, MCU.kicad_sch, express.kicad_sch, filters.kicad_sch, isolator.kicad_sch, lvpower.kicad_sch, pfc.kicad_sch]
2026-04-18 Fixed ISENSE connection being high-side
    [pfc.kicad_sch]
2026-05-06 Placed components on board
    [CompressorController.kicad_pcb, CompressorController.kicad_sch, lvpower.kicad_sch, pfc.kicad_sch, phases.kicad_sch, powerin.kicad_sch]
2026-06-23 Routed the PCB
    [CompressorController.kicad_pcb, MCU.kicad_sch, express.kicad_sch]
2026-06-23 Revise README for Mains Powered VESC Motor Driver
    Updated project name and expanded the overview section to provide detailed information about the VESC-compatible motor driver. Added key features, block diagram, schematic hierarchy, firmware details, regulatory compliance targets, safety warnings, license information, and contributing guidelines.
2026-07-20 Ordered revision
    [CompressorController.kicad_pcb, CompressorController.kicad_sch, filters.kicad_sch, pfc.kicad_sch, phases.kicad_sch, powerin.kicad_sch]
2026-07-20 shuffeled folders around
    [CompressorController.kicad_pcb, CompressorController.kicad_sch, MCU.kicad_sch, can.kicad_sch, driver.kicad_sch, express.kicad_sch, filters.kicad_sch, isolator.kicad_sch]
2026-07-21 Edited U15 footprint
    [CompressorController.kicad_pcb, pfc.kicad_sch]
2026-08-07 Added firmware, fixed CAN pinout
    [CompressorController.kicad_pcb, CompressorController.kicad_sch, express.kicad_sch]
2026-11-11 R2 placement done, schematic polishes
    [CompressorController.kicad_pcb, CompressorController.kicad_sch, MCU.kicad_sch, filters.kicad_sch, lvpower.kicad_sch, pfc.kicad_sch, phases.kicad_sch]
2026-11-11 mid-routing save
    [CompressorController.kicad_pcb, phases.kicad_sch]
2026-11-11 Finished! <3
    [CompressorController.kicad_pcb]
2026-11-12 Ordered rev2
    [CompressorController.kicad_pcb, pcb_fps.json, pfc.kicad_sch, phases.kicad_sch, powerin.kicad_sch]
