NovaPrime18/CompressorController/(notices)

Notices in the files:
README.md:
License: CERN-OHL
